harshwardhangiri/CV-Based-Robotic-Arm-TA212-/media/WhatsApp Image 2026-04-21 at 16.33.04.jpeg

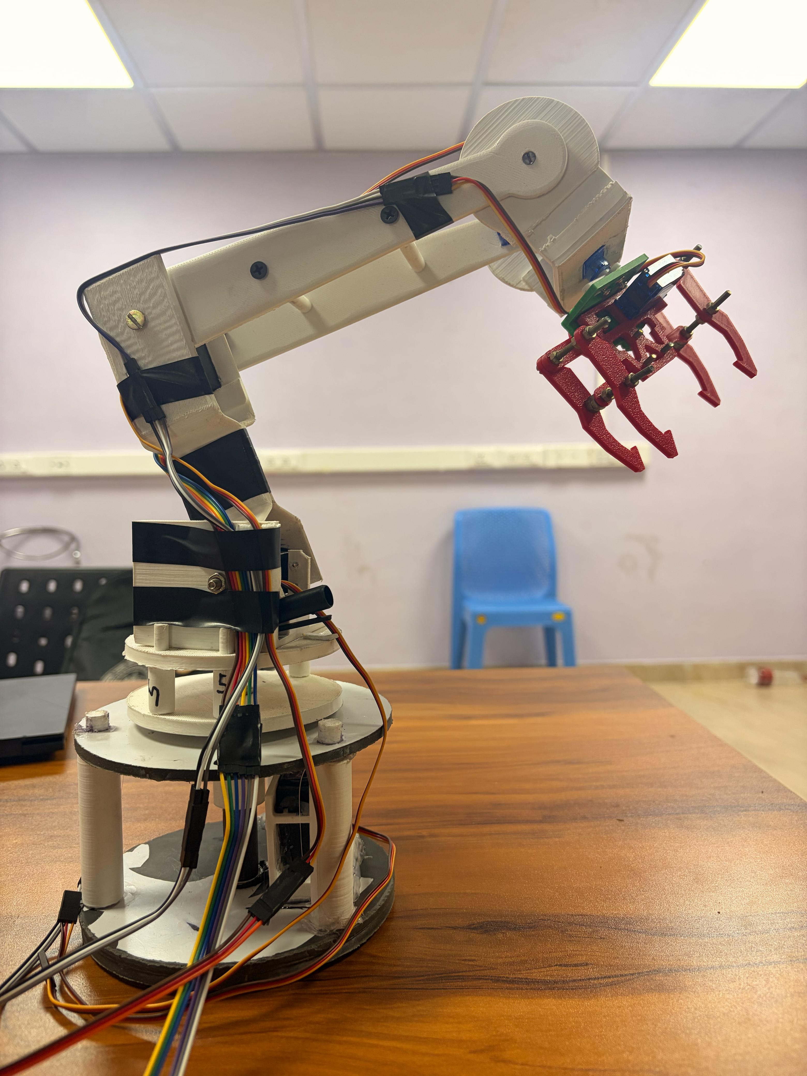
media/WhatsApp Image 2026-04-21 at 16.33.04.jpeg
