harshwardhangiri/CV-Based-Robotic-Arm-TA212-/Final Report G5.pdf

TA212

# Project Report

# Robotic Arm

# (Prof. Mohit Law)

# Group G5 (Tuesday)

## Bala Rohit (240255) Krishna Sharma (240564) Lakshya Arukiya (240589) Pradeep Bishnoi (240756) Harshwardhan Giri Goswami (240444) Ujjwal Raj (241112) Sunand Garg (241061)

Project Overview

The primary objective of this project is to develop an advanced 6-degree-of-freedom robotic arm that utilizes a computer vision interface for intuitive, contactless gesture-based control. The mechanical assembly consists of 21 distinct manufactured parts, featuring a robust foundation of ACP base plates and a high-density steel shaft to ensure structural stability during heavy base movements. While the out-of-pocket expenditure for newly purchased electrical components was strictly limited to ₹2,250, the actual comprehensive value of the prototype, factoring in all raw materials and extensive machining time for 3D printing and turning is calculated at ₹6,155. Potential future improvements for this system could focus on integrating high-resolution encoders for closed-loop positional feedback to eliminate servo jitter and implementing a wireless communication protocol to allow for remote operation in hazardous environments.

Table of Contents

S. No. | Content | Page No.
1 | Project Overview | 1
2 | Isometric Full View | 2
3 | Components Used | 3-4
4 | Detailed Torque Calculation | 5-6
5 | Orthographic Drawings | 7-23
6 | Circuit Diagram | 24
7 | Codes | 25-30
8 | Code Explanation | 31-34
9 | Bill of Materials and Cost Analysis | 35

# Isometric Full view

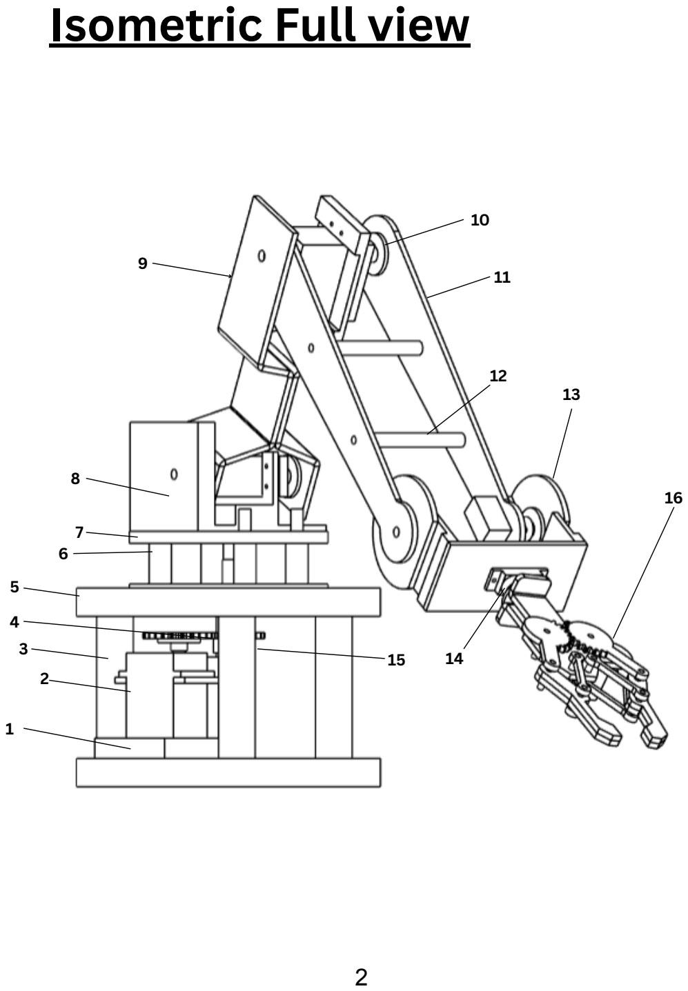
[picture p3: page 3]

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
15 14

16

Part no. | Part Name | Material | Qty
1 | Mounting 1 | 3D Printed | 1
2 | Servo (MG996R) | Purchased | 3
3 | Base Support | 3D Printed | 3
4 | Gear (a,b) | 3D Printed | 2
5 | Base plate A | ACP sheet | 2
6 | Spacer plate | 3D Printed | 3
7 | Base plate B | 3D Printed | 2
8 | Mounting 2 | 3D Printed | 1
9 | Arm (a,b) | 3D Printed | 2
10 | Motor Head | Purchased | 6
11 | Front Arm (a,b) | 3D Printed | 2
12 | Upper Arm Spacer | 3D Printed | 2
13 | Wrist Assemble | 3D Printed | 1
14 | Servo Motor (SG90) | Purchased | 3

15 | shaft | Metal | 1
16 | Gripper | 3D Printed | 1

## Detailed Torque Calculation and rationale for usage of electronics

### 1. Mass Estimation

Component | Mass (kg)
Upper Arm (PLA) | 0.04
Forearm (PLA) | 0.04
Wrist + Gripper | 0.05
MG996R Motors (3) | 0.165
SG90 Motors (3) | 0.027

### 2. Torque Formula

Torque is calculated using: τ = Σ(m × g × r), where g = 9.81 m/s².

### 3.1 Gripper Joint

τ = W × 9.81 × 0.05
Setting τ = 0.25 N·m ⇒ W = 0.25 / (9.81 × 0.05) ≈ 0.51 kg

### 3.2 Wrist Joint

τ = (0.059 + W) × 9.81 × 0.1 ⇒ (0.059 + W) × 0.981 = 0.25 ⇒ W ≈ 0.196 kg

### 3.3 Elbow Joint

τ = (0.04×9.81×0.09) + (0.05×9.81×0.18) + (0.009×9.81×0.18) + (W×9.81×0.2) τ = 0.139 + 1.962W
⇒ 0.139 + 1.962W = 1.08
⇒ W ≈ 0.48 kg

### 3.4 Shoulder Joint (Critical)

τ = (0.04×9.81×0.075) + (0.04×9.81×0.20) + (0.05×9.81×0.30) + (0.11×9.81×0.25) + (0.027×9.81×0.30) + (W×9.81×0.33)

τ = 0.603 + 3.237W
⇒ 0.603 + 3.237W = 1.08
⇒ W ≈ 0.147 kg

### 4. Final Result

Maximum payload is limited by shoulder joint ≈ 120–150 grams.

### 5. Electronics Justification

Arduino Uno is used for control and serial communication. PCA9685 driver ensures stable multi-servo PWM control at 50 Hz. Python + OpenCV enables gesture recognition.
Li-ion batteries provide sufficient current for servo motors.

### 7. Conclusion

The system is torque-limited at the shoulder joint. The design is optimized for lightweight operation and gesture-based control.

44 27 25

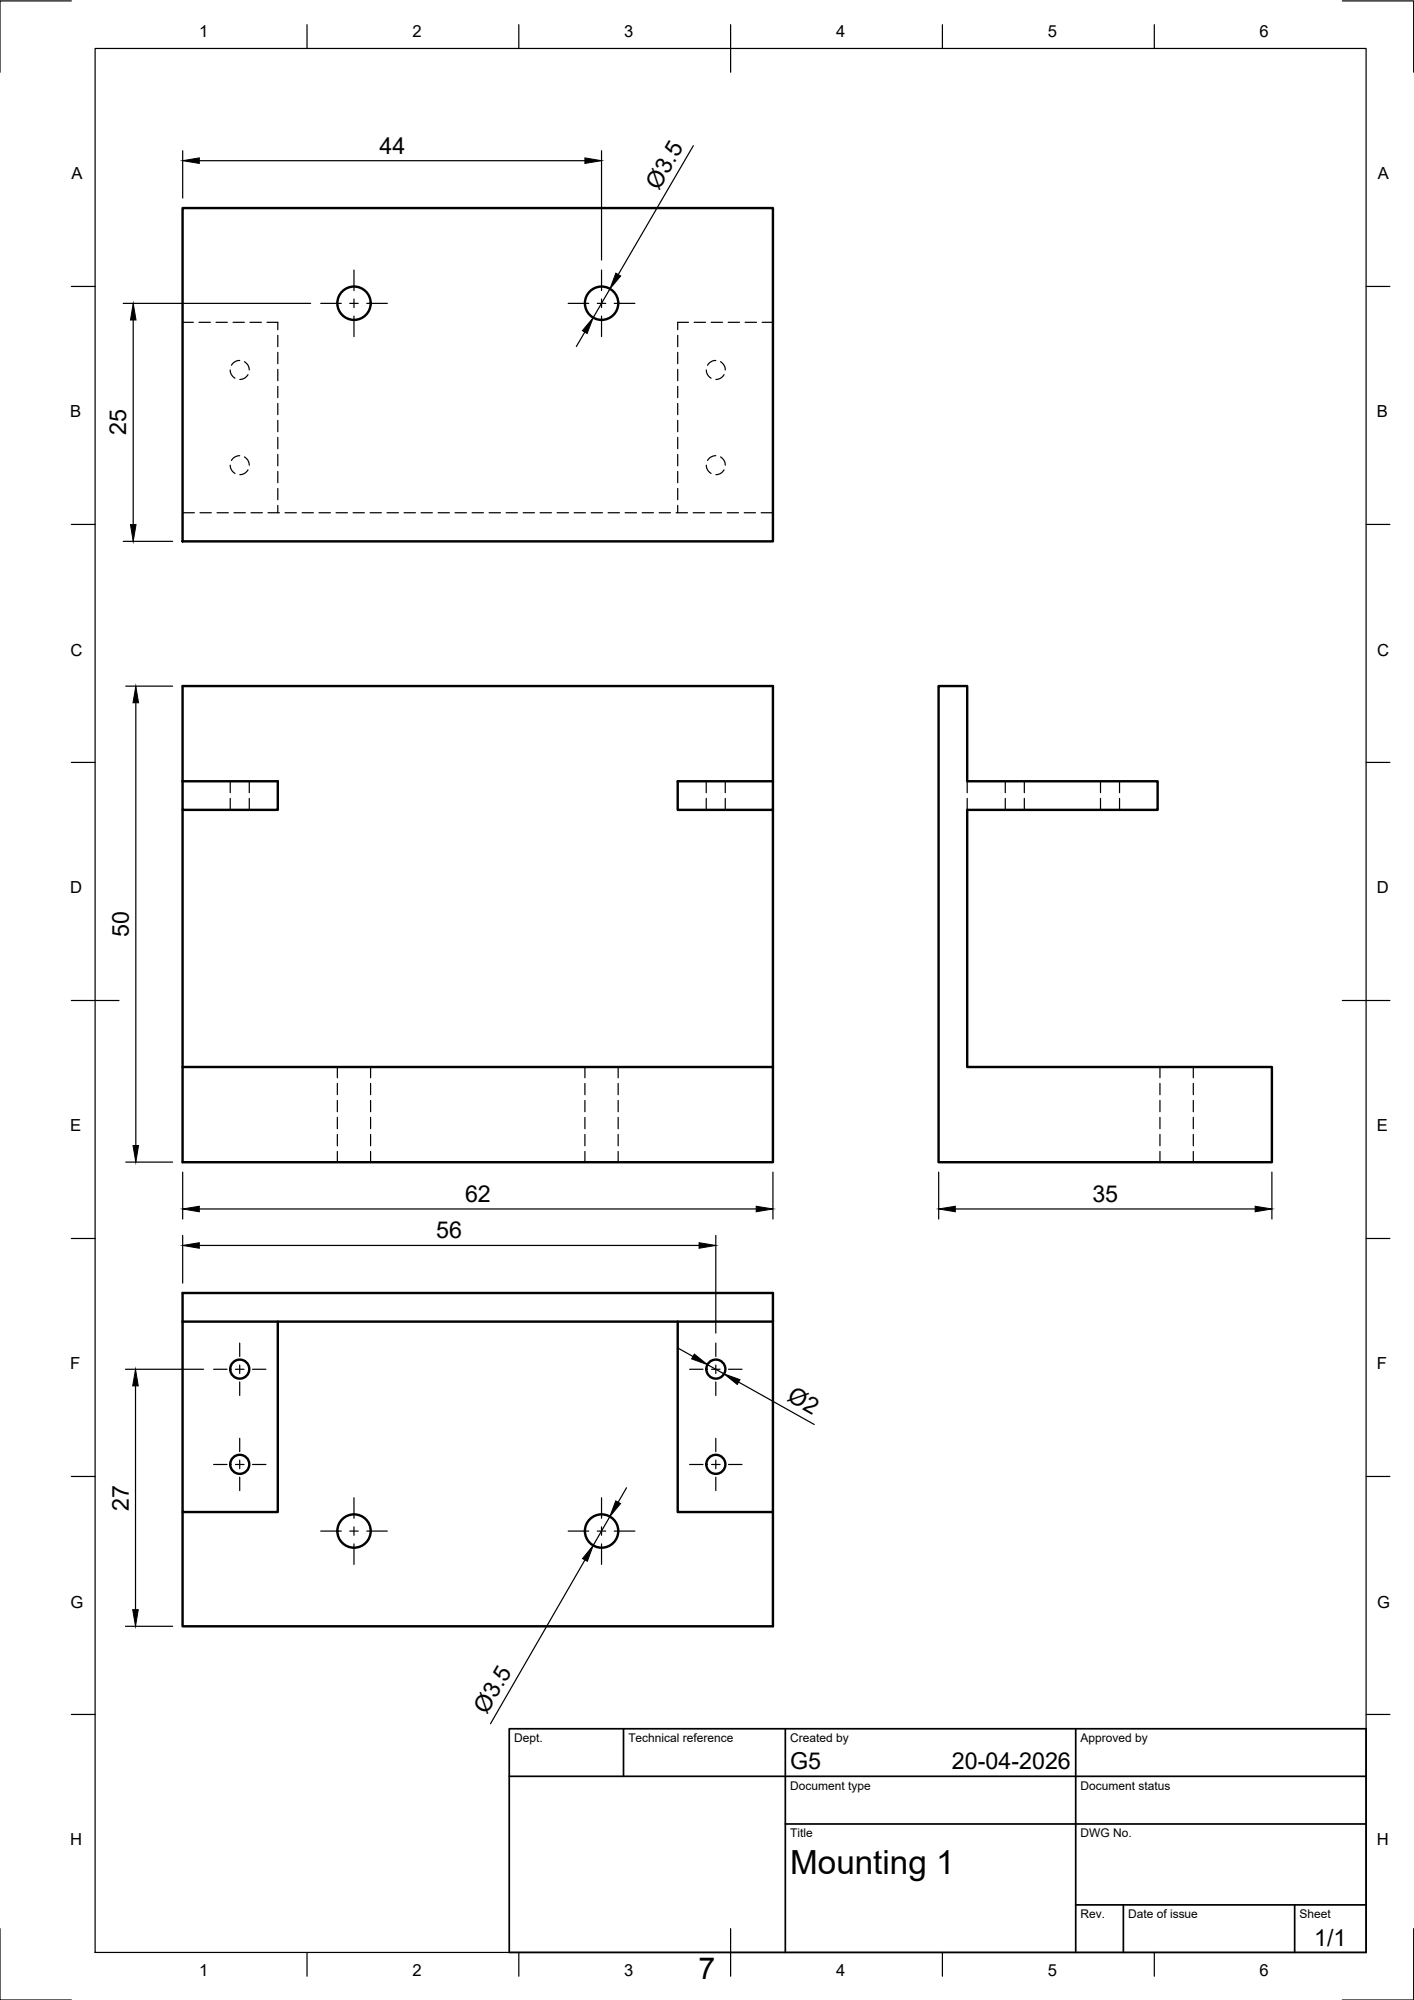
[picture p4: page 8]
Dept.; Technical reference; Created by; Approved by; Document type; Document status; Title; DWG No.; Rev.; Date of issue; Sheet; Mounting 1

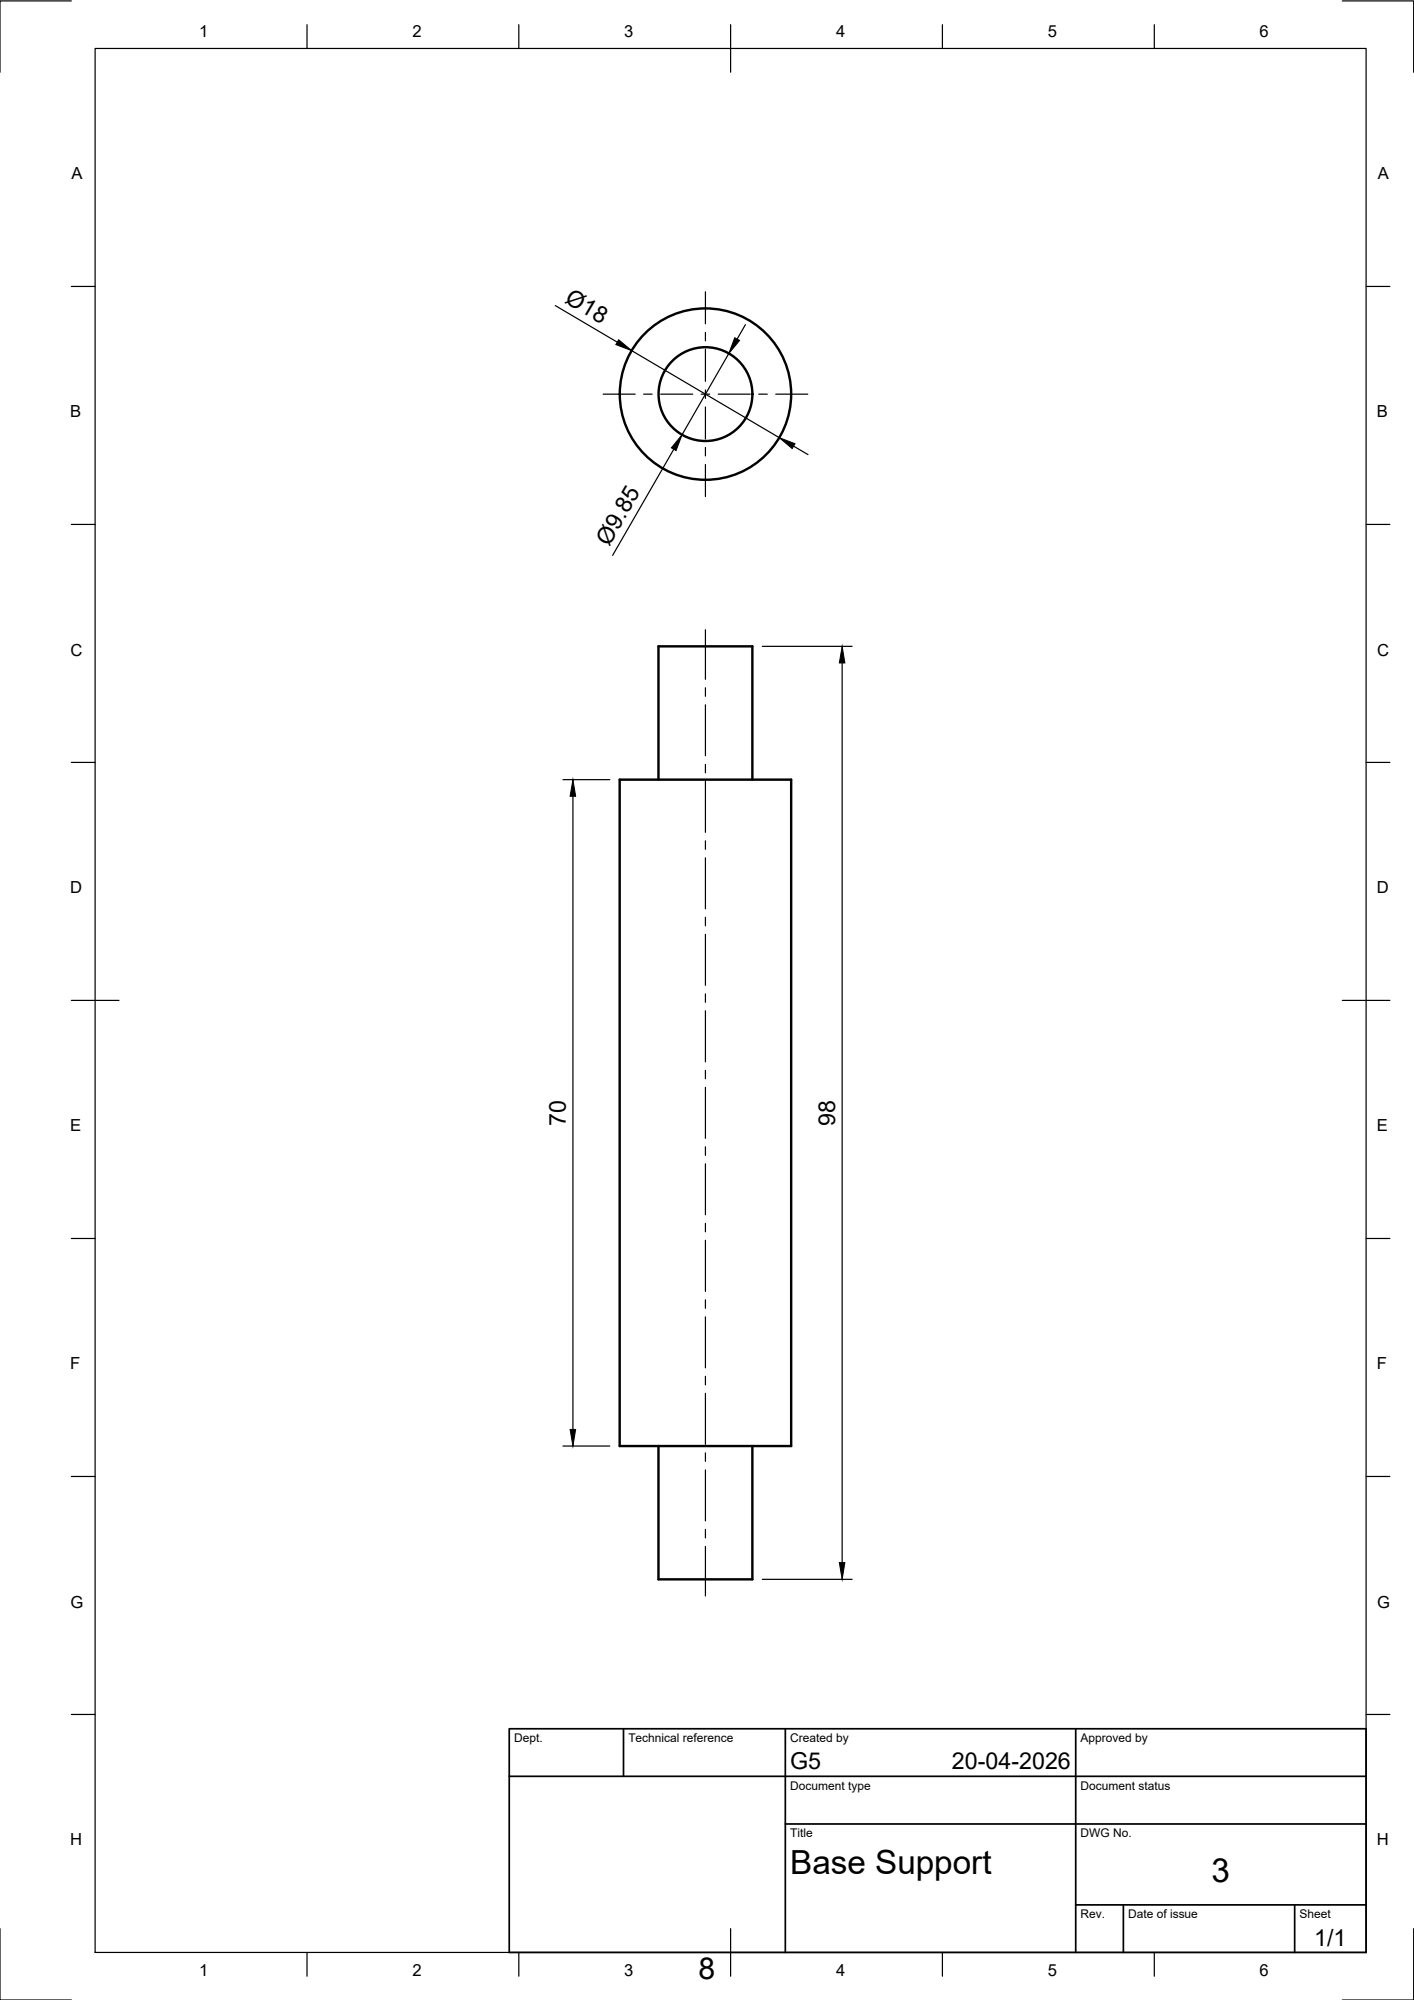
[picture p5: page 9]
Dept.; Technical reference; Created by; Approved by; Document type; Document status; Base Support

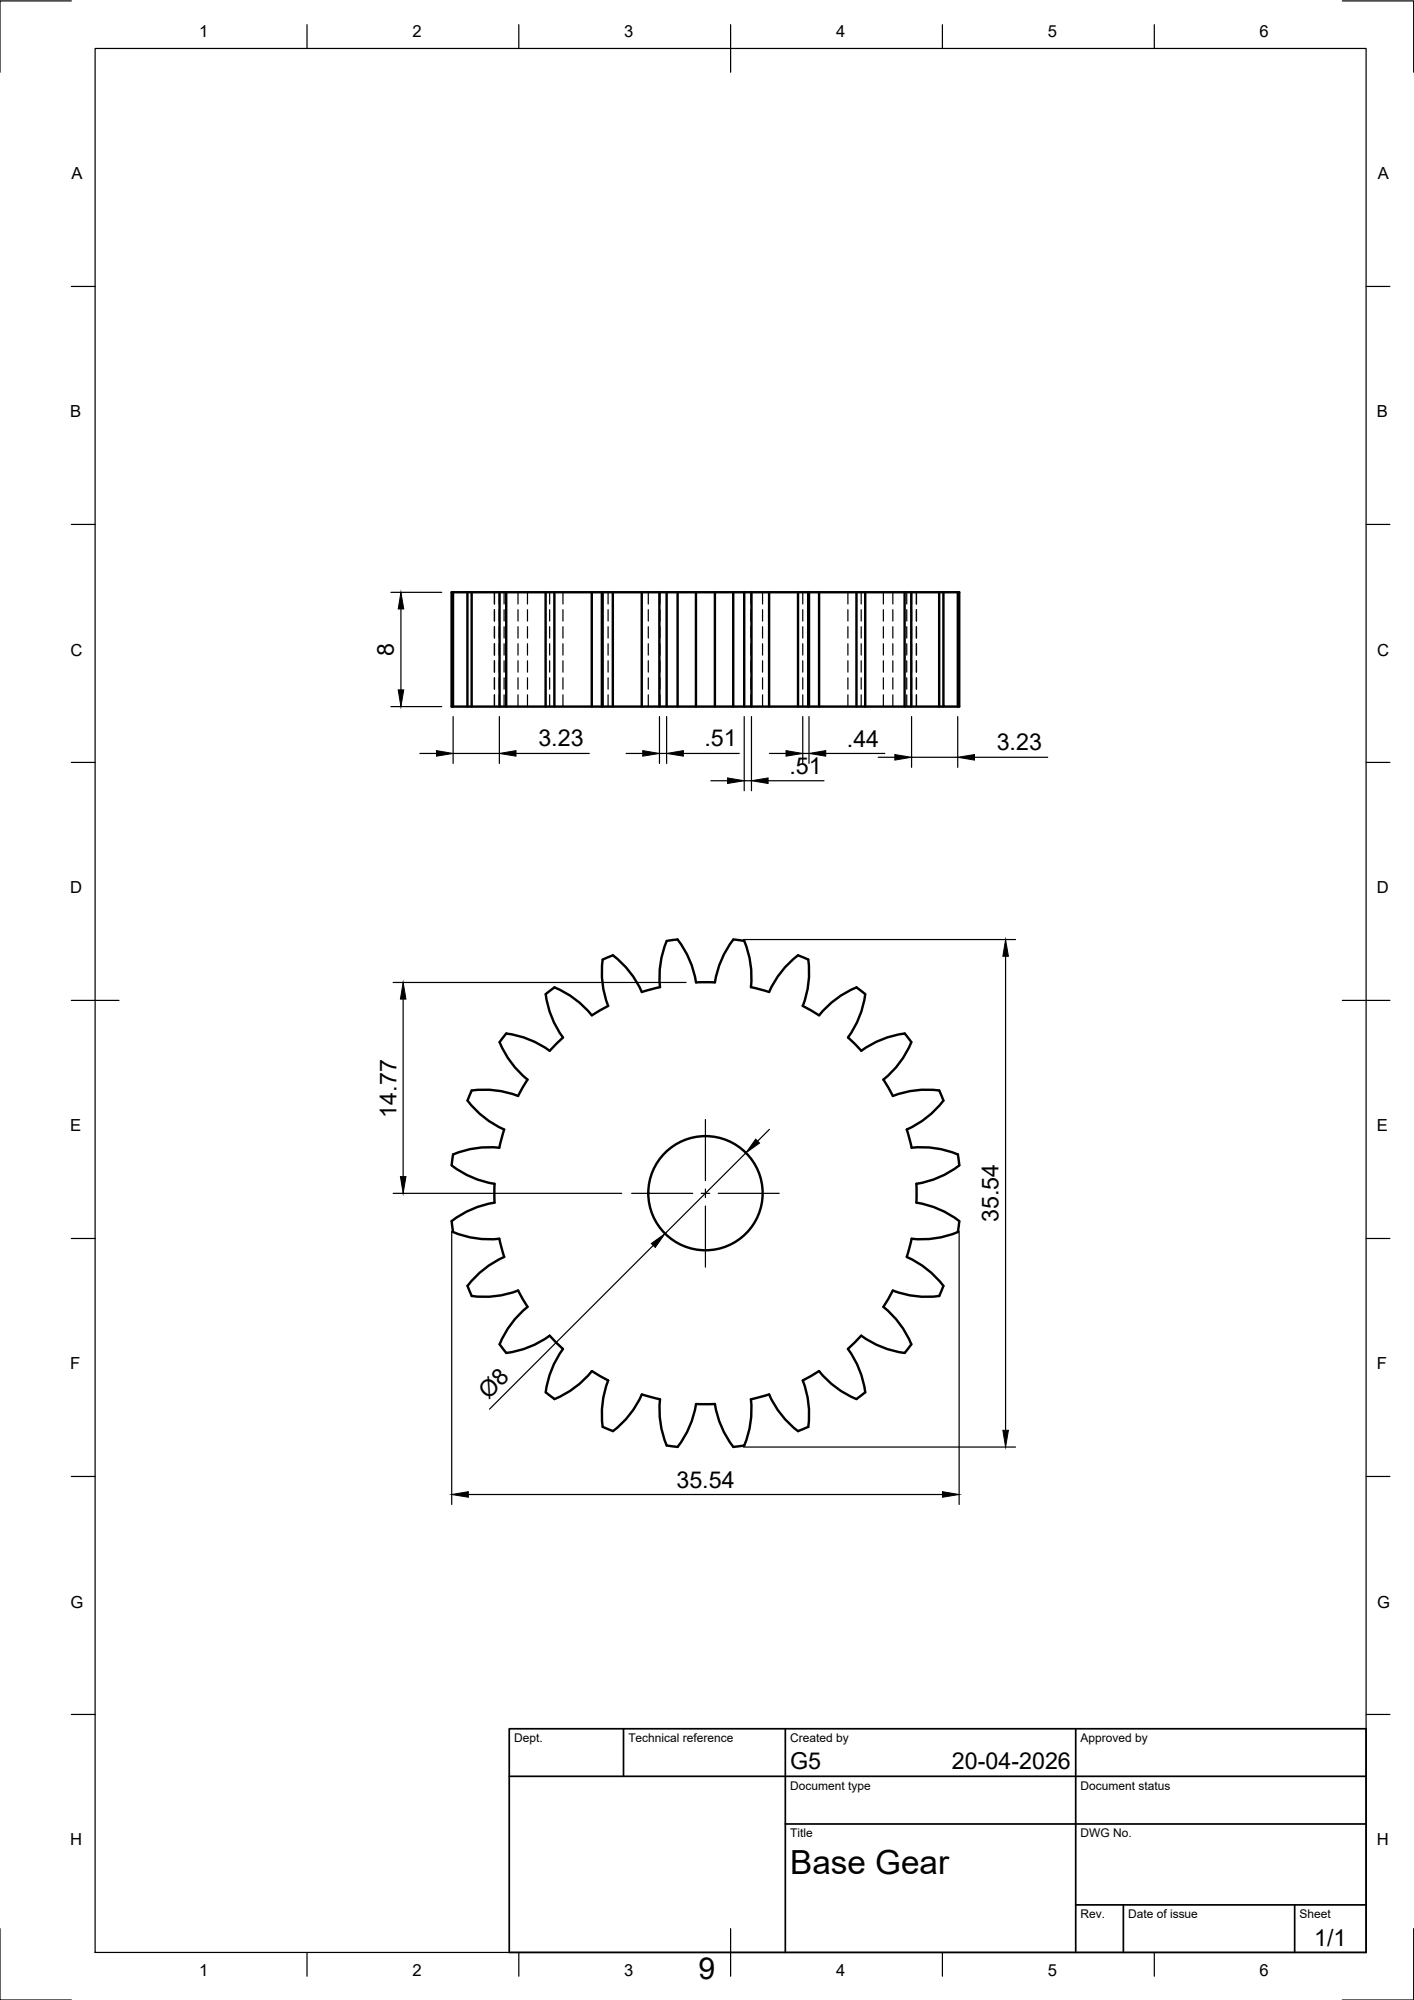
[picture p6: page 10]
Dept.; Technical reference; Created by; Approved by

Document type | Document status

Base Gear

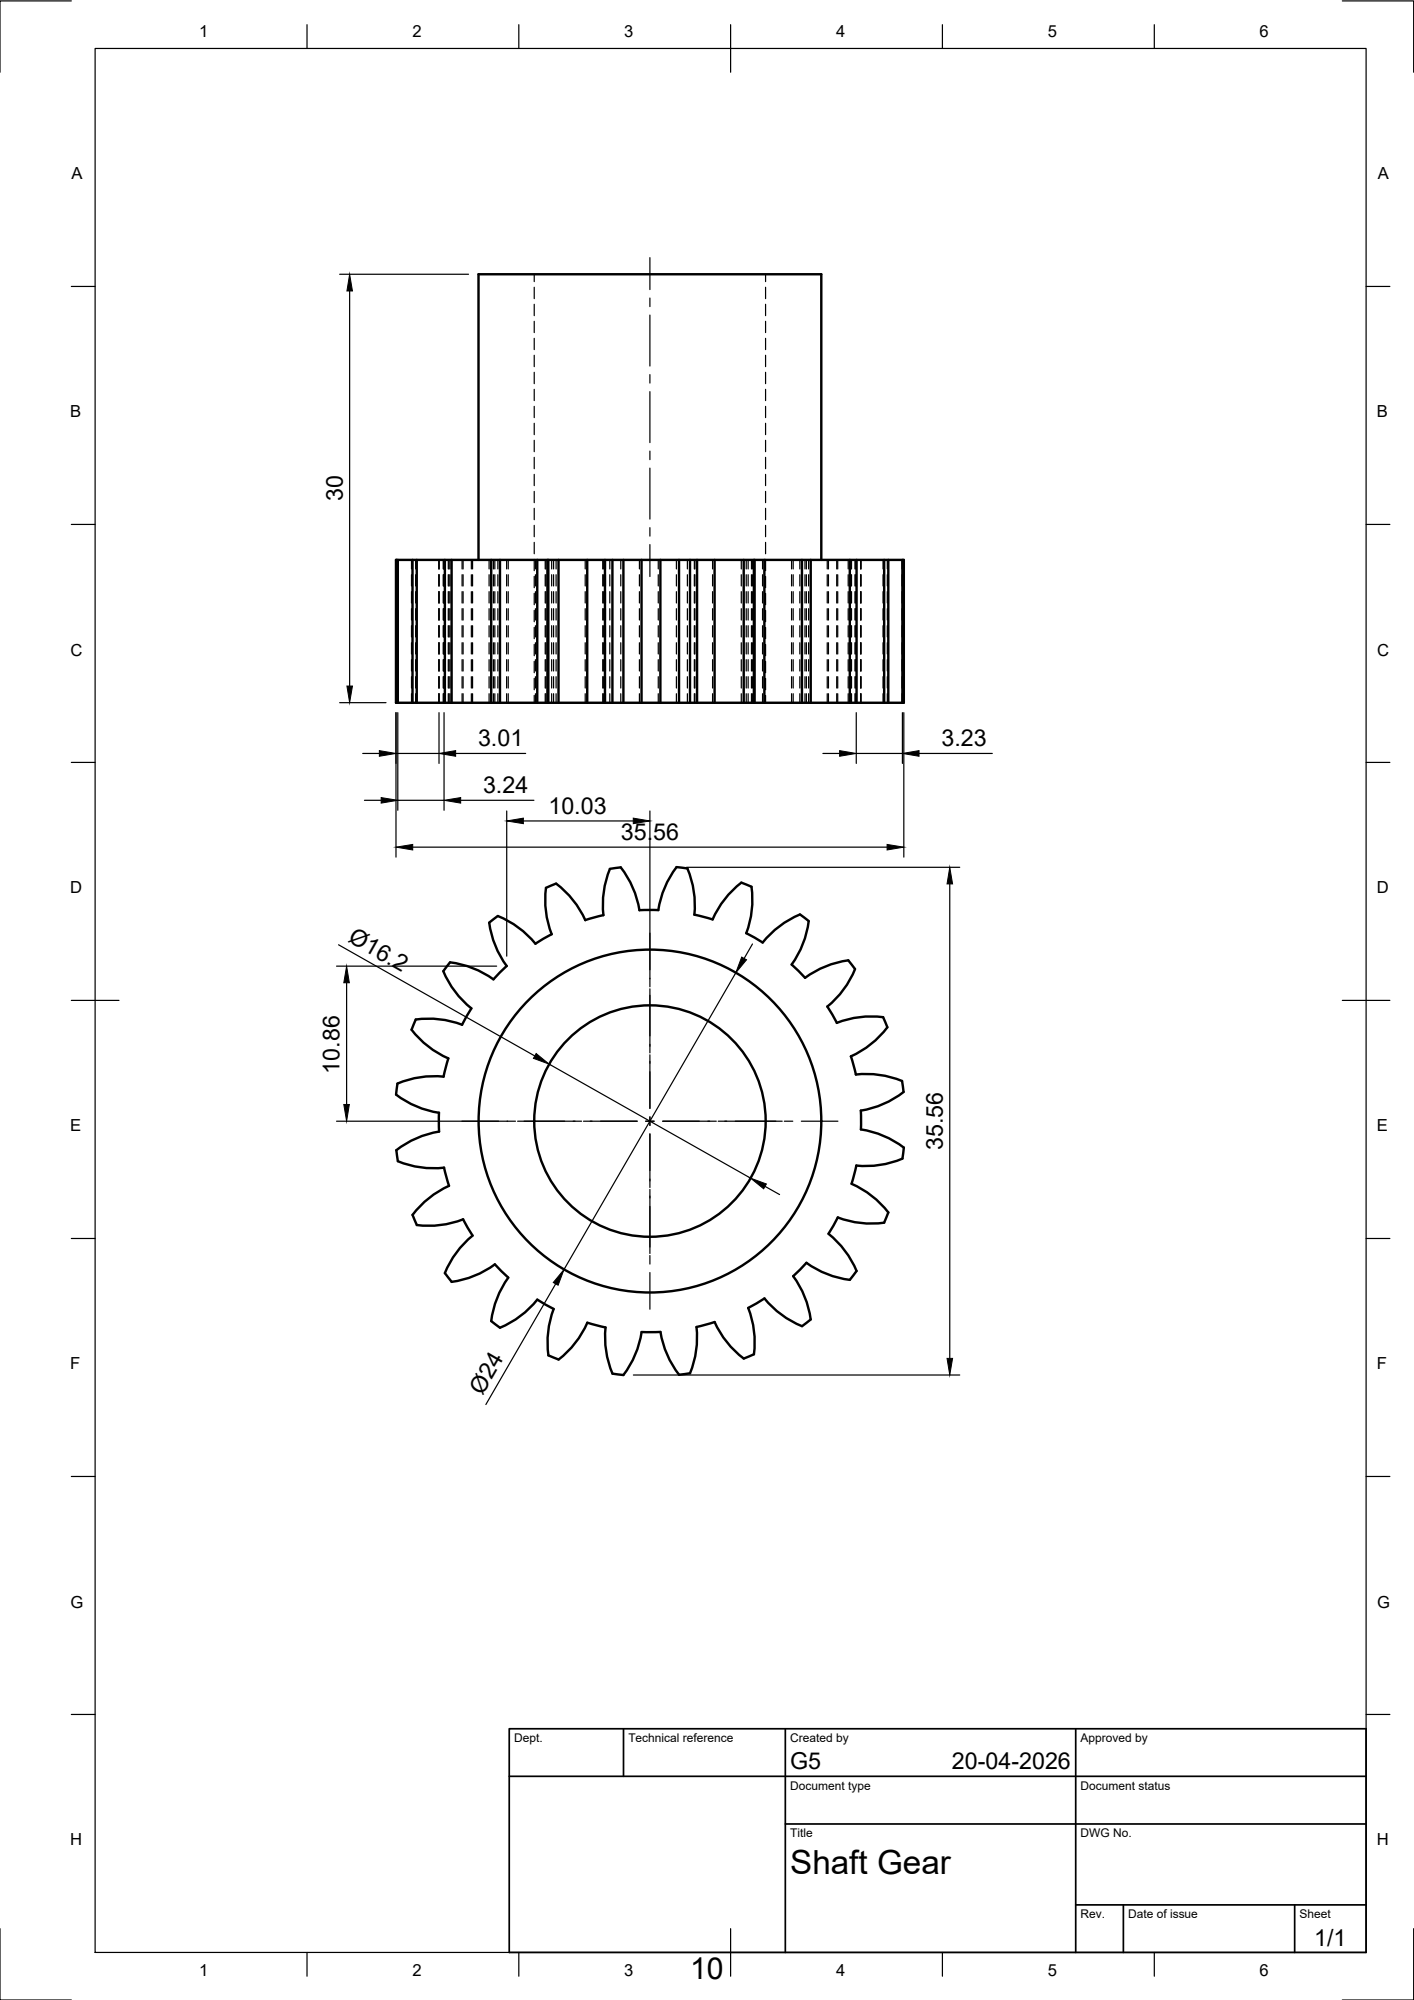
[picture p7: page 11]
Dept.; Technical reference; Created by; Approved by

Document type | Document status

Shaft Gear

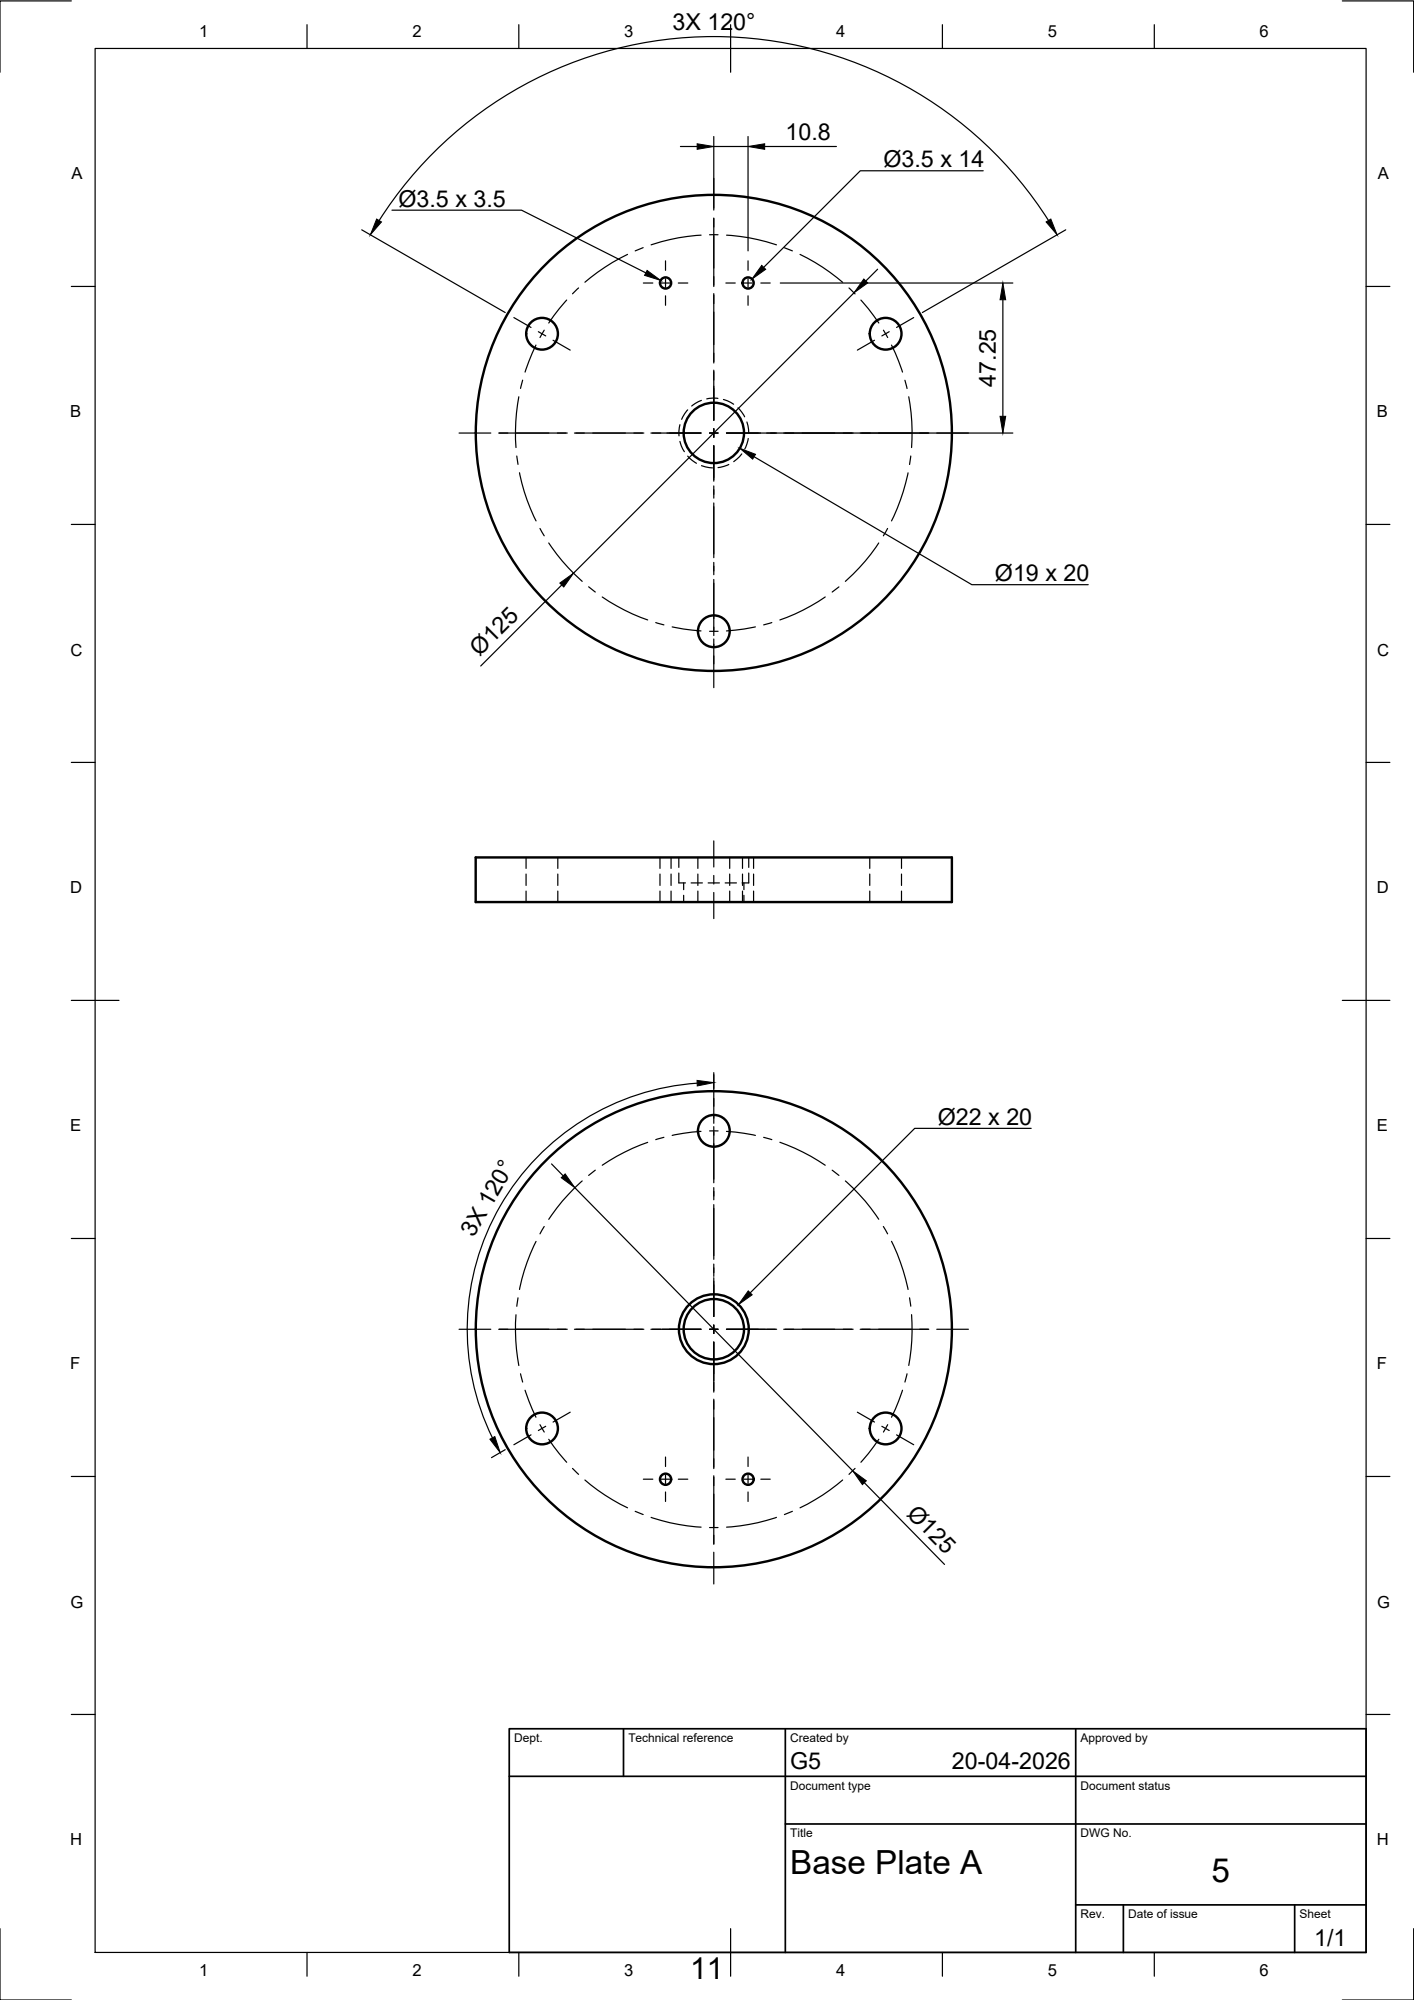
[picture p8: page 12]
Dept.; Technical reference; Created by; Approved by; Document type; Document status; Base Plate A

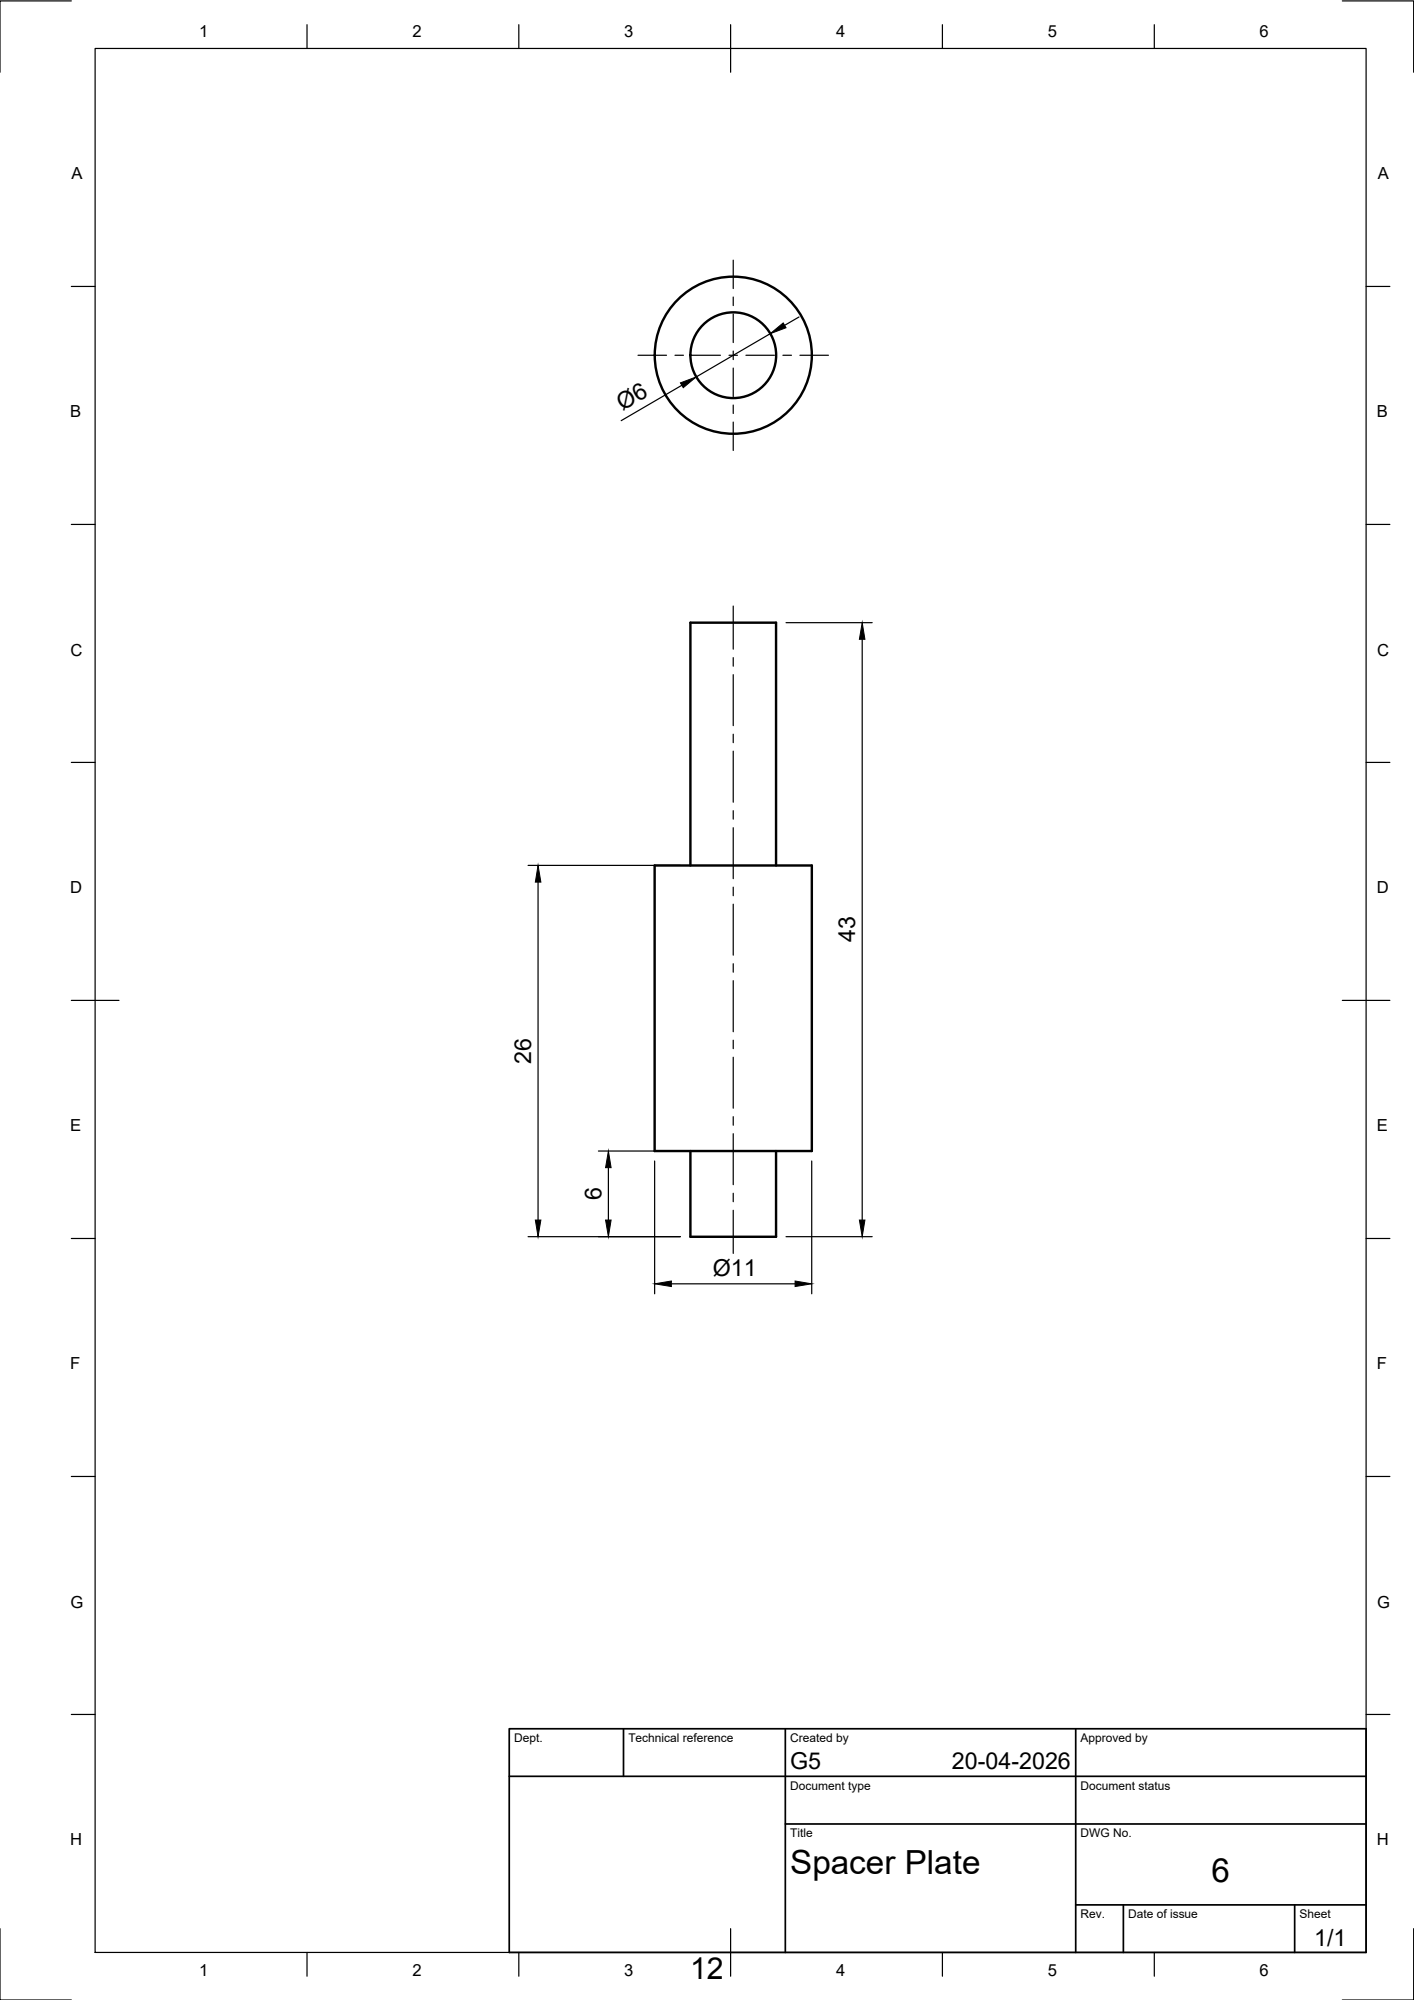
[picture p9: page 13]
Dept.; Technical reference; Created by; Approved by; Document type; Document status; Spacer Plate

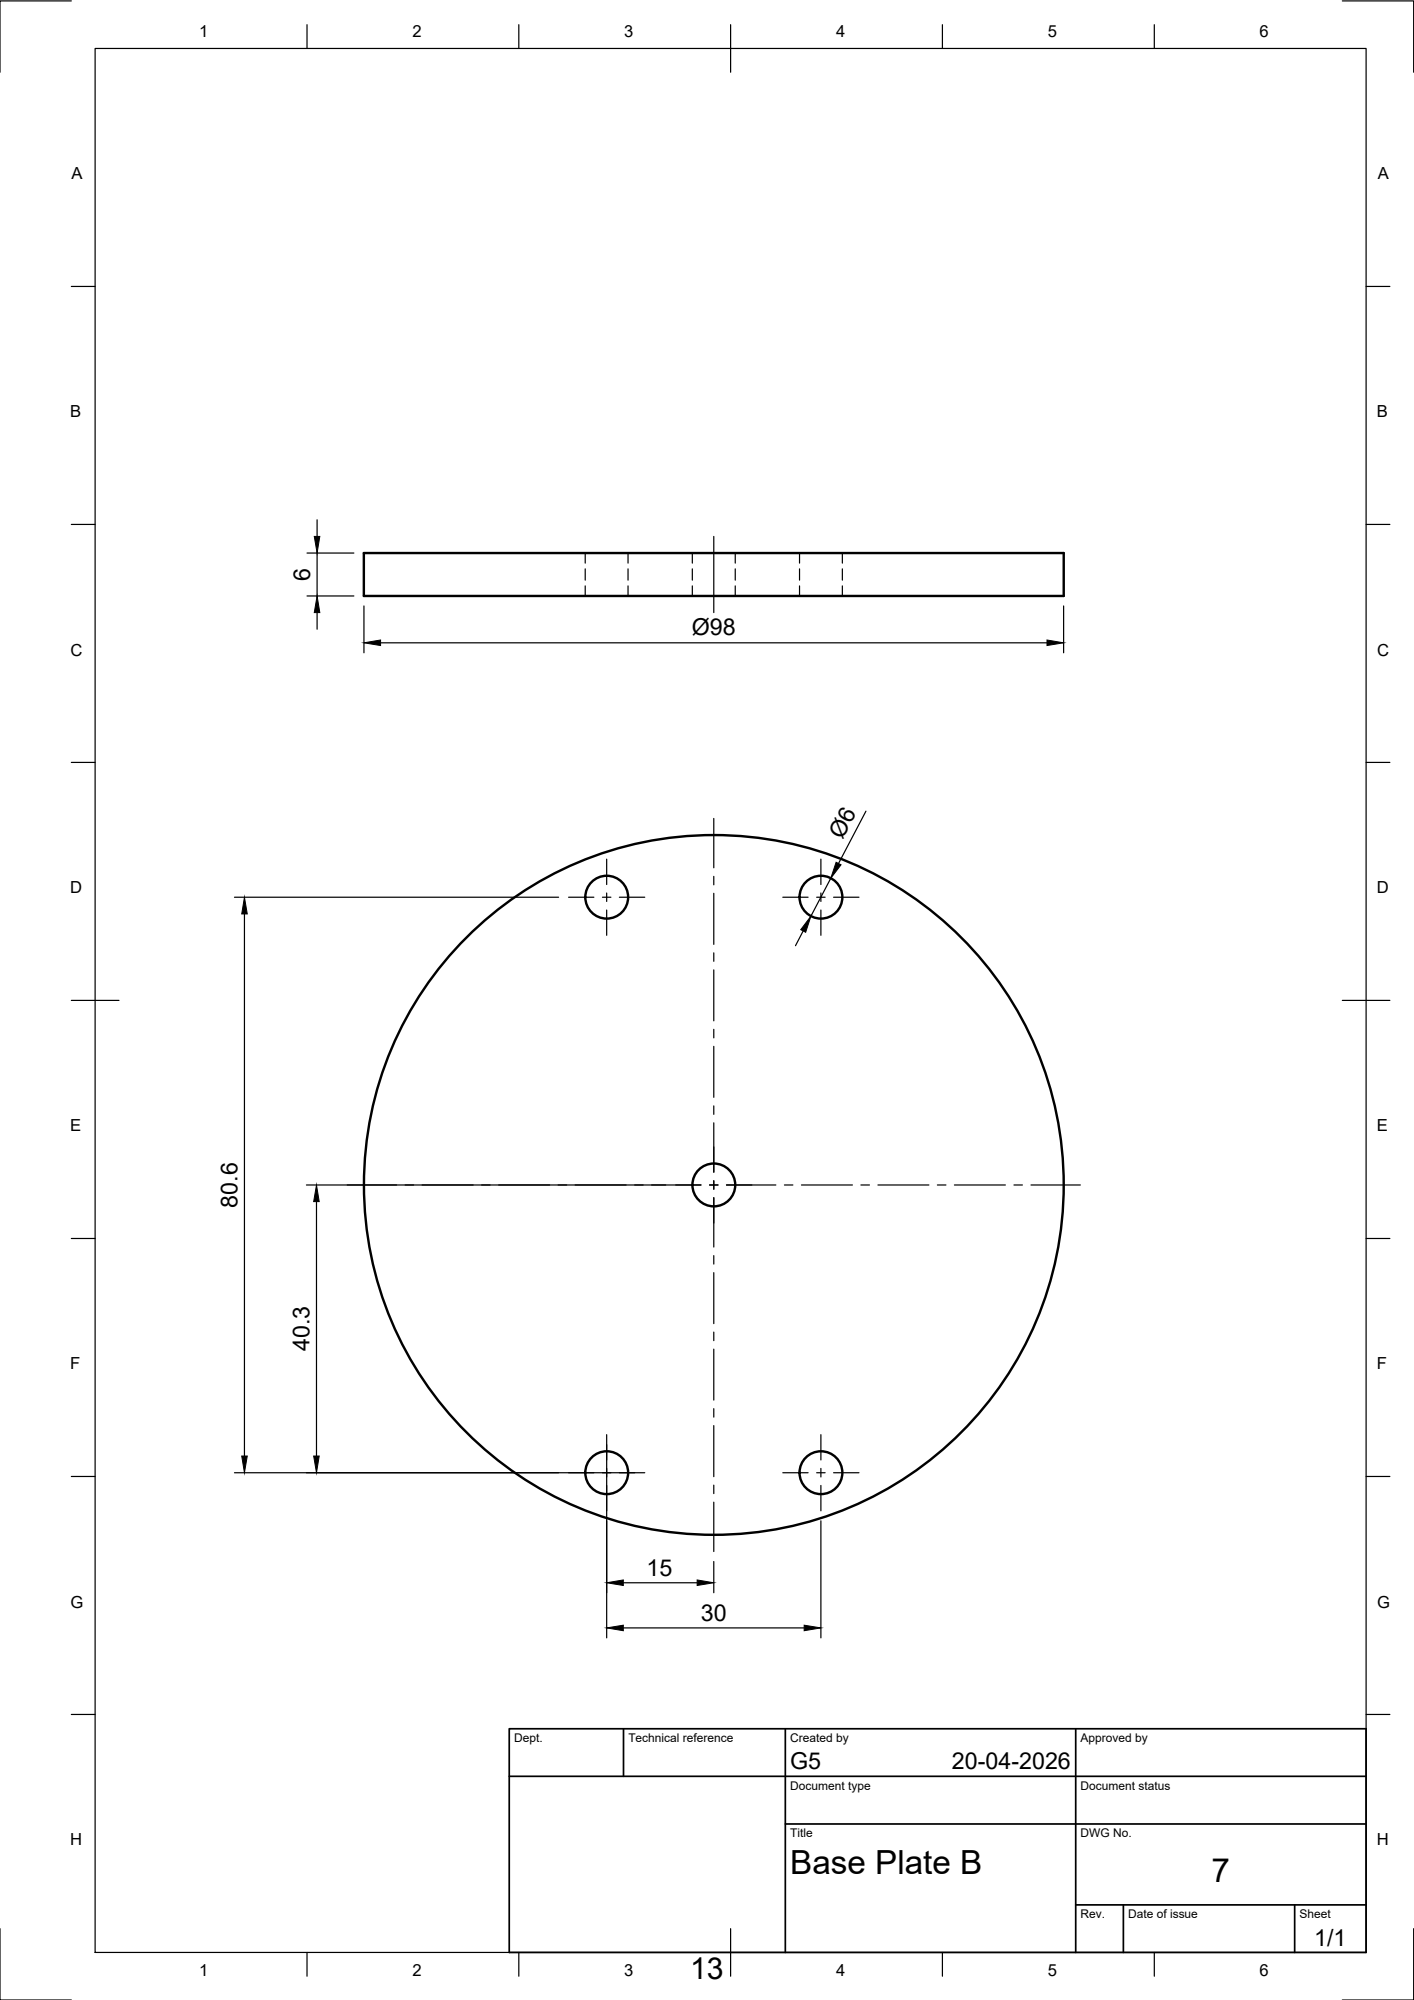
[picture p10: page 14]
Dept.; Technical reference; Created by; Approved by; Document type; Document status; Base Plate B

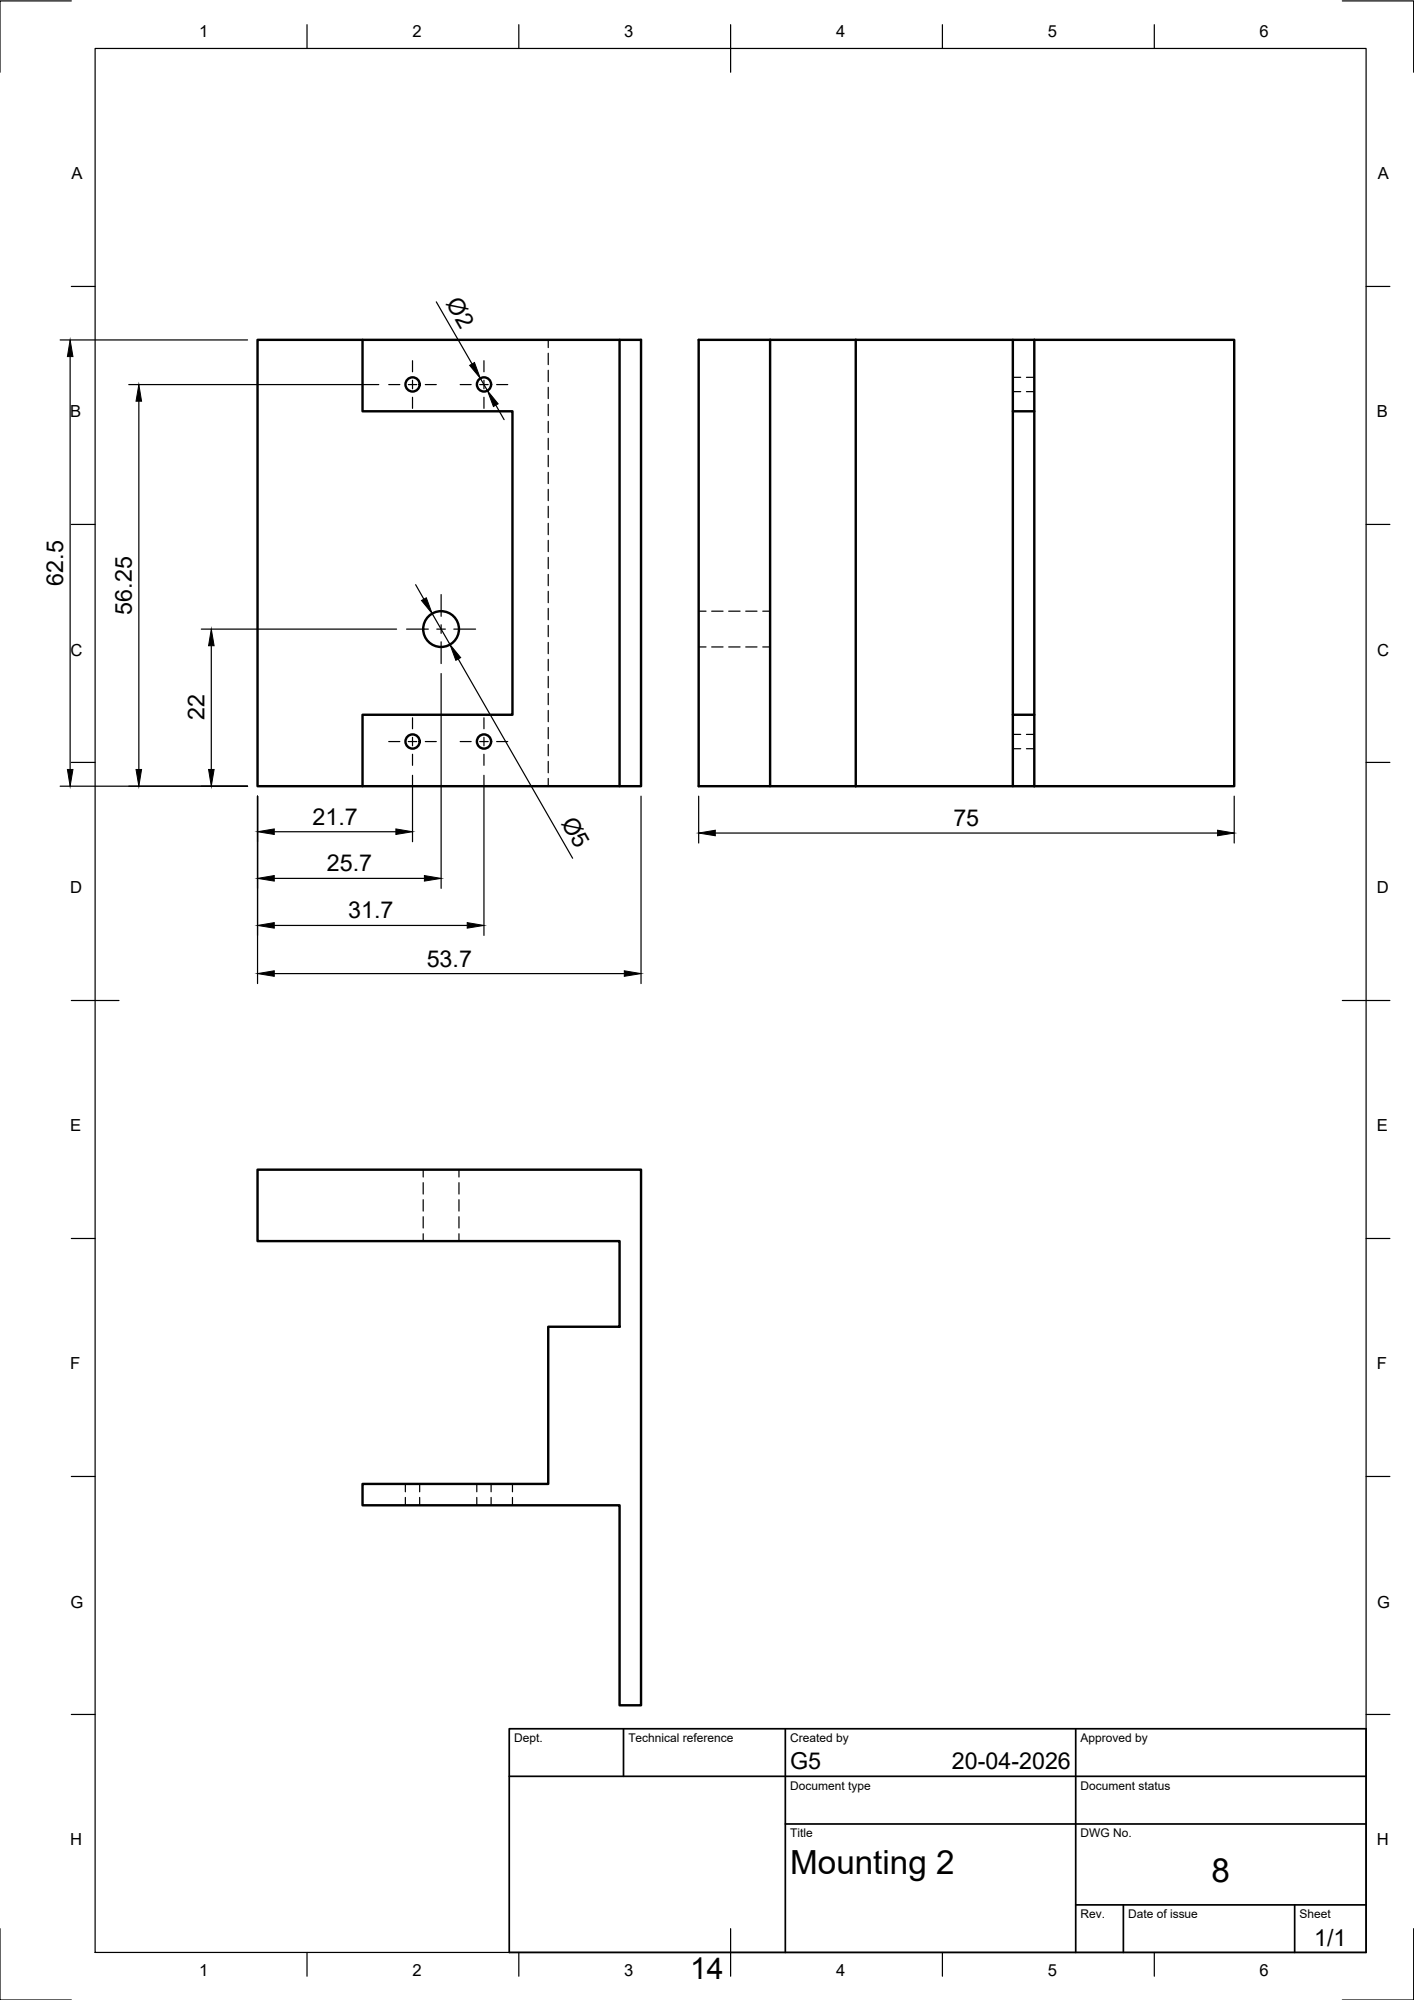
[picture p11: page 15]
Dept.; Technical reference; Created by; Approved by

Document type | Document status

Mounting 2 | 8

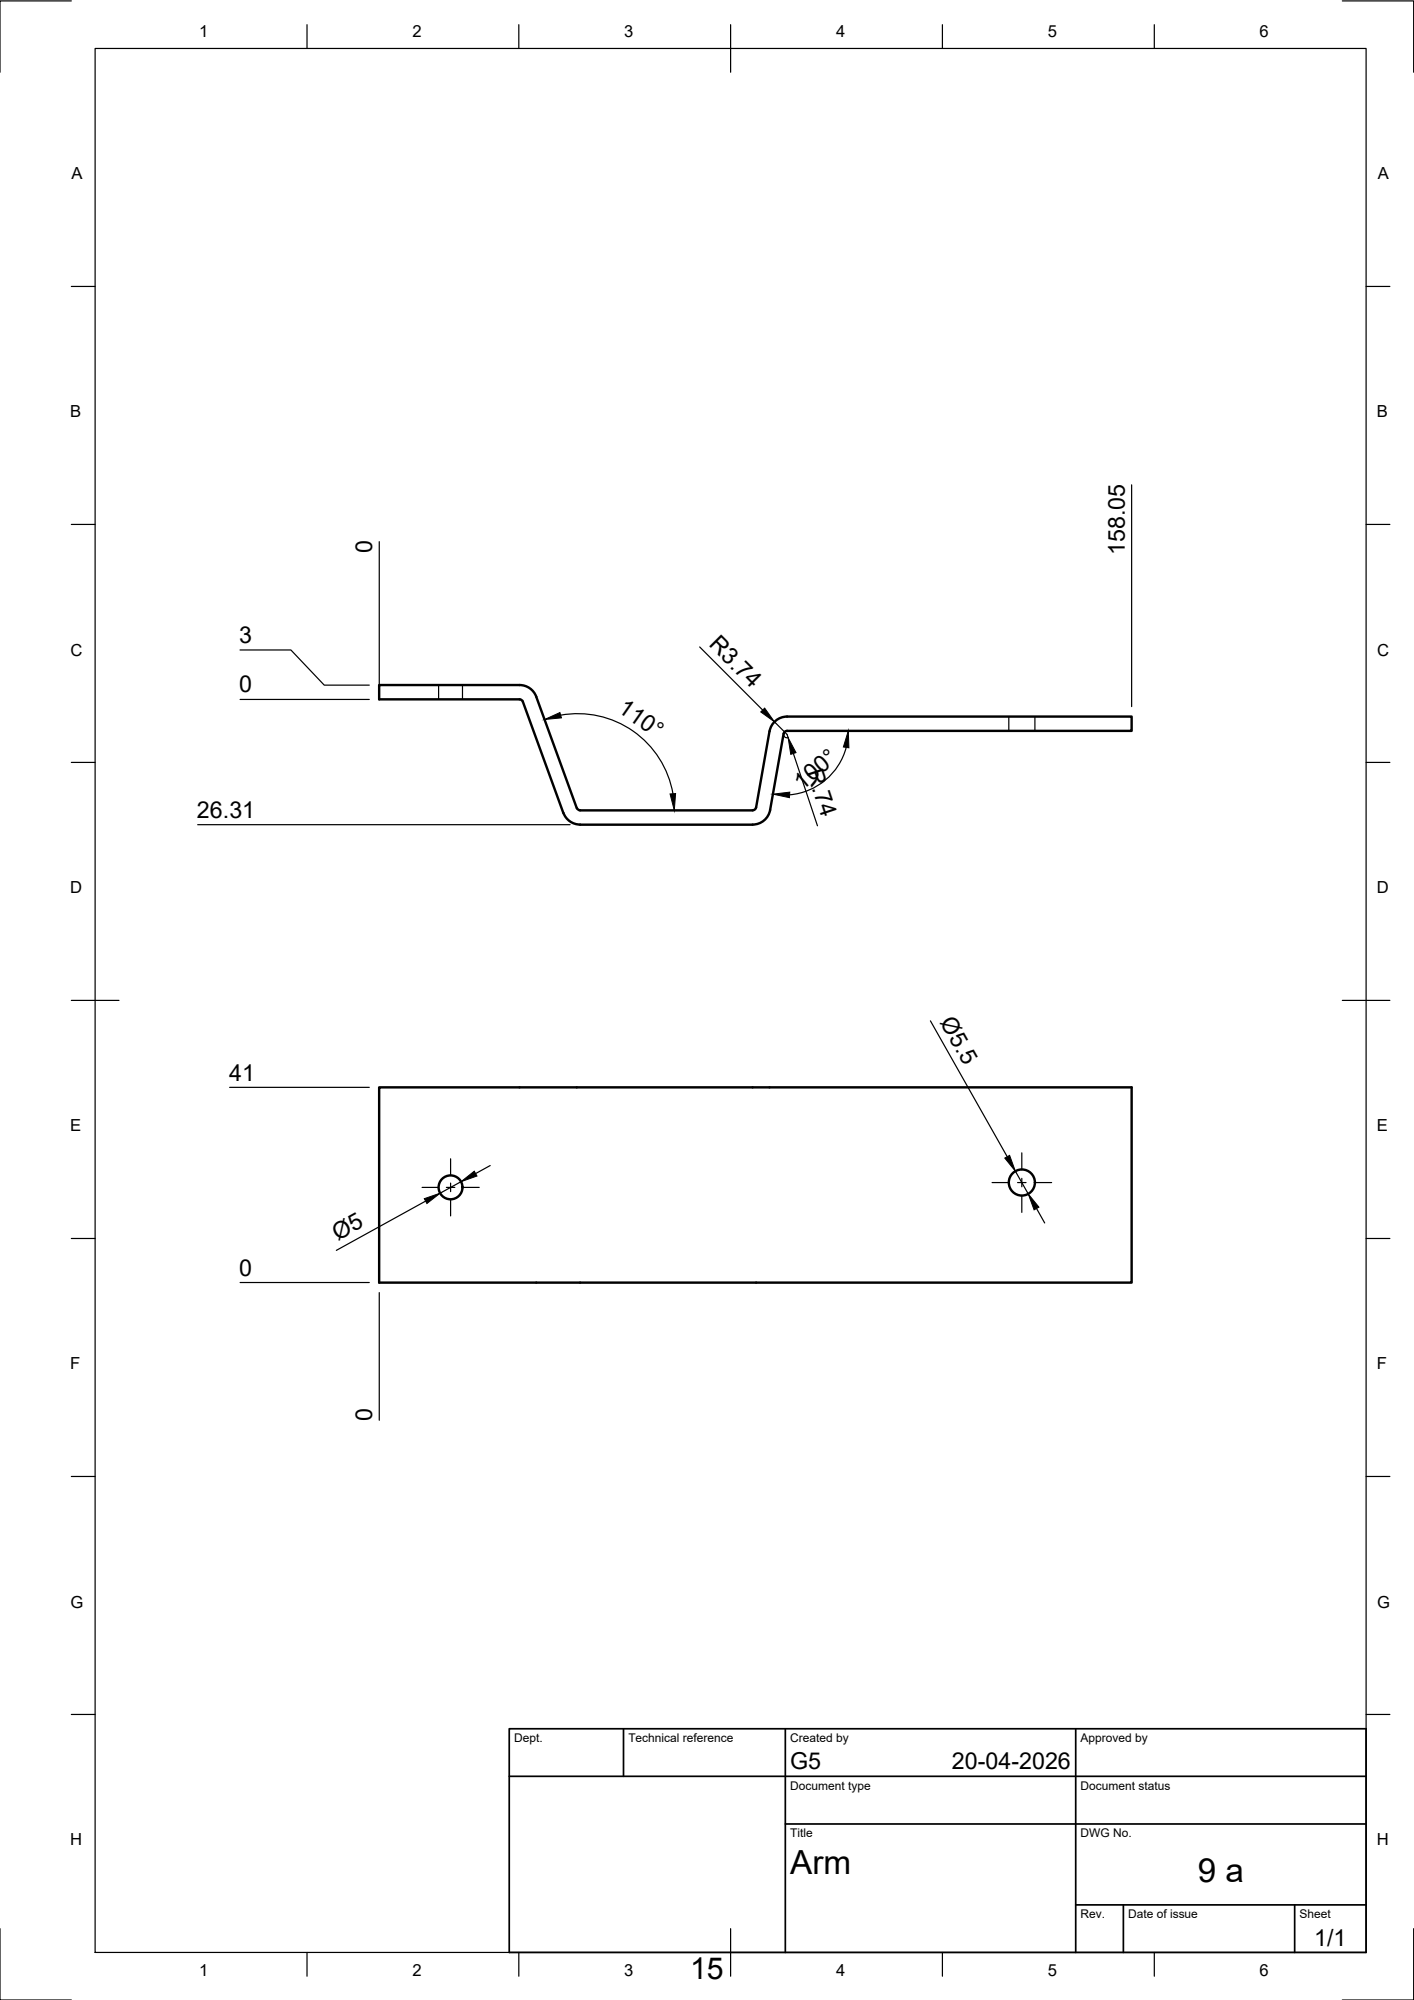
[picture p12: page 16]
Dept.; Technical reference; Created by; Approved by; Document type; Document status; Arm

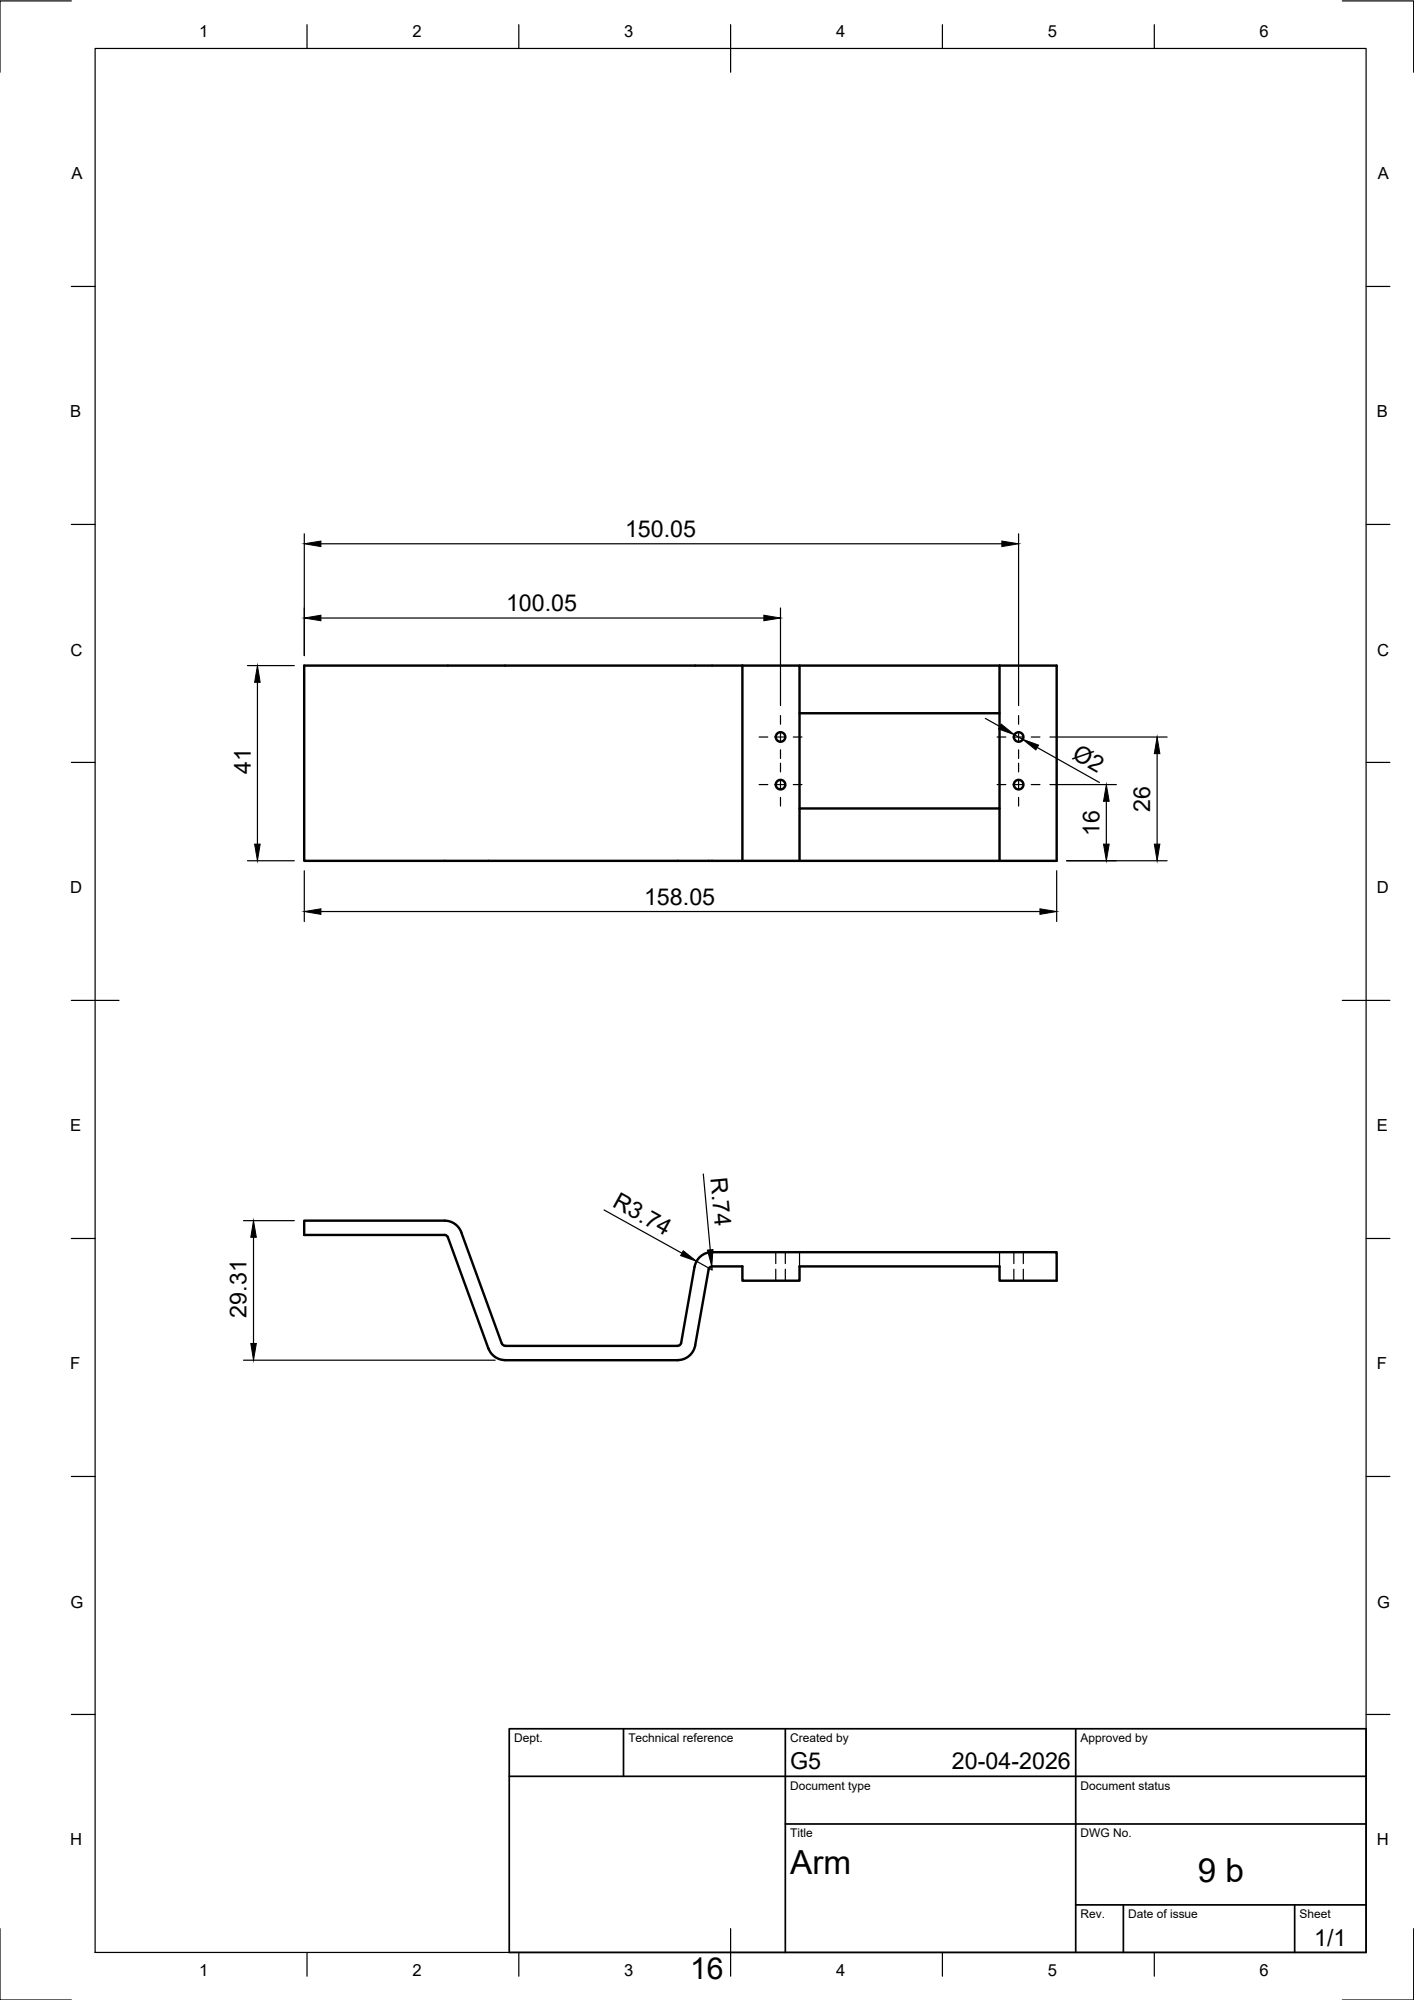
[picture p13: page 17]
Dept.; Technical reference; Created by; Approved by; Document type; Document status; Arm

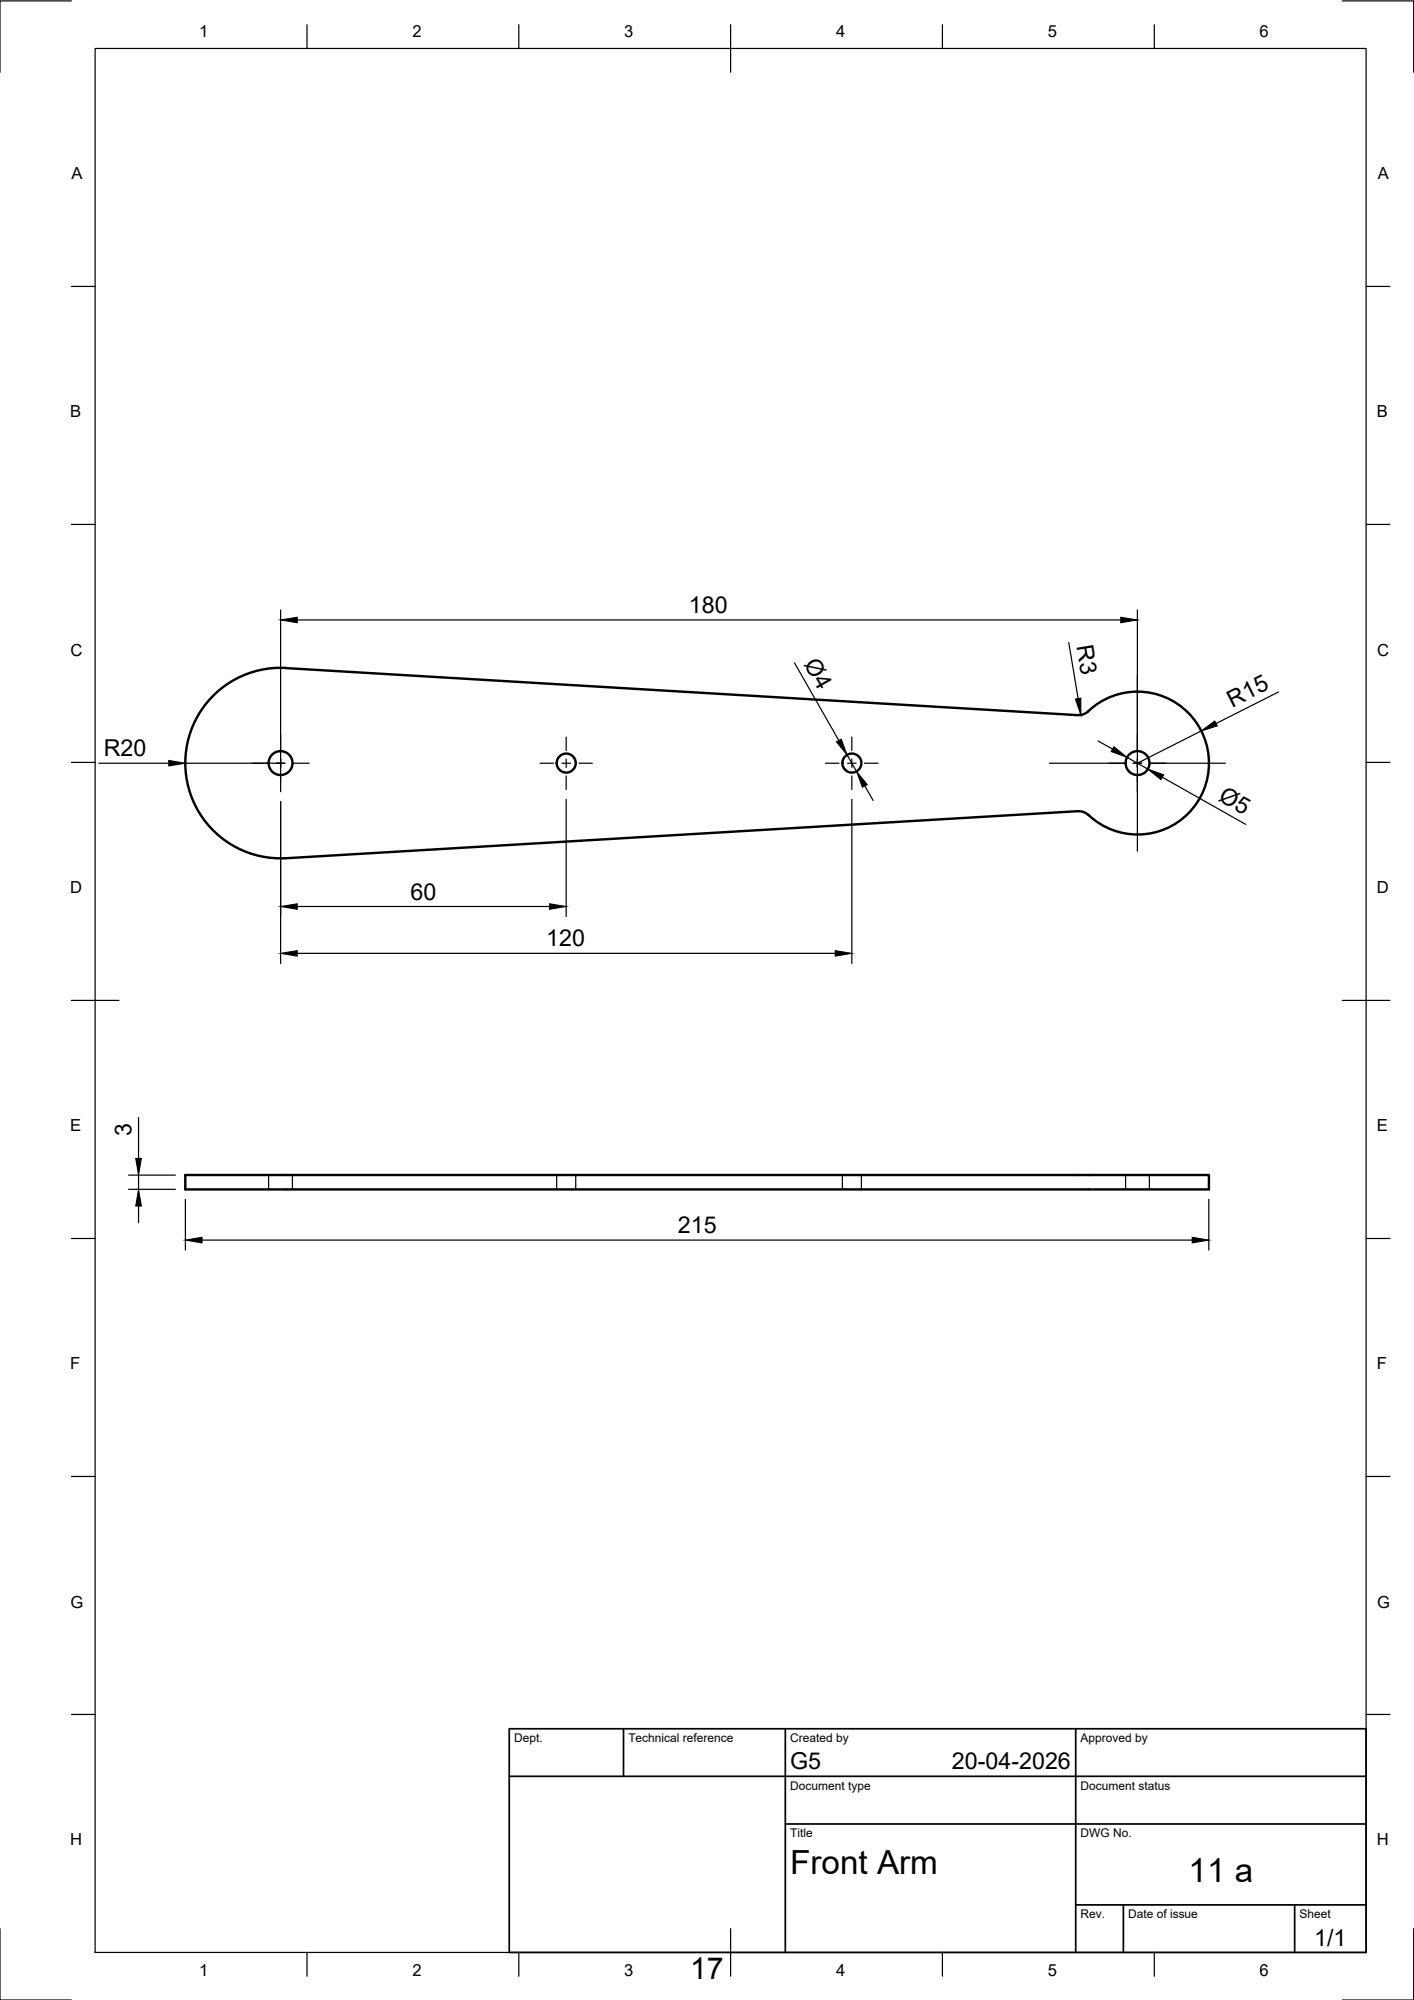
[picture p14: page 18]
Dept.; Technical reference; Created by; Approved by; Document type; Document status; Front Arm

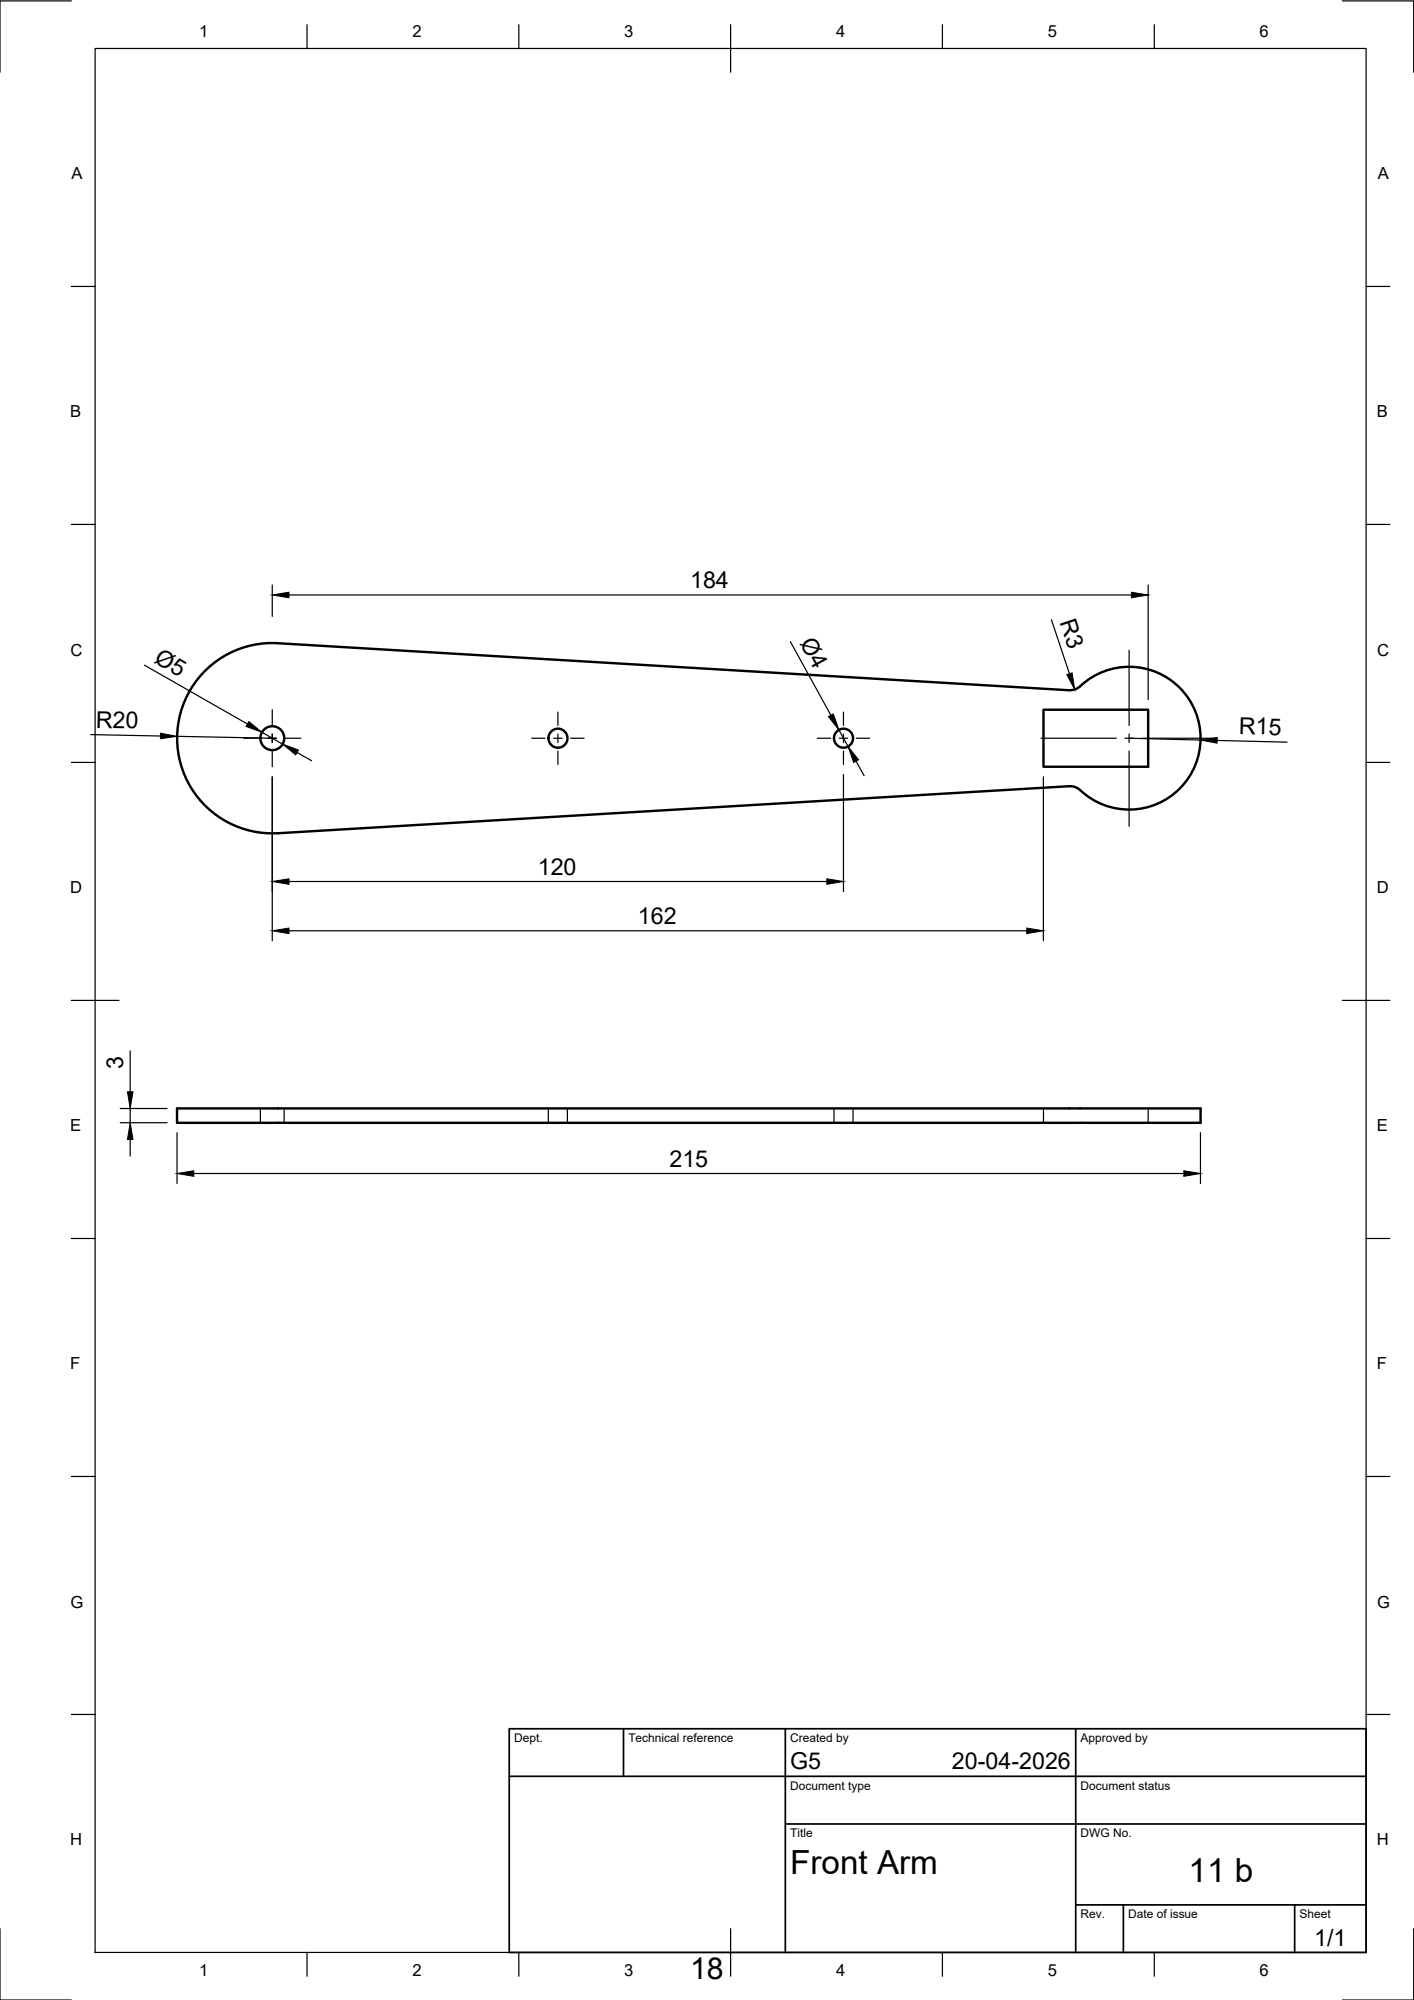
[picture p15: page 19]
Dept.; Technical reference; Created by; Approved by; Document type; Document status; Front Arm

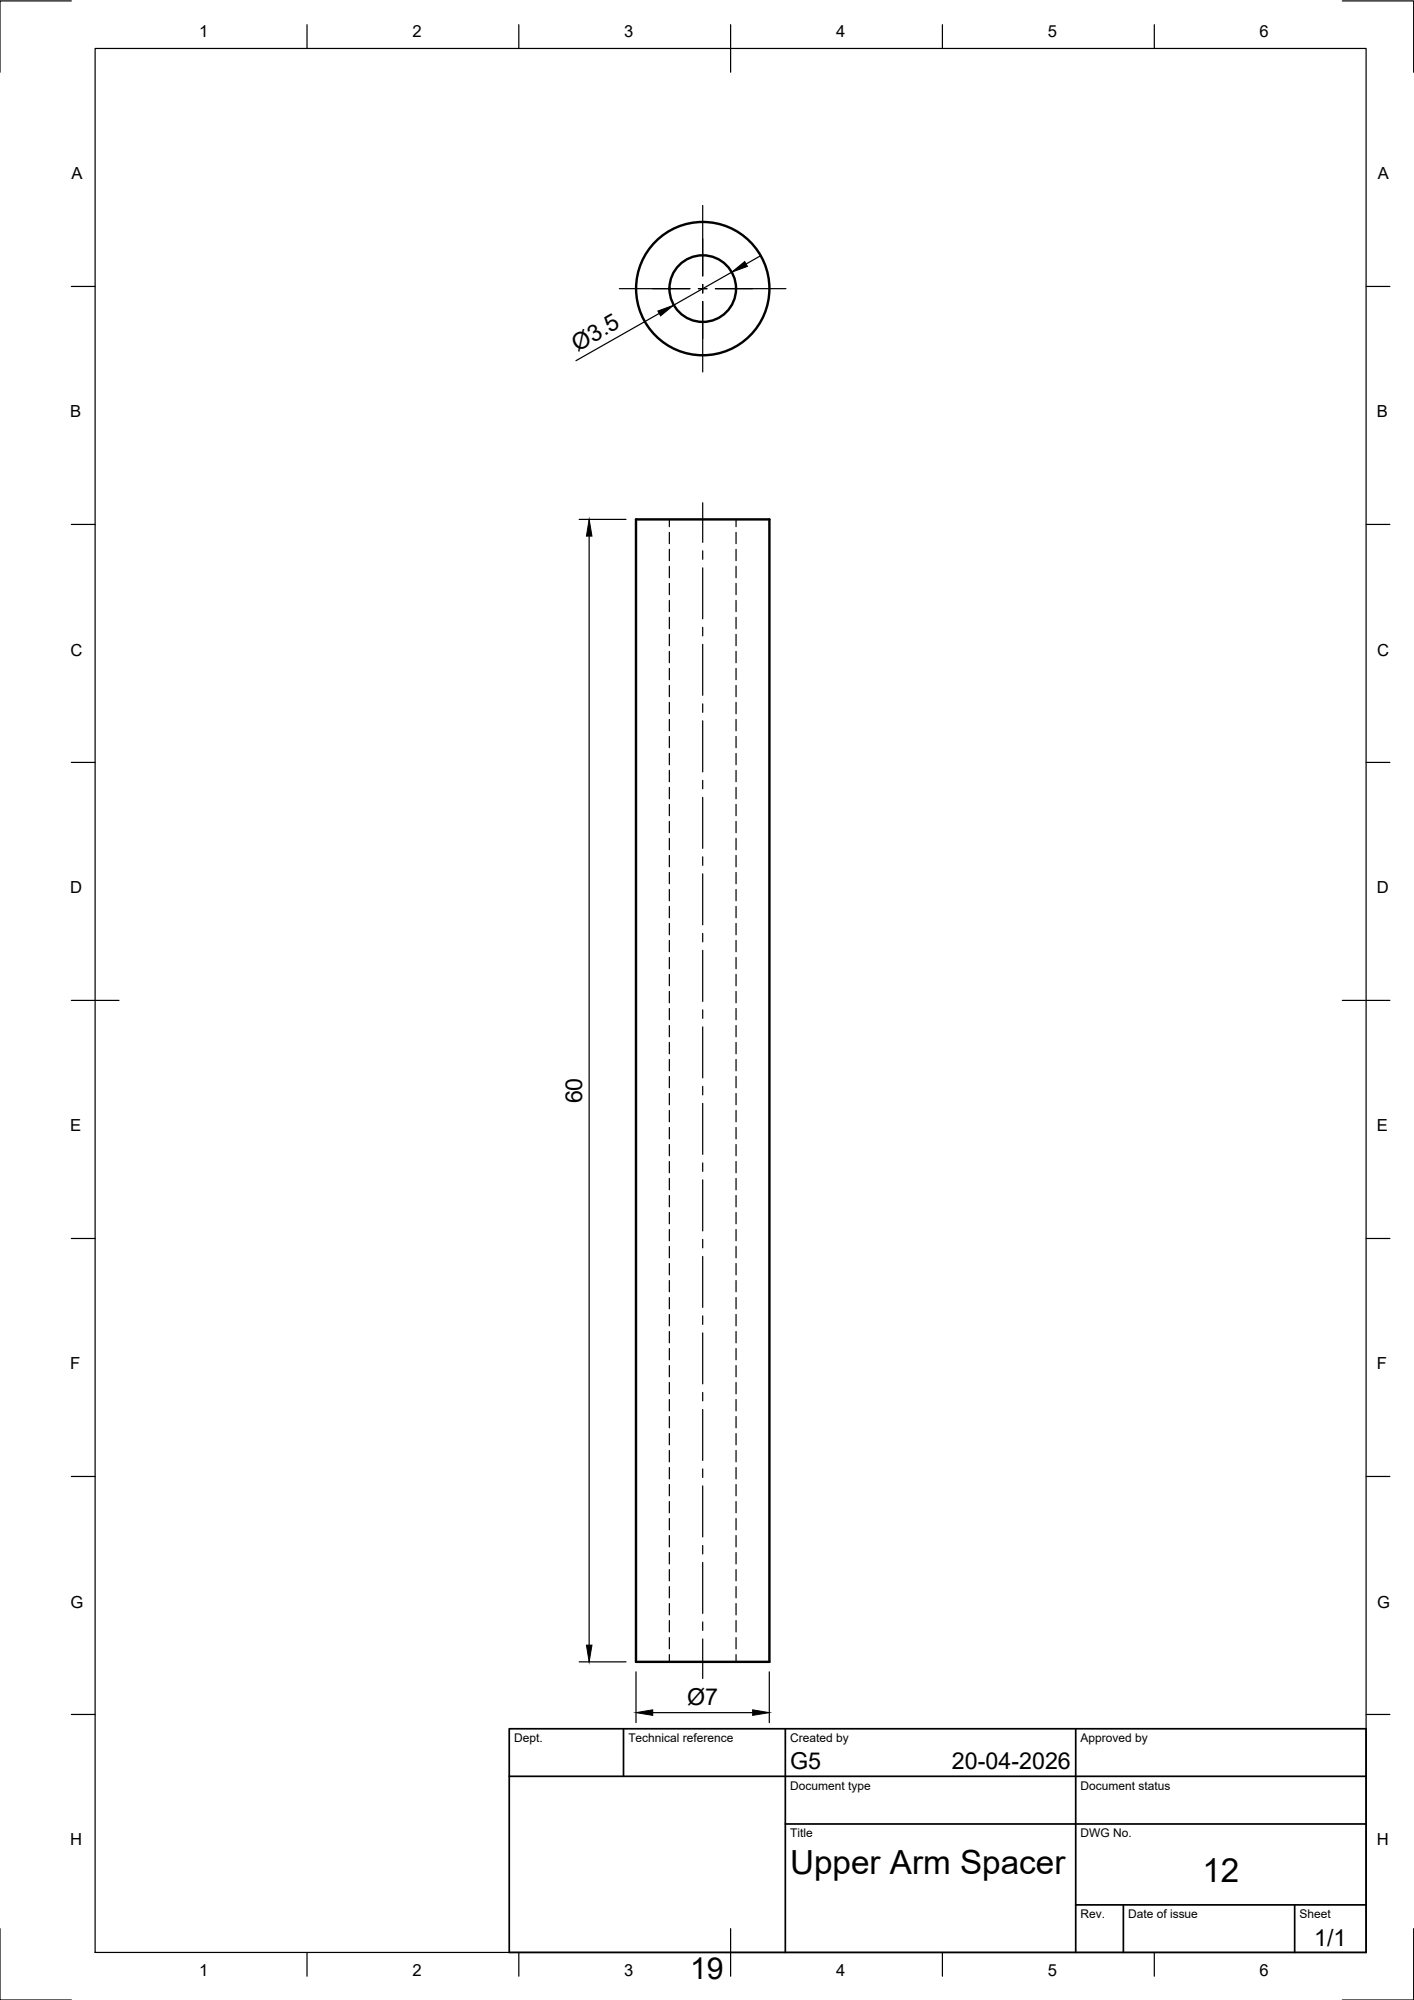
[picture p16: page 20]
Dept.; Technical reference; Created by; Approved by; Document type; Document status; Upper Arm Spacer

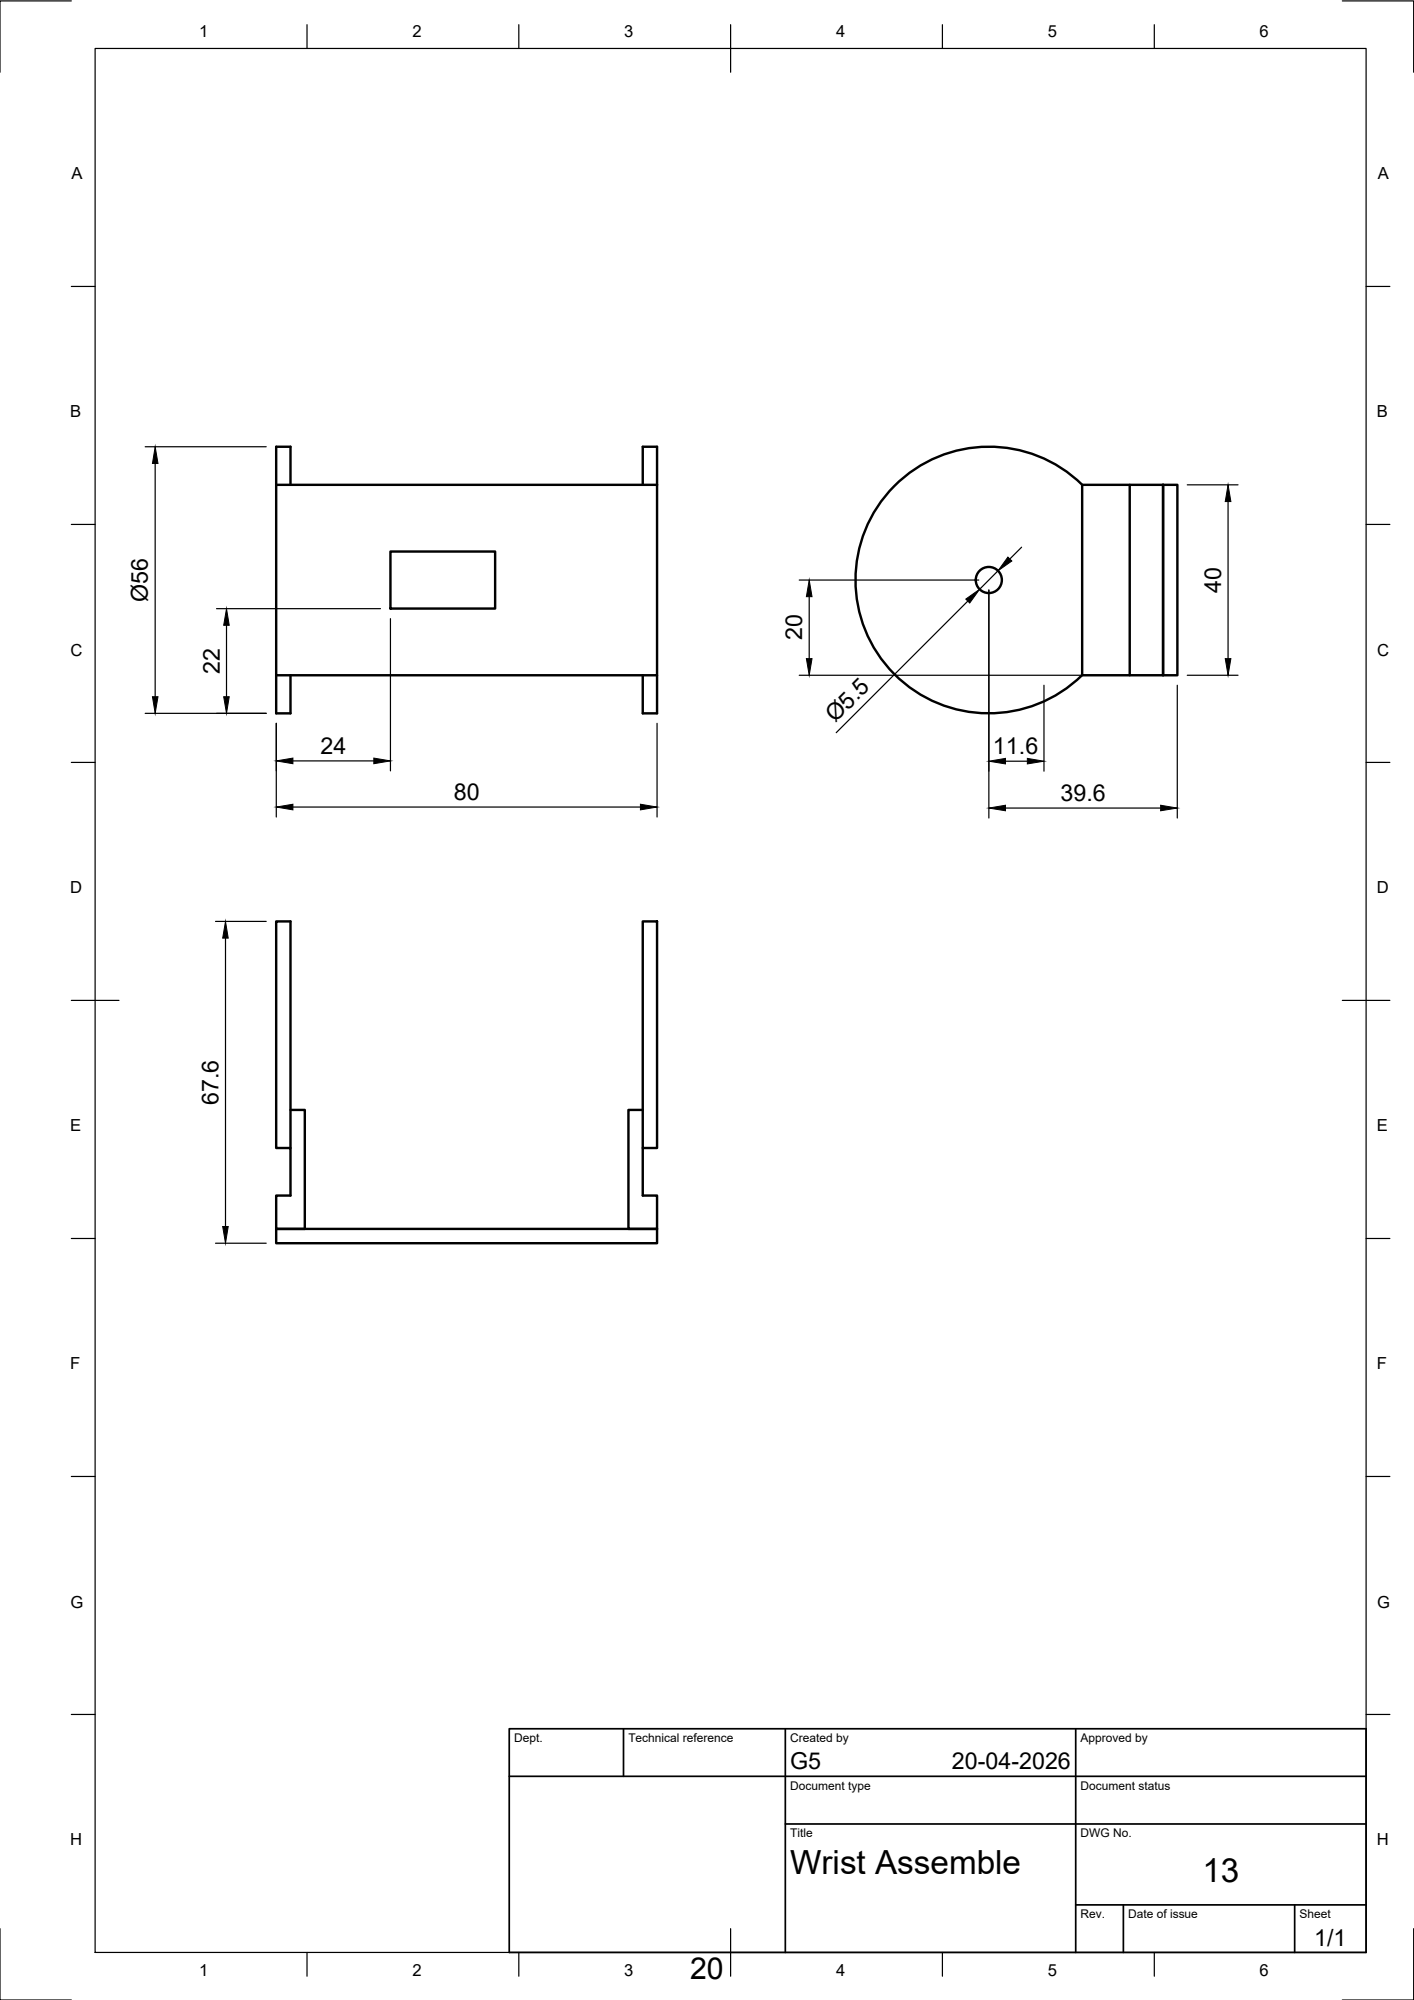
[picture p17: page 21]
Dept.; Technical reference; Created by; Approved by; Document type; Document status; Wrist Assemble; 80 Ø⁵⁶

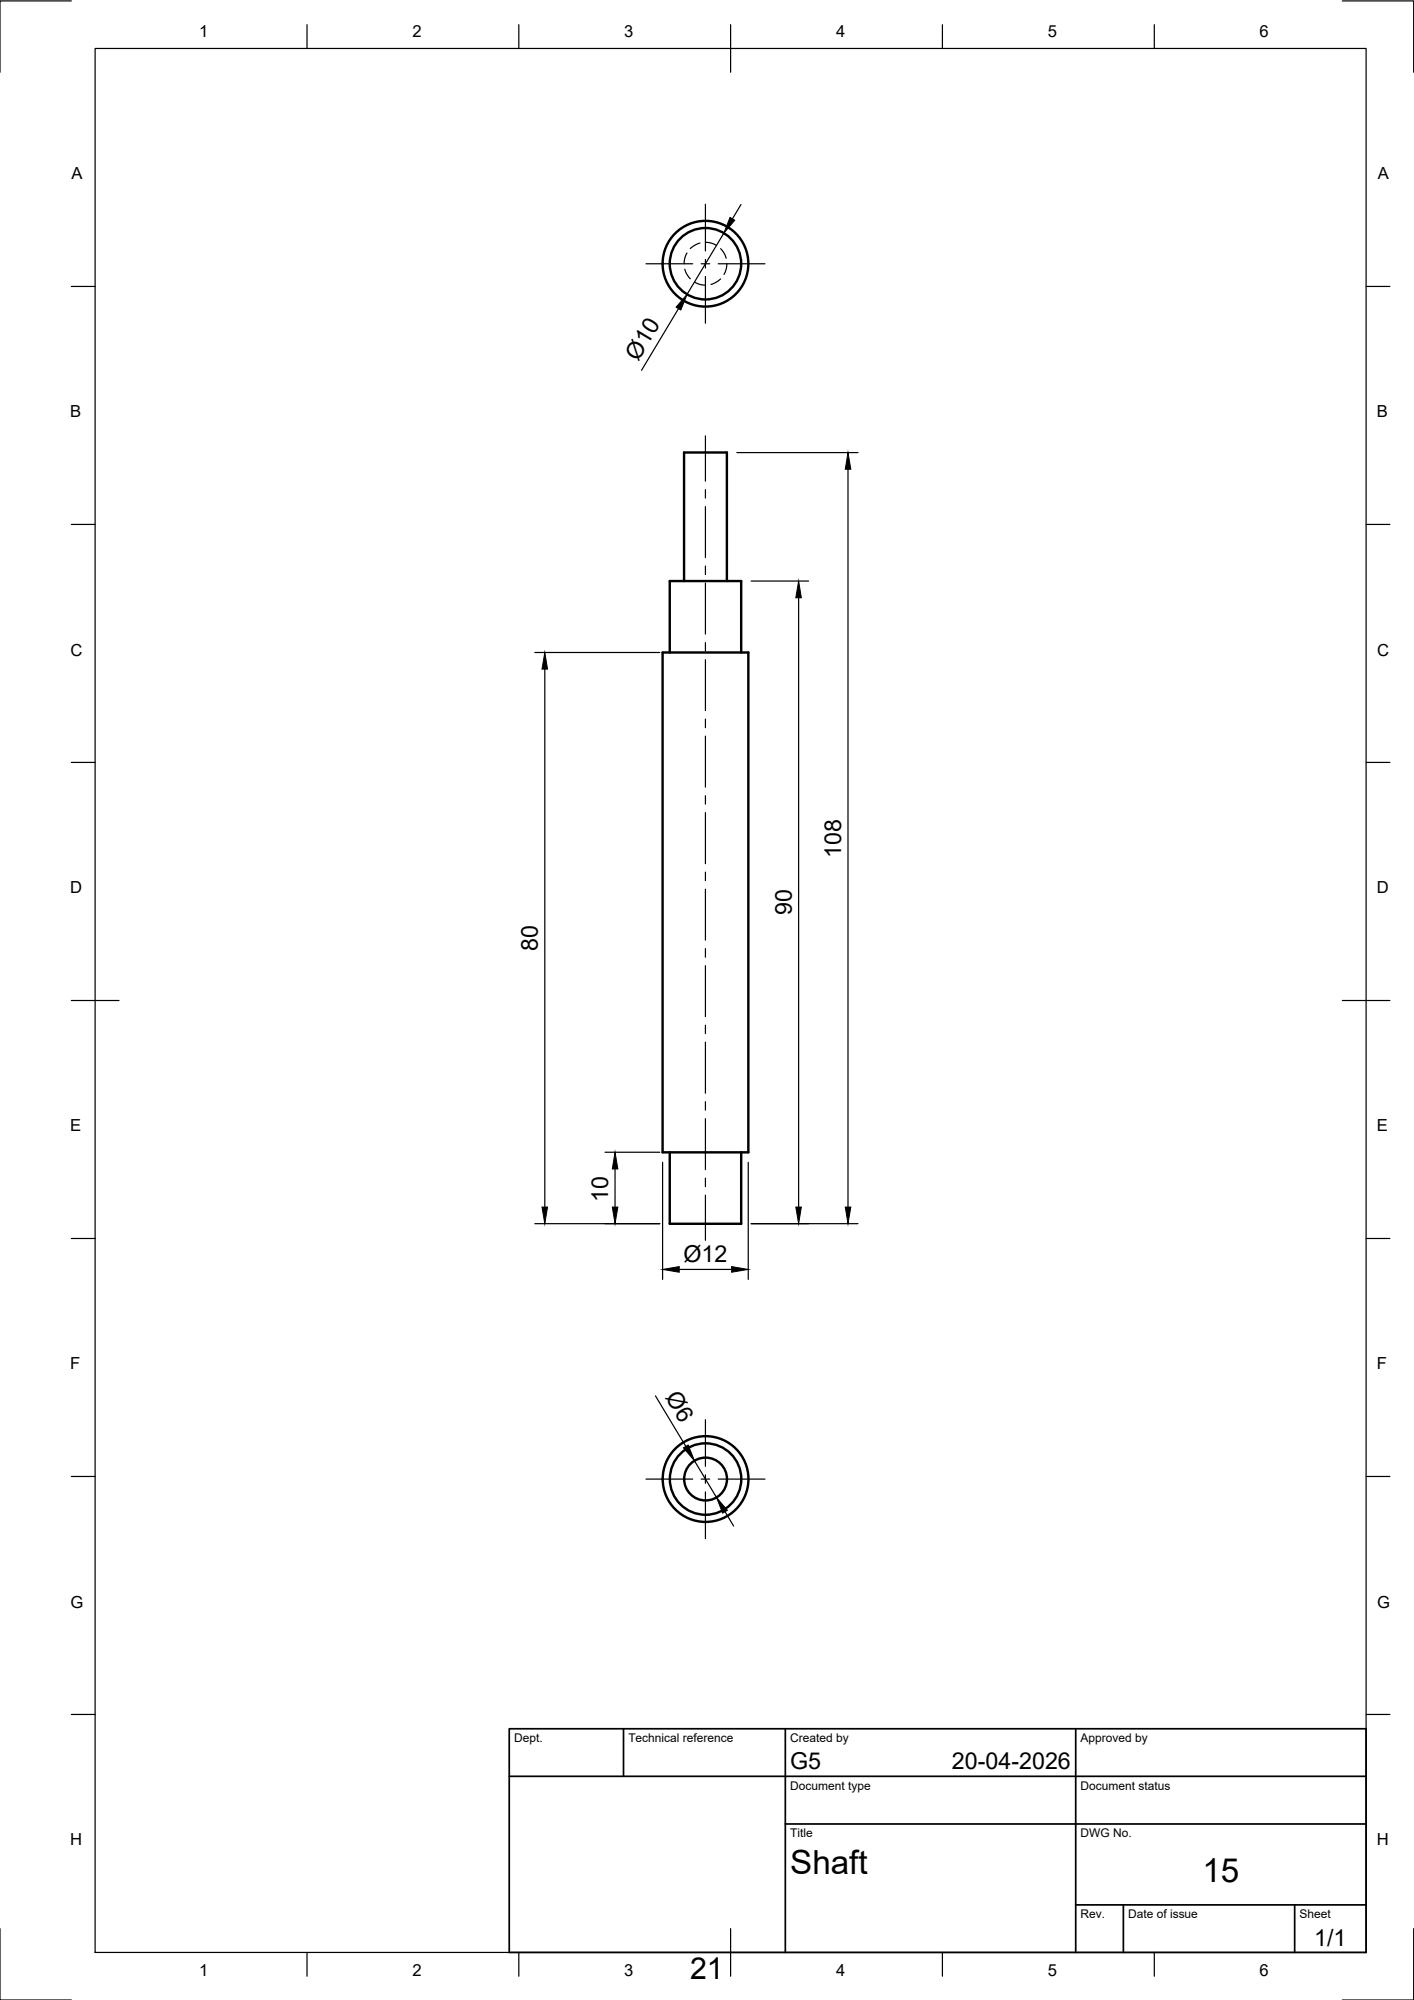
[picture p18: page 22]
Dept.; Technical reference; Created by; Approved by; Document type; Document status; Shaft

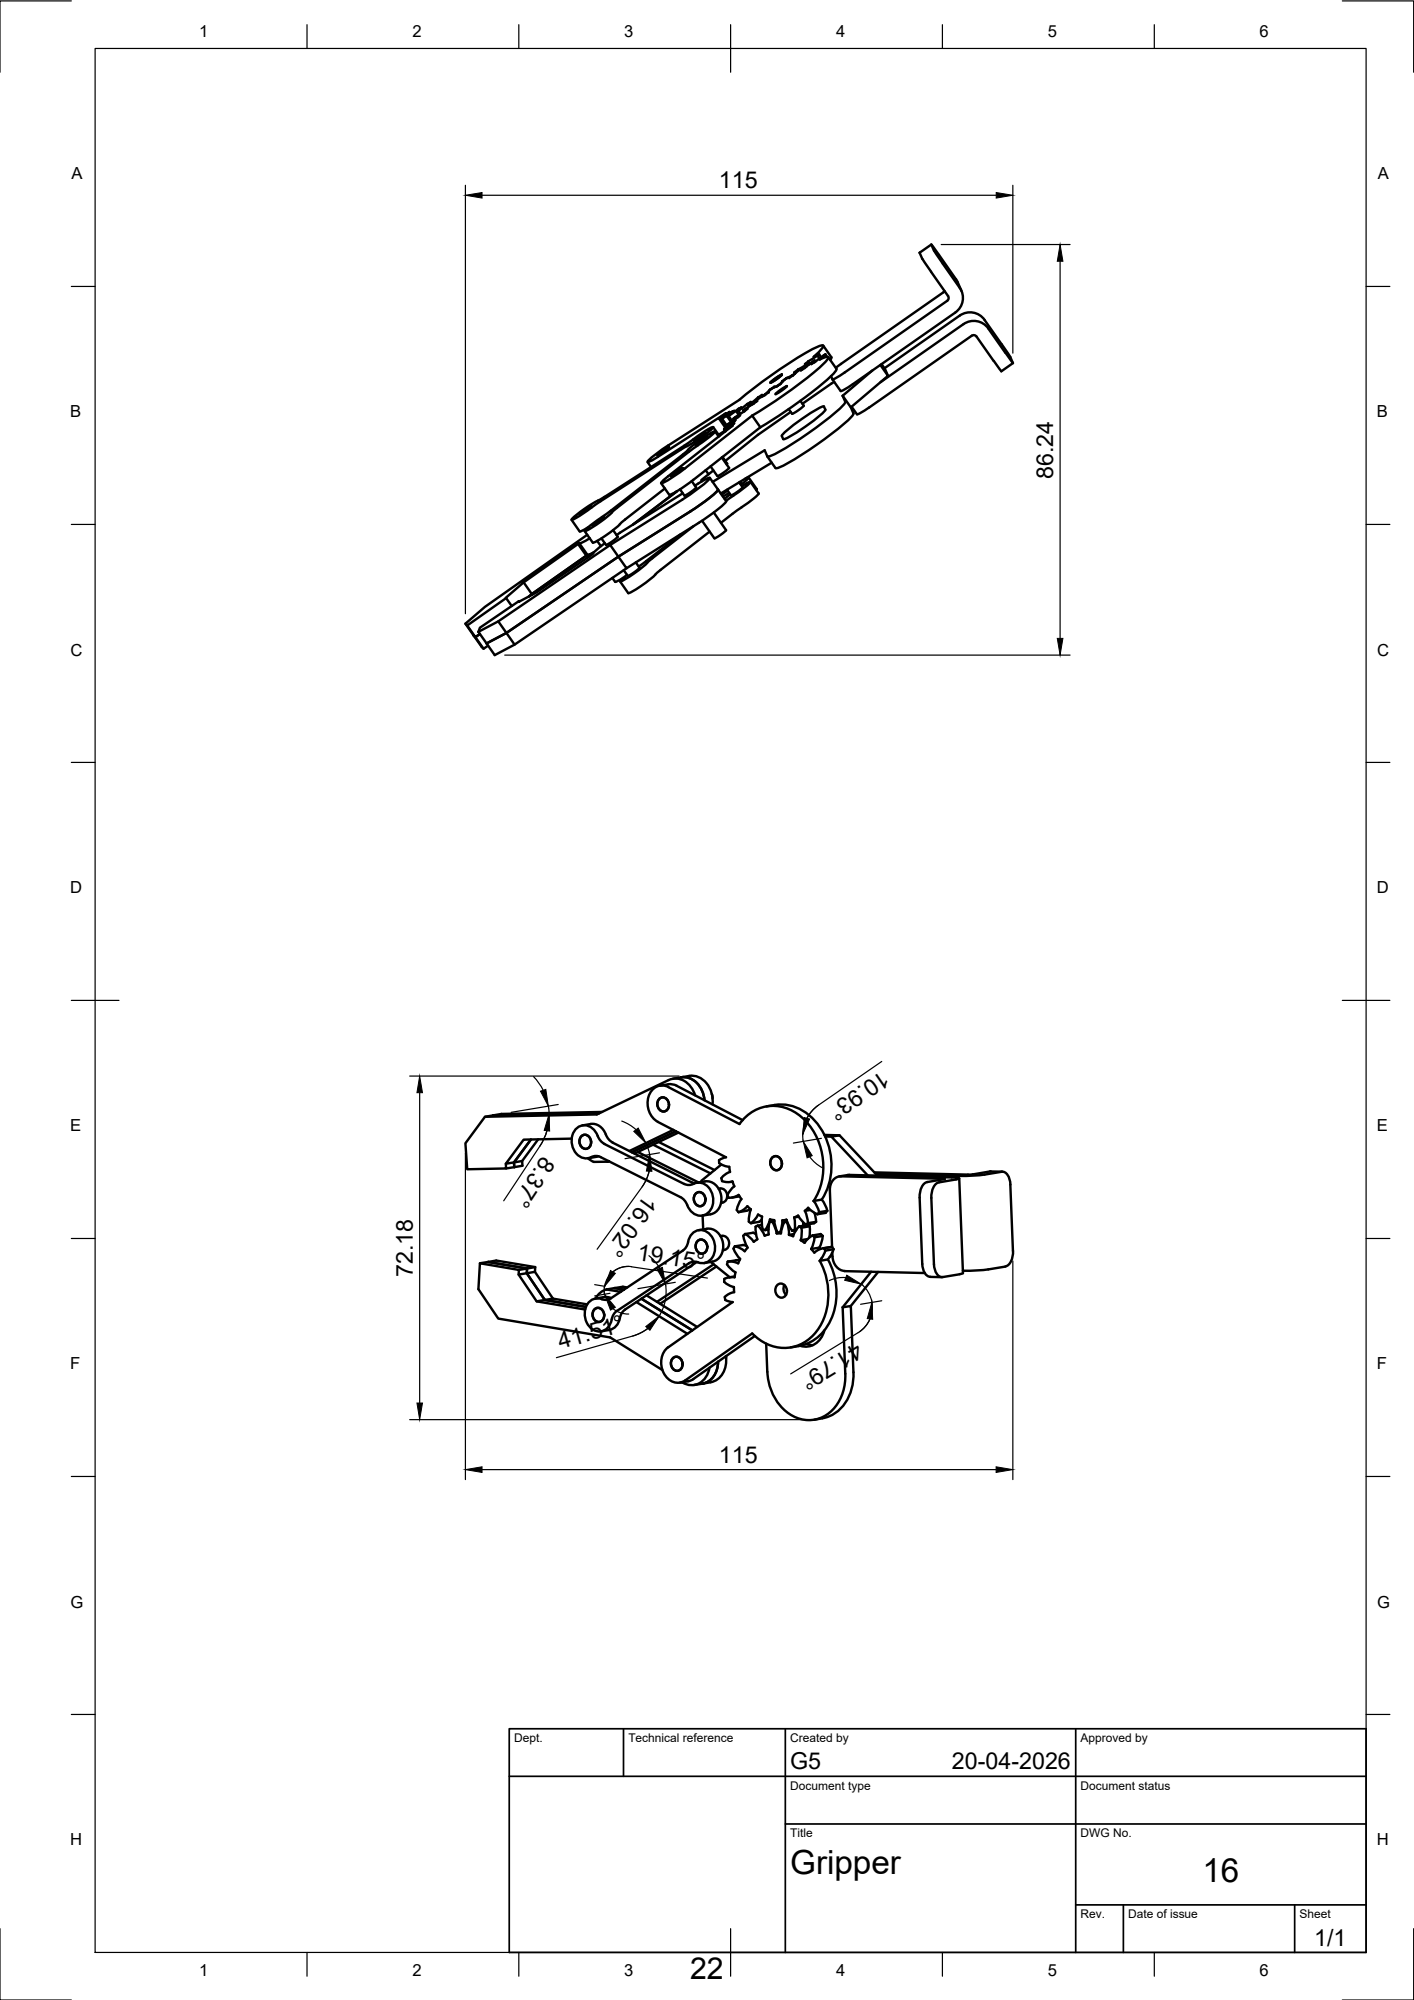
[picture p19: page 23]
Dept.; Technical reference; Created by; Approved by; Document type; Document status; Gripper

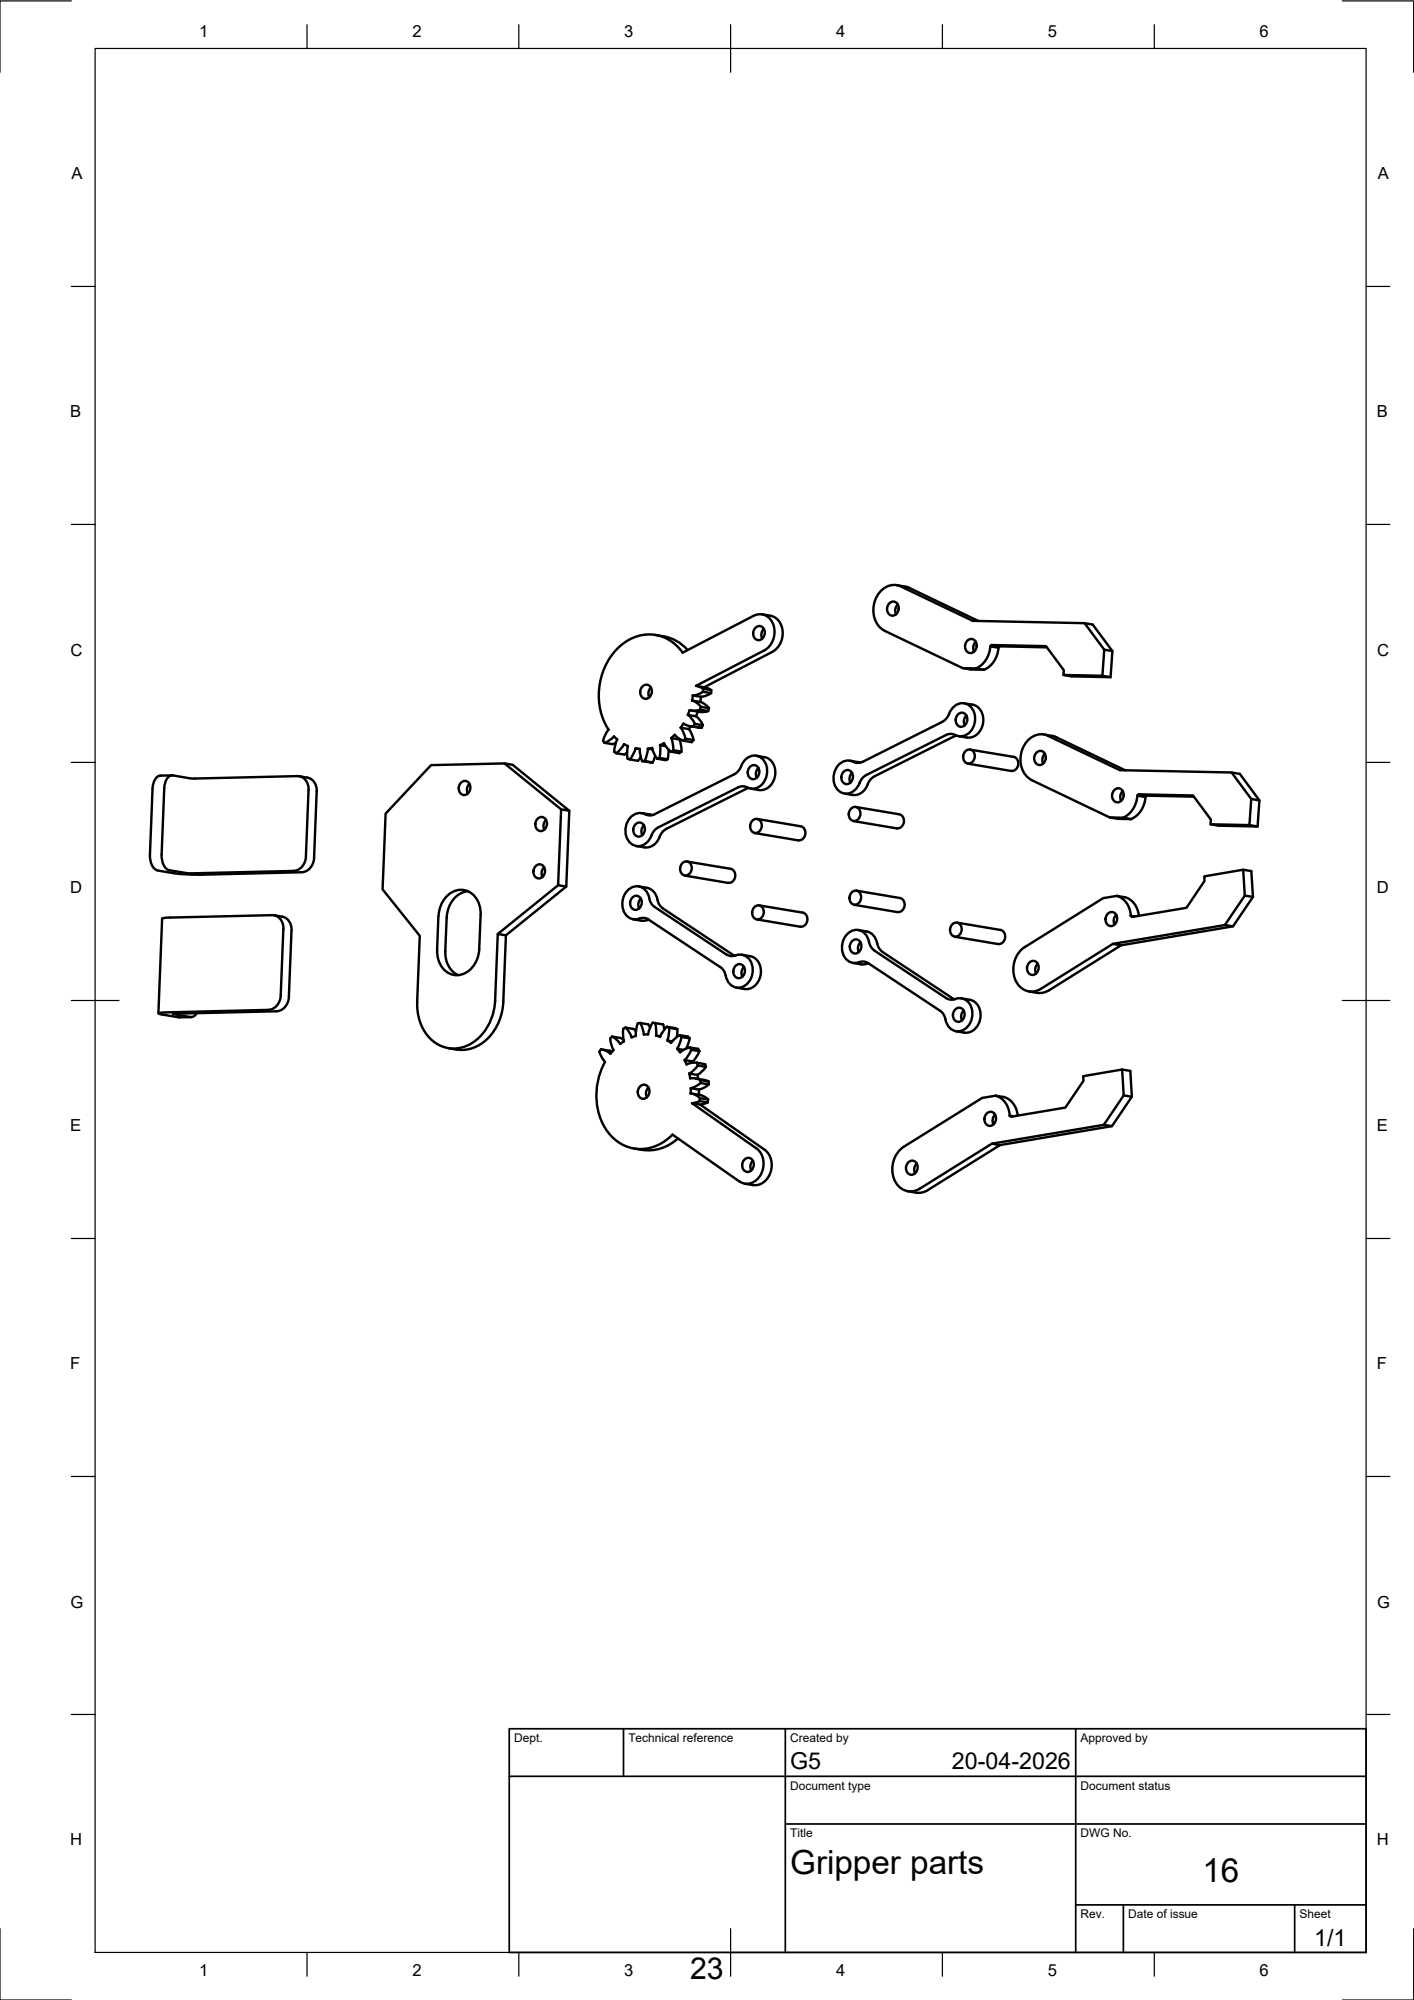
[picture p20: page 24]
Dept.; Technical reference; Created by; Approved by; Document type; Document status; Gripper parts

### Circuit Diagram

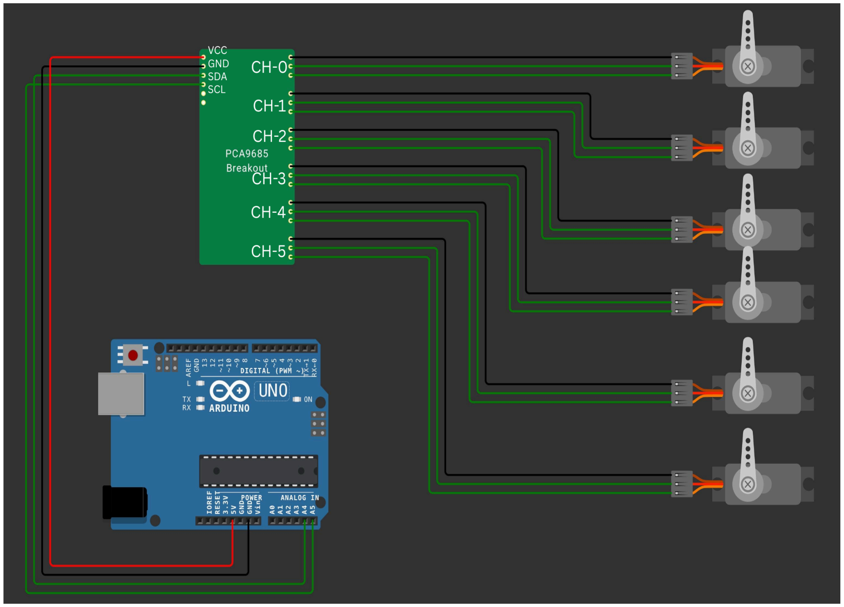
[picture p21: figure]

Servo Motor Driver (PCA9685) to Arduino Uno Connections: VCC → 5V
GND → GND
SDA → A4
SCL → A5

Servo Motor Driver (PCA9685) to Servo Motor Connections: | CH0 → Base
| CH1 → Shoulder
| CH2 → Elbow
| CH3 → Wrist Pitch
| CH4 → Wrist Roll
| CH5 → Claw

### INTRODUCTION-

This project controls a 6-DOF robotic arm using hand gestures captured through a webcam. The system has two main parts:

Python Code (CV)– Detects hand gestures and calculates servo angles.

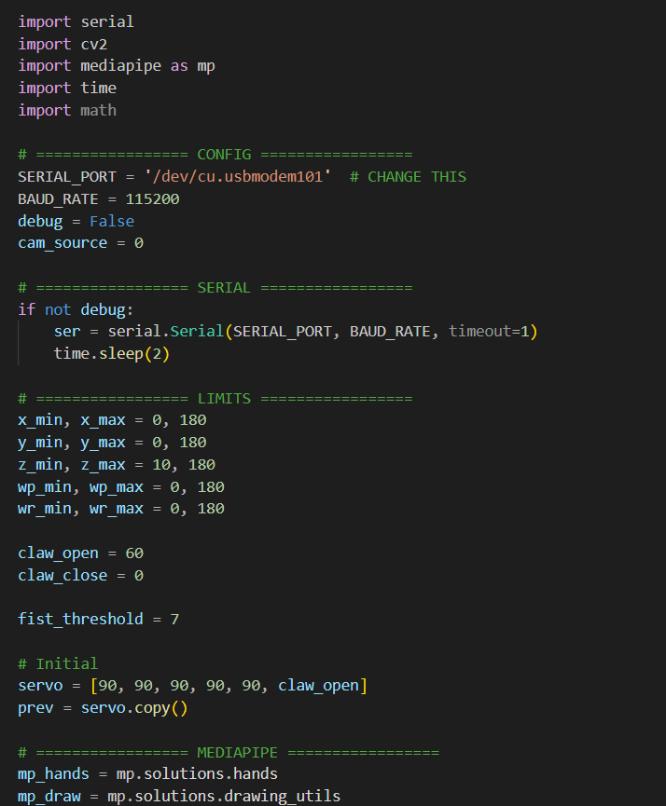
[picture p22: figure]

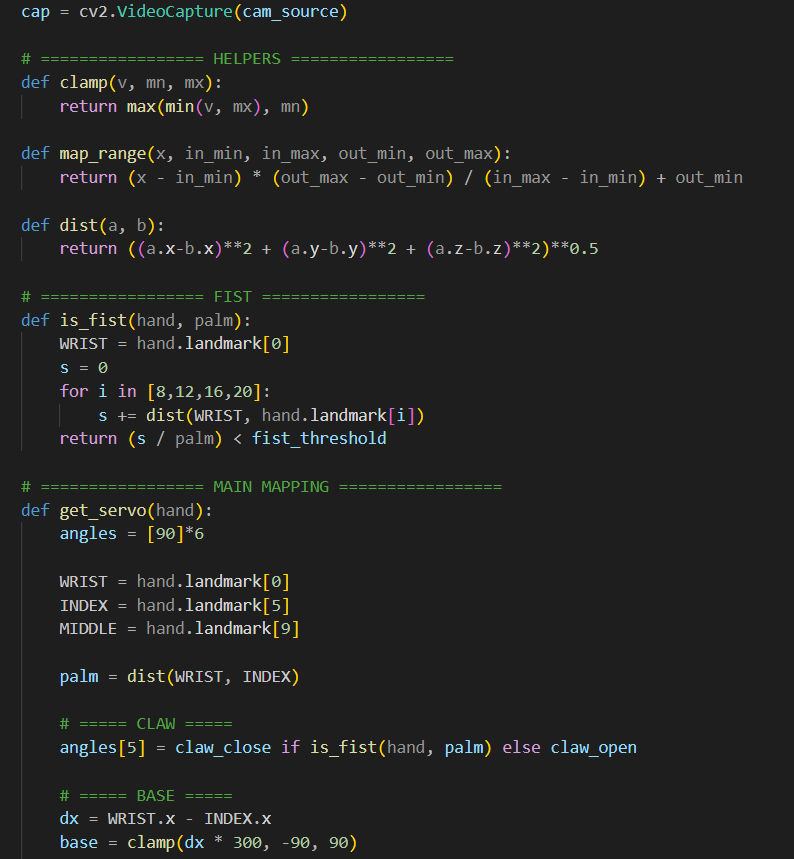
[picture p23: figure]

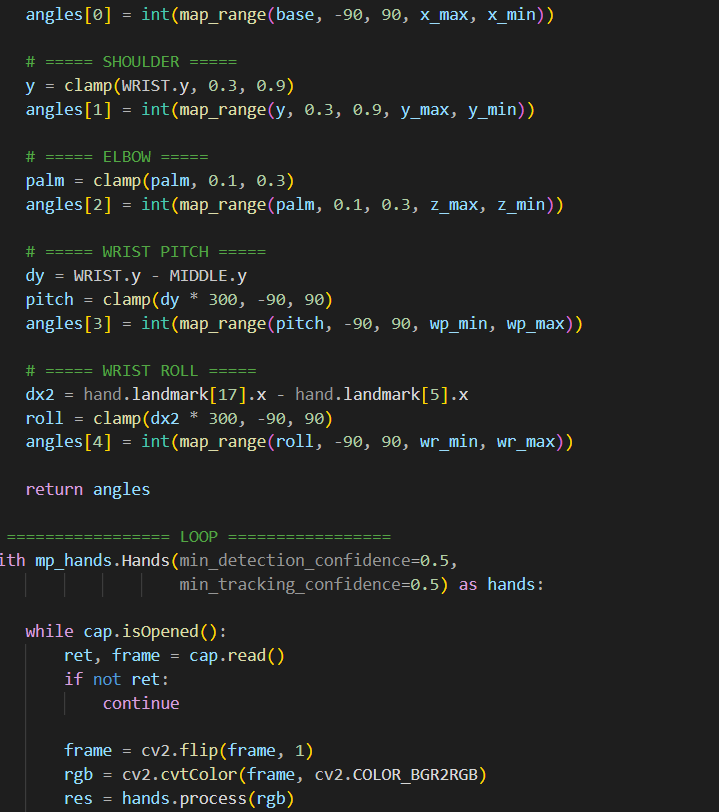
[picture p24: figure]

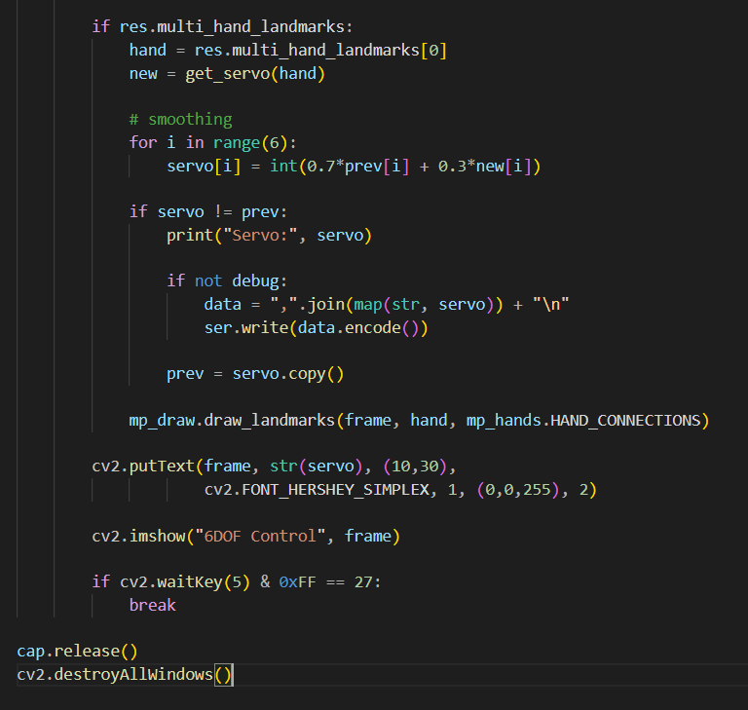
[picture p25: figure]

Arduino Code – Receives the servo angles and controls the servo motors using a PCA9685 driver.

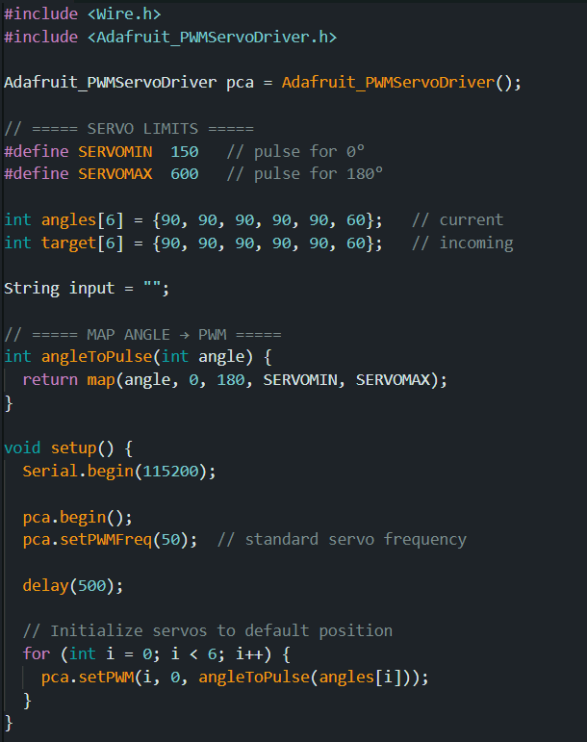
[picture p26: figure]

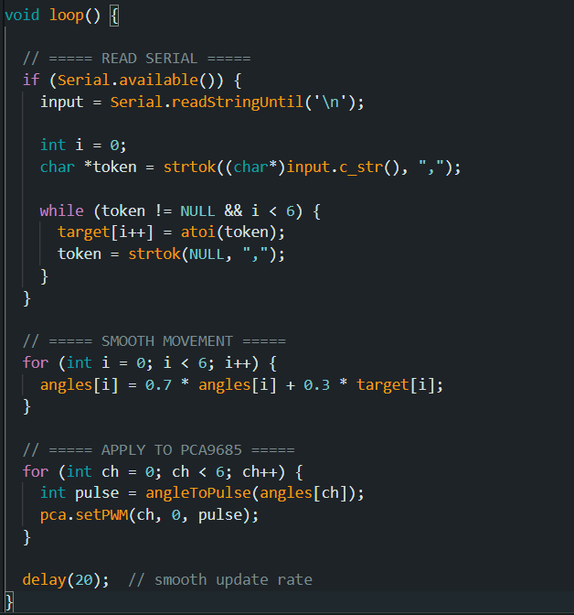
[picture p27: figure]

The webcam tracks the hand in real time. Python processes the hand movement and sends corresponding servo angles to the Arduino. The Arduino then moves the robotic arm accordingly.

### Python Code Explanation

### 1. Importing Libraries

The Python code uses the following libraries:

- OpenCV (cv2) – For capturing webcam video and displaying it.
- MediaPipe – For detecting 21 hand landmarks.
- Serial – For sending data to Arduino through USB.
- Time and Math – For delay and calculations.

### 2. Configuration Section

In the beginning, some configuration values are defined:

- Serial port and baud rate (115200).
- Debug mode (to enable or disable serial communication).
- Camera source.

This section sets up how the program connects to the Arduino and which camera it uses.

### 3. Serial Communication Setup

If debug mode is set to False, the program opens the serial port:

The serial connection allows Python to send servo angles to the Arduino continuously.

### 4. Servo Limits and Initial Position

Servo limits are defined between 0 and 180 degrees to prevent damage.

Initial servo positions are set as:

- Base: 90°
- Shoulder: 90°
- Elbow: 90°
- Wrist Pitch: 90°
- Wrist Roll: 90°
- Claw: 60° (open)

This ensures the robotic arm starts from a safe neutral position.

### 5. Helper Functions

There are three important helper functions:

- Clamp function:
This ensures values stay within a safe range.
- Map function:
This converts one range of values into another range. For example, it converts hand movement values into servo angle values.
- Distance function:
This calculates the 3D distance between two hand landmarks.

### 6. Fist Detection

The function checks whether the hand is closed.

It calculates the distance between the wrist and fingertips (index, middle, ring, and pinky).

If the fingers are close to the wrist, the program detects a fist and closes the claw servo.
If the hand is open, the claw remains open.

### 7. Mapping Hand Movements to Servo Angles

The function get_servo() converts hand landmark positions into six servo angles.

Each servo is controlled as follows:

- Servo 0 – Base
Controlled by left and right movement of the hand.
- Servo 1 – Shoulder

Controlled by up and down movement of the wrist.

- Servo 2 – Elbow
Controlled by palm size (distance between wrist and index finger). If the hand moves closer to the camera, the elbow angle changes.
- Servo 3 – Wrist Pitch
Controlled by bending the hand up or down.
- Servo 4 – Wrist Roll
Controlled by rotating the hand.
- Servo 5 – Claw
Controlled by fist detection (open or close).

### 8. Smoothing the Movement

To avoid jerky movement, smoothing is applied:

New Angle = 0.7 × Previous Angle + 0.3 × Current Angle

This makes the robotic arm move smoothly instead of suddenly jumping to new positions.

### 9. Sending Data to Arduino

The servo angles are converted into a comma-separated string like:

90,120,45,80,90,60

This string is sent to the Arduino using serial communication at 115200 baud rate.

### Arduino Code Explanation

### 1. PCA9685 Servo Driver

The Arduino uses a PCA9685 PWM driver to control 6 servo motors. The PWM frequency is set to 50 Hz, which is standard for servo motors.

### 2. Reading Serial Data

Arduino continuously checks if data is available on the serial port.

When data is received, it reads one full line and separates the six angle values using commas. These values are stored as target angles.

### 3. Smooth Servo Movement

Arduino again applies smoothing:

Angle = 0.7 × Current Angle + 0.3 × Target Angle

This ensures smooth and stable movement of the robotic arm.

### 4. Converting Angle to PWM

Servo motors do not directly understand angles.
So, angles (0–180 degrees) are converted into PWM pulse values:

150 corresponds to 0 degrees
600 corresponds to 180 degrees

These pulse values are sent to the PCA9685 driver to move the servos.

### 5. Continuous Loop

The Arduino loop runs continuously with a small delay (20 milliseconds). This keeps updating servo positions in real time according to hand movement.

### Overall Working:

1. Webcam captures the hand.
2. MediaPipe detects 21 landmarks.
3. Python calculates servo angles based on hand position.
4. Angles are smoothed.
5. Angles are sent to Arduino via serial communication.
6. Arduino reads the angles.
7. PCA9685 drives the servo motors.
8. The robotic arm moves according to the hand gesture.

Bill Of Materials and Cost Analysis

Cost of Electrical Components purchased = 1950+300 = 2250
Actual total cost of Electrical Components = 3430
S. No. | Part No. | Part Name | Quantity | Process\ Material Used | Time Taken (Hrs) | Cost
1 | 1 | Mounting 1 | 1 | 3D Printing (PLA) | 1.5 | 100*1.5=150
2 | 3 | Base Support | 3 | 3D Printing (PLA) | 1.5 | 100*1.5=150
3 | 4 | Gear (a,b) | 2 | 3D Printing (PLA) | 1 | 100*1=100
4 | 5 | Base Plate A | 1 | Turning (ACP) | 2 | 150*2=200
5 | 6 | Spacer Plate | 3 | 3D Printing (PLA) | 2 | 100*2=200
6 | 7 | Base Plate B | 2 | 3D Printing (PLA) | 1.5 | 100*1.5=150
7 | 8 | Mounting 2 | 1 | 3D Printing (PLA) | 1.5 | 100*1.5=150
8 | 9 | Arm (a,b) | 2 | 3D Printing (PLA) | 2.5 | 100*2.5=250
9 | 11 | Front Arm (a,b) | 2 | 3D Printing (PLA) | 2 | 100*2=200
10 | 12 | Upper Arm Spacer | 2 | 3D Printing (PLA) | 1.25 | 100*1.25=125
11 | 15 | Shaft | 1 | Turning (Metal) | 1.5 | 150*1.5=225
12 | 16 | Gripper | 1 | 3D Printing (PLA) | 3 | 100*3=300

Material cost (750g PLA +100g Metal +400g ACP)= 500*0.75+100*0.1+350*0.4=525 Total cost of Machining = 2200
Total Cost of Manufactured Components (Material+Machining) = 2200+525 = 2725

Actual Value of the Project (Electrical + Mechanical) = 2725+3430 = Rs 6155

S. No. | Component | Quantity | Availability | Cost in Lab | Actual Cost
1 | Servo Motor (SG90) | 3 | Available | 0 | 150*3=450
2 | Servo Motor (MG996R) | 3 | Purchased | 650*3=1950 | 650*3=1950
3 | Servo Motor Driver (PCA9685) | 1 | Purchased | 300*1=300 | 300*1=300
4 | Arduino Uno | 1 | Available | 0 | 500*1=500
5 | Battery Holder | 1 | Available | 0 | 30*1=30
6 | Li-ion Batteries (3.7V) | 2 | Available | 0 | 50*2=100
7 | Jumper Wires | Multiple | Available | 0 | ~100
