harshwardhangiri/CV-Based-Robotic-Arm-TA212-/CAD/Final Render1.JPG

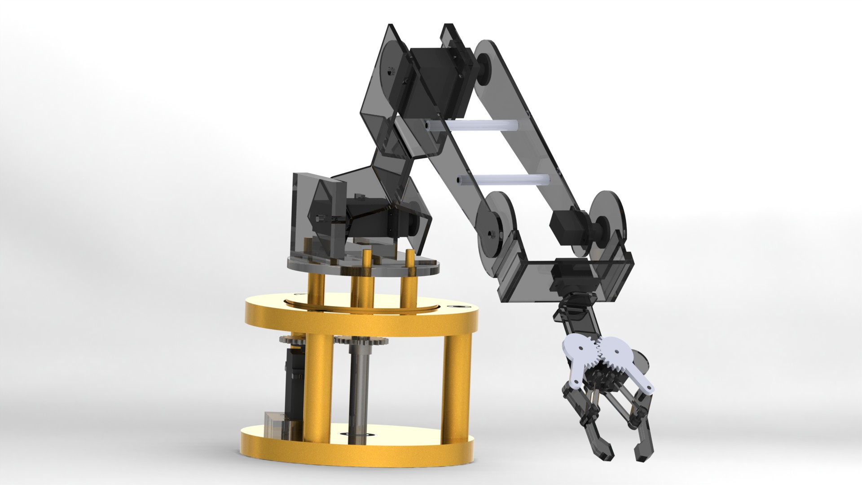
CAD/Final Render1.JPG
