harshwardhangiri/CV-Based-Robotic-Arm-TA212-/CAD/Final Render 2.JPG

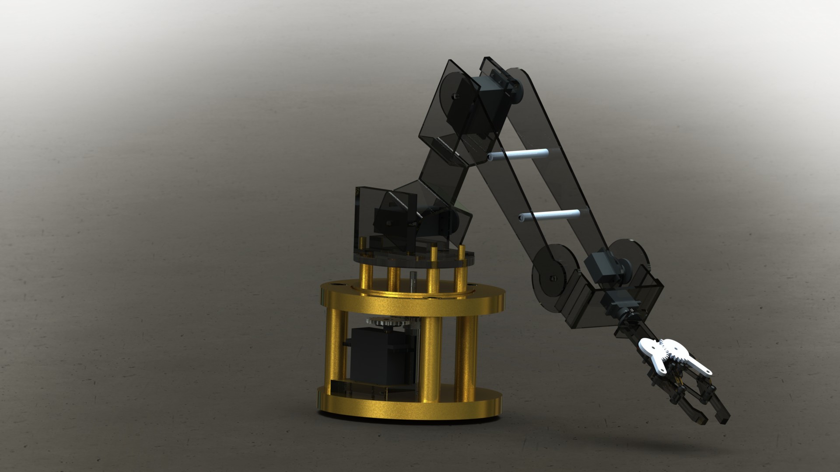
CAD/Final Render 2.JPG
