harshwardhangiri/CV-Based-Robotic-Arm-TA212-/CAD/Final Render 3.JPG

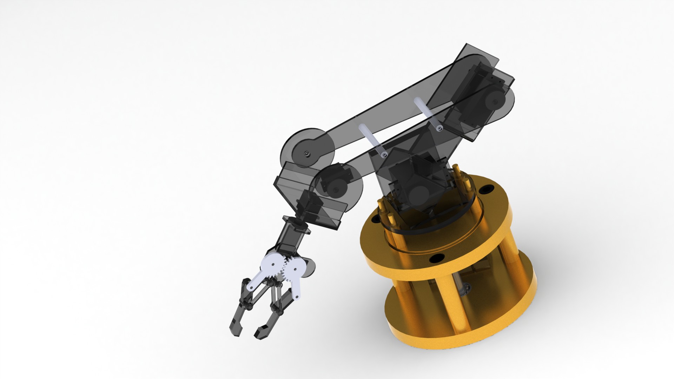
CAD/Final Render 3.JPG
