harshwardhangiri/CV-Based-Robotic-Arm-TA212-/CAD/Final Render 4.JPG

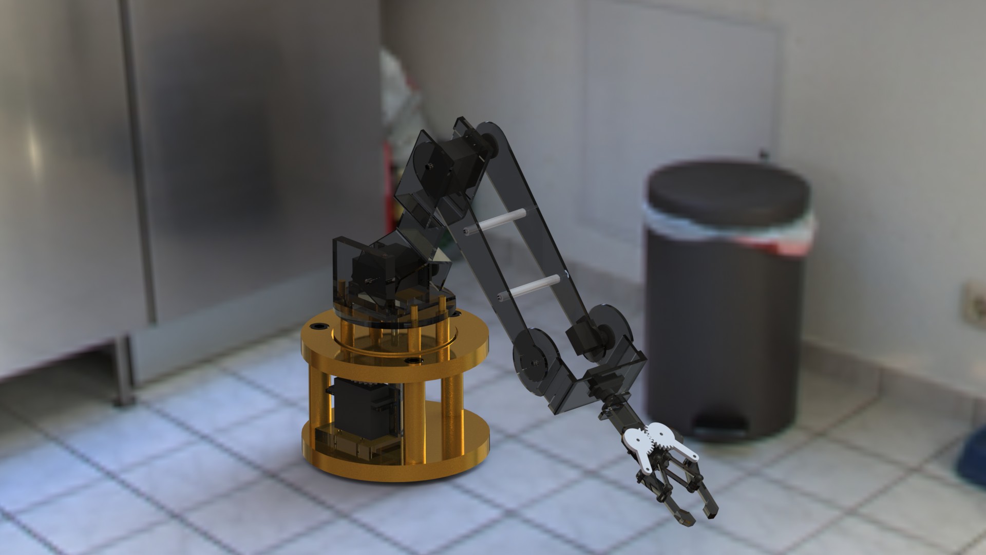
CAD/Final Render 4.JPG
