harshwardhangiri/CV-Based-Robotic-Arm-TA212-/CAD/Final Render.JPG

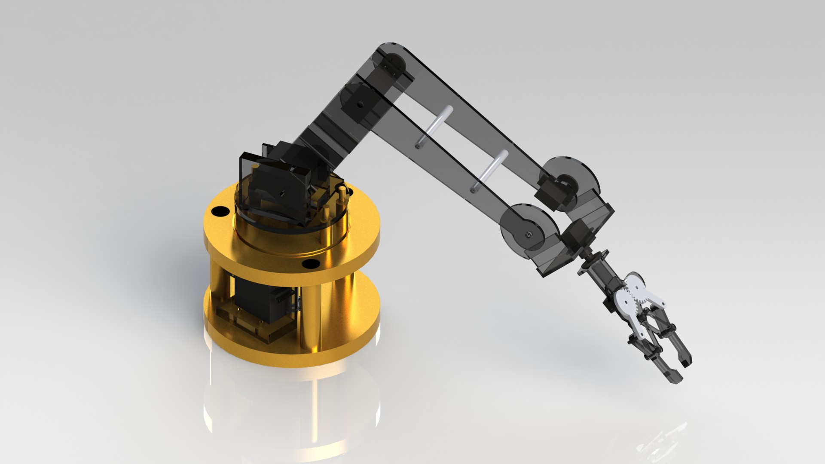
CAD/Final Render.JPG
