harshwardhangiri/CV-Based-Robotic-Arm-TA212-/CAD/Gripper Render1.JPG

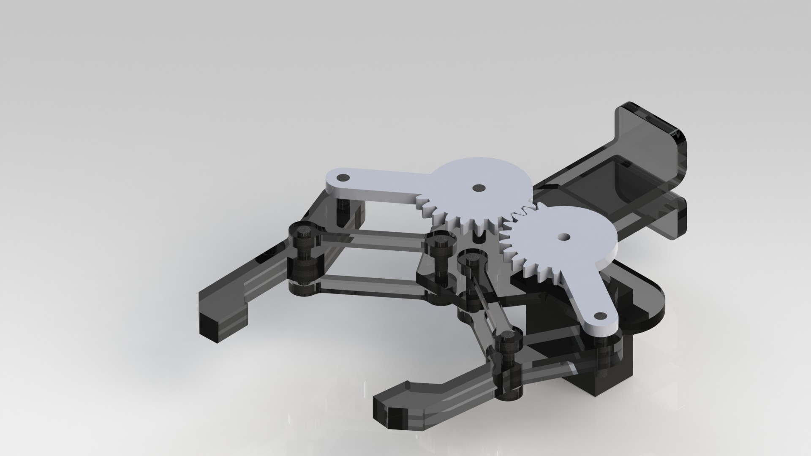
CAD/Gripper Render1.JPG
