harshwardhangiri/CV-Based-Robotic-Arm-TA212-/CAD/Gripper Render2.JPG

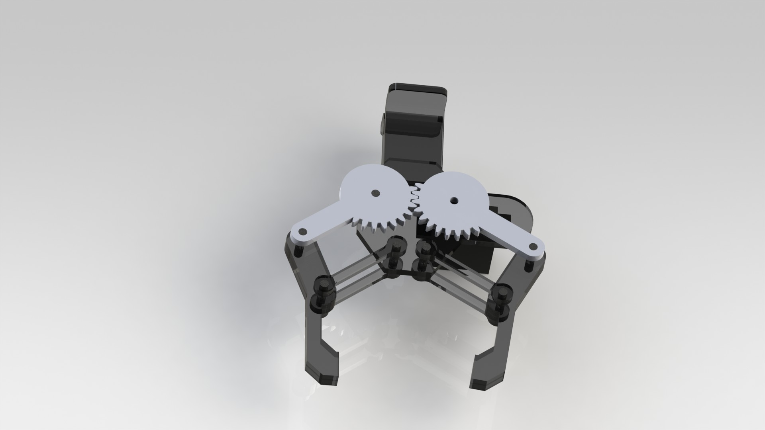
CAD/Gripper Render2.JPG
