harshwardhangiri/CV-Based-Robotic-Arm-TA212-/CAD/Gripper Render3.JPG

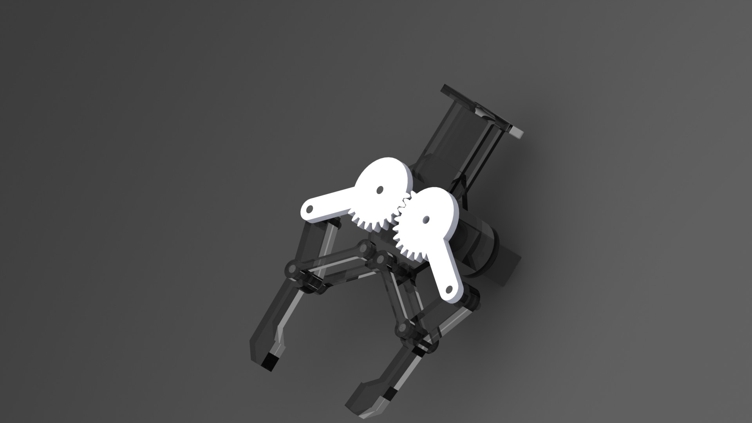
CAD/Gripper Render3.JPG
