harshwardhangiri/CV-Based-Robotic-Arm-TA212-/CAD/Gripper Render4.JPG

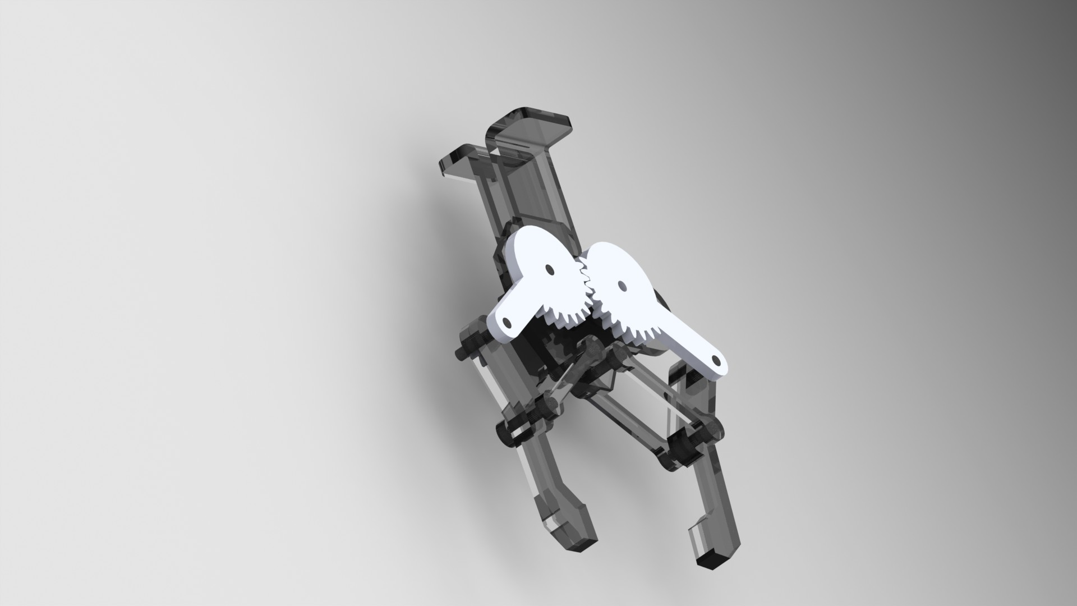
CAD/Gripper Render4.JPG
