harshwardhangiri/CV-Based-Robotic-Arm-TA212-/CAD/Gripper Render5.JPG

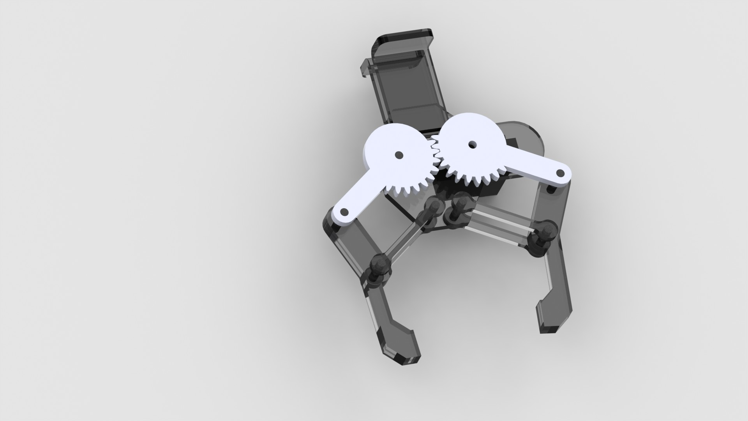
CAD/Gripper Render5.JPG
