harshwardhangiri/CV-Based-Robotic-Arm-TA212-/CAD/Gripper Render6.JPG

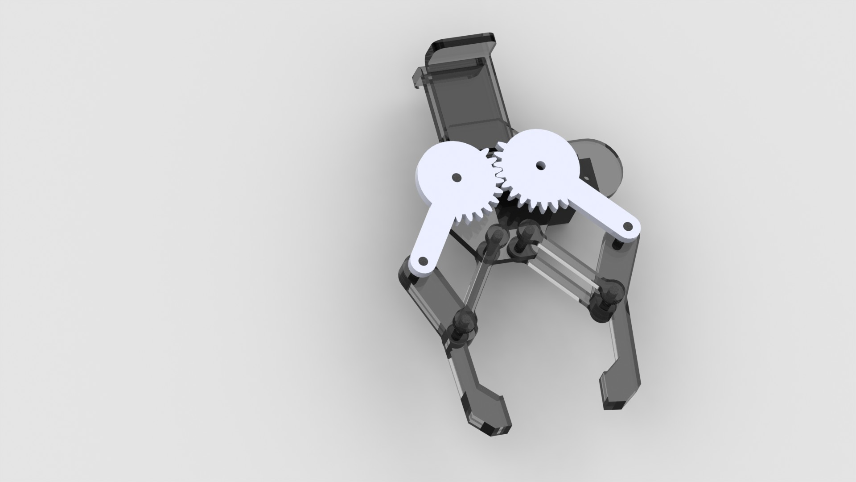
CAD/Gripper Render6.JPG
