harshwardhangiri/CV-Based-Robotic-Arm-TA212-/CAD/WRIST ASSEMBLE.SLDASM

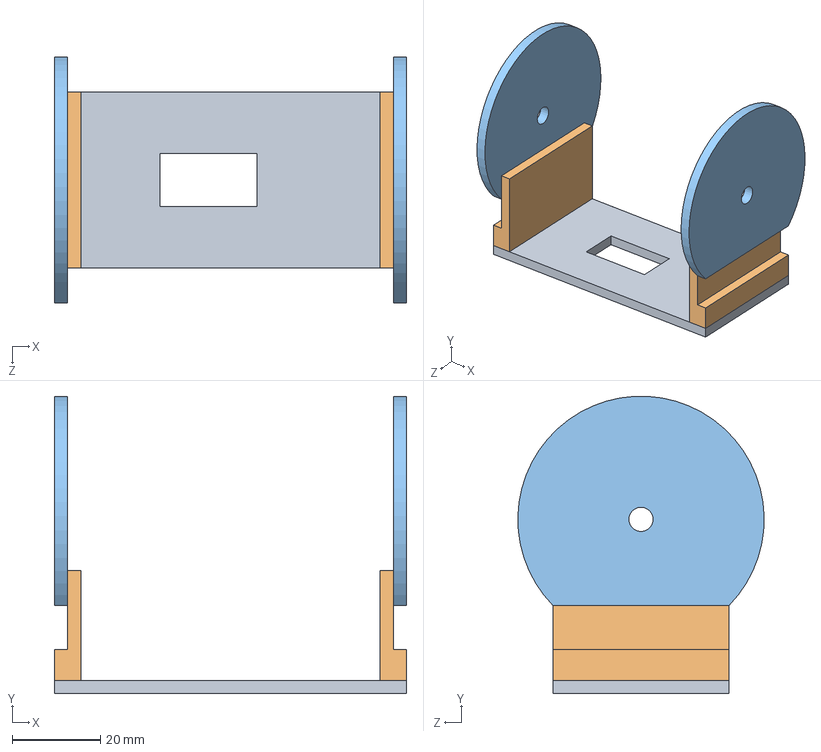
[picture p41: CAD file, 2026-05-25]
CAD/WRIST ASSEMBLE.SLDASM
80.0 x 67.6 x 56.0 mm
Wrist 2
Wrist Support x 2
Wrist 1 x 2
