harshwardhangiri/CV-Based-Robotic-Arm-TA212-/CAD/Assem1.SLDASM

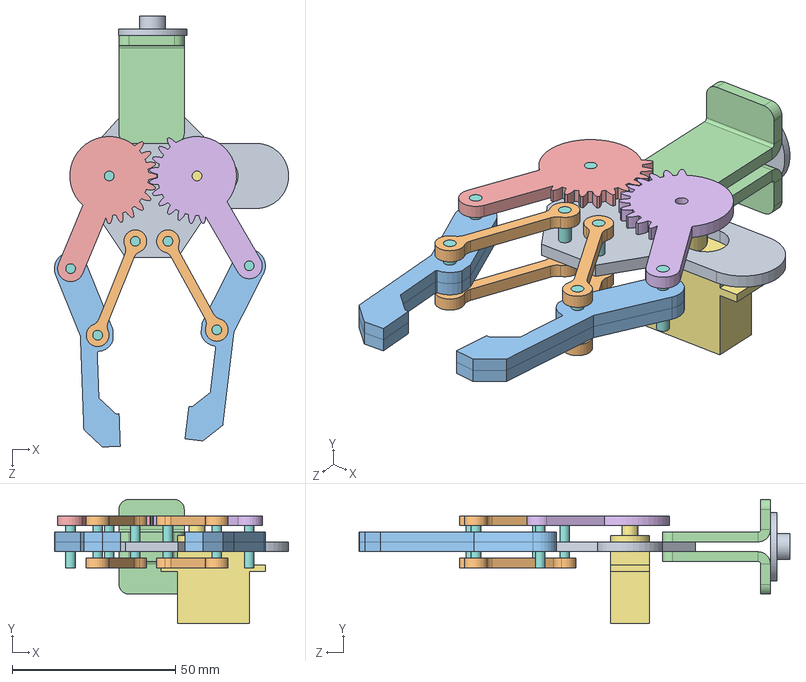
[picture p42: CAD file, 2026-05-25]
CAD/Assem1.SLDASM
71.8 x 38.0 x 132.0 mm
grip2
grip1 x 4
grip4 x 4
grip5 x 2
Gear 1
Gear 2
Servo Motor 6
pin x 7
Motor Head
