harshwardhangiri/CV-Based-Robotic-Arm-TA212-/CAD/BASE ASSEMBLE.SLDASM

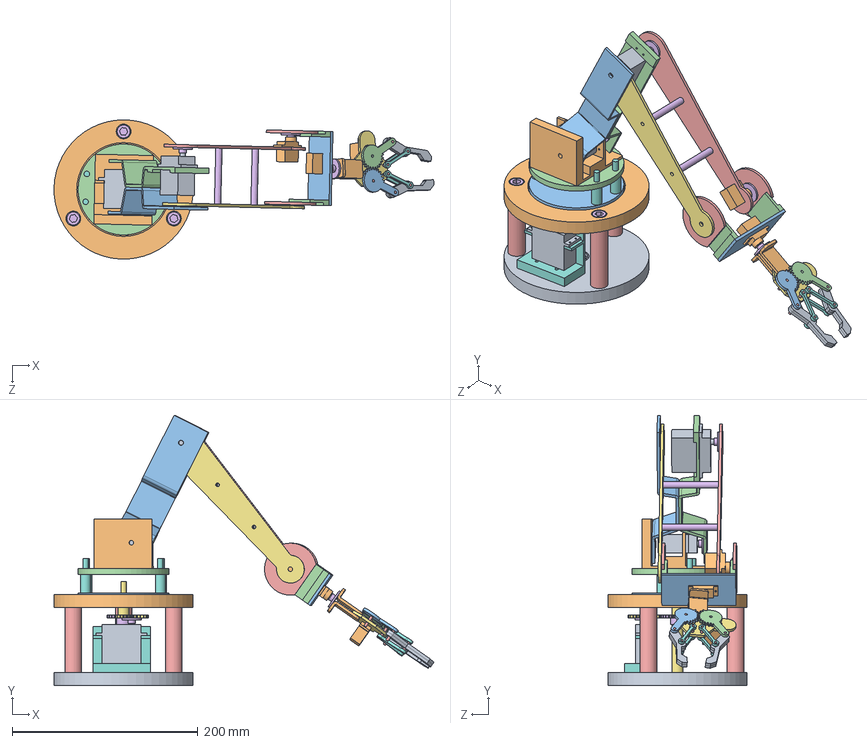
[picture p43: CAD file, 2026-05-25]
CAD/BASE ASSEMBLE.SLDASM
409.3 x 291.2 x 150.0 mm
Base Plate 1
Base Plate 2
base plate 3
base plate 4
base spacer x 3
Base Bolt x 3
shaft
Spacer Plate 4-5 x 4
Bearing x 2
Mounting 2
Arm 1
Arm 2
Front Arm 1
Upper Arm Spacer x 2
Front Arm 2
Mounting 1
Servo Motor 16 x 3
Servo Motor 6 x 3
Wrist 2
Wrist Support x 2
Wrist 1 x 2
Motor Head x 5
grip2
grip1 x 4
grip4 x 4
grip5 x 2
Gear 1
Gear 2
pin x 7
Shaft Gear
Base Gear
