harshwardhangiri/CV-Based-Robotic-Arm-TA212-/CAD/Gear 1.SLDPRT

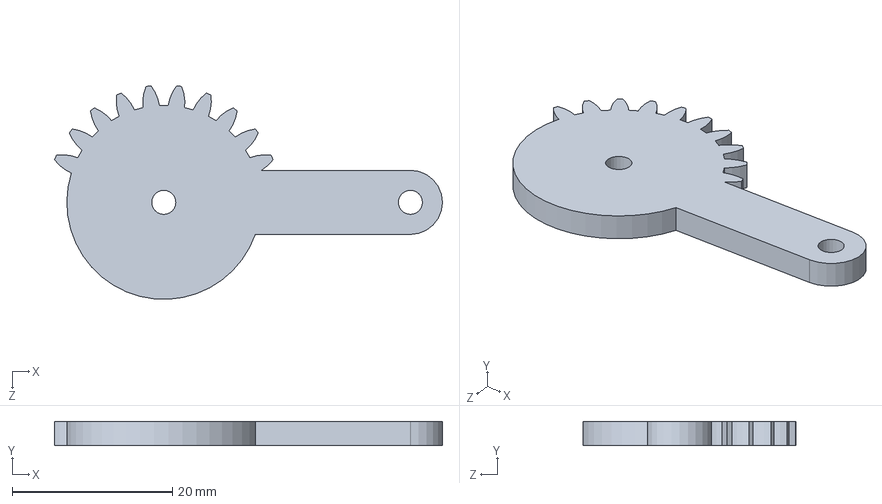
[picture p44: CAD file, 2026-05-25]
CAD/Gear 1.SLDPRT
48.4 x 3.00 x 26.6 mm
