harshwardhangiri/CV-Based-Robotic-Arm-TA212-/CAD/Wrist 2.SLDPRT

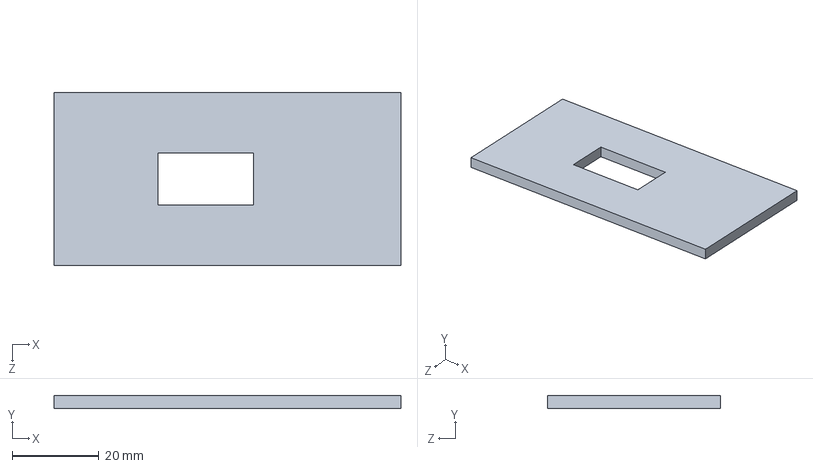
[picture p45: CAD file, 2026-05-25]
CAD/Wrist 2.SLDPRT
80.0 x 3.00 x 40.0 mm
