harshwardhangiri/CV-Based-Robotic-Arm-TA212-/CAD/Arm 1.SLDPRT

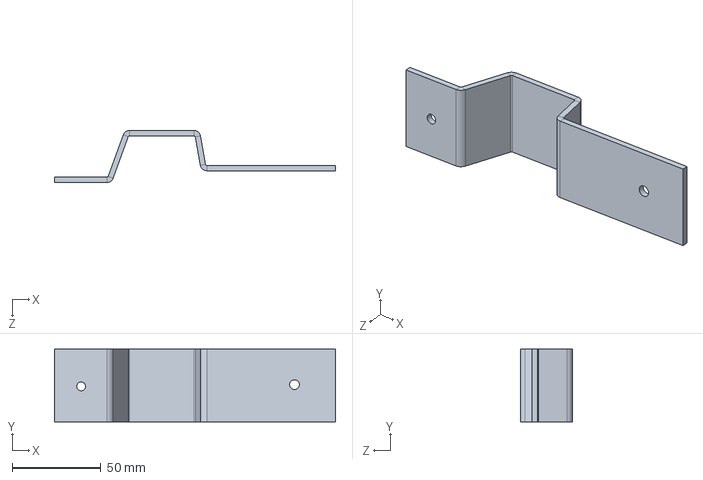
[picture p46: CAD file, 2026-05-25]
CAD/Arm 1.SLDPRT
158.0 x 41.0 x 29.3 mm
