harshwardhangiri/CV-Based-Robotic-Arm-TA212-/CAD/Base Spacer.SLDPRT

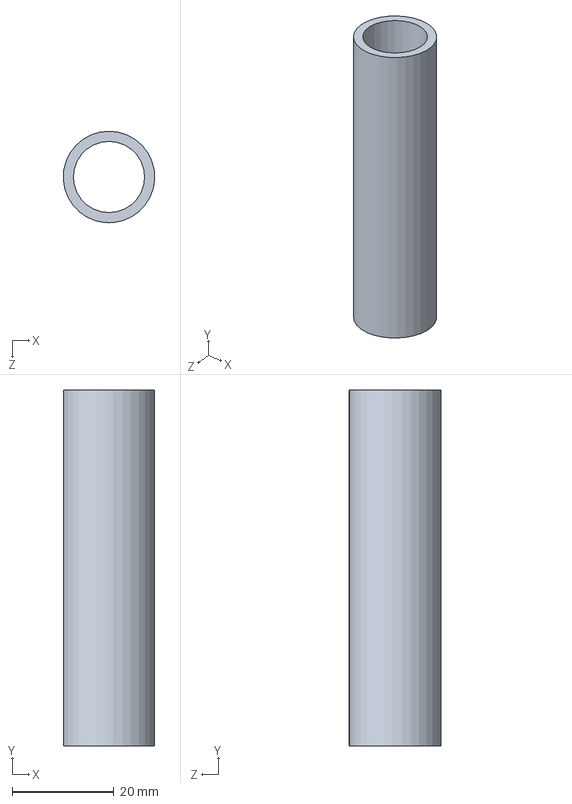
[picture p47: CAD file, 2026-05-25]
CAD/Base Spacer.SLDPRT
18.0 x 70.0 x 18.0 mm
