harshwardhangiri/CV-Based-Robotic-Arm-TA212-/CAD/Wrist 1.SLDPRT

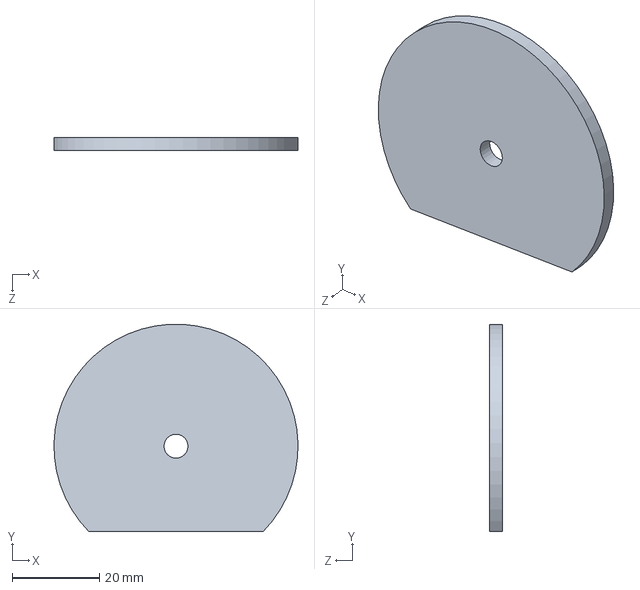
[picture p48: CAD file, 2026-05-25]
CAD/Wrist 1.SLDPRT
56.0 x 47.6 x 3.00 mm
