harshwardhangiri/CV-Based-Robotic-Arm-TA212-/CAD/grip2.SLDPRT

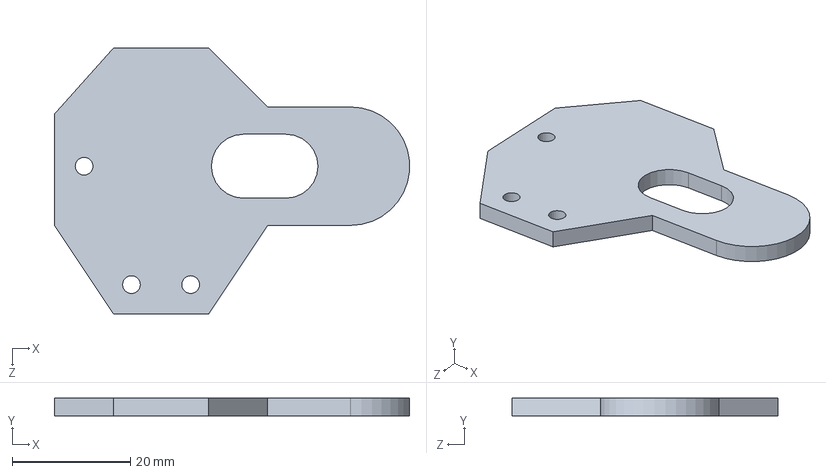
[picture p49: CAD file, 2026-05-25]
CAD/grip2.SLDPRT
60.0 x 3.00 x 45.0 mm
