harshwardhangiri/CV-Based-Robotic-Arm-TA212-/CAD/Base Plate 3.SLDPRT

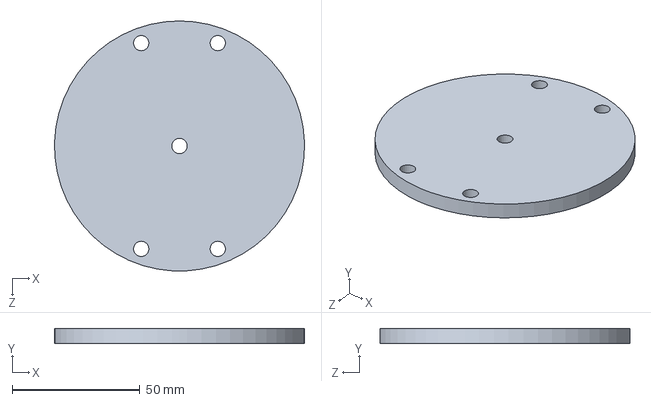
[picture p50: CAD file, 2026-05-25]
CAD/Base Plate 3.SLDPRT
98.0 x 6.00 x 98.0 mm
