harshwardhangiri/CV-Based-Robotic-Arm-TA212-/CAD/Mounting 2.SLDPRT

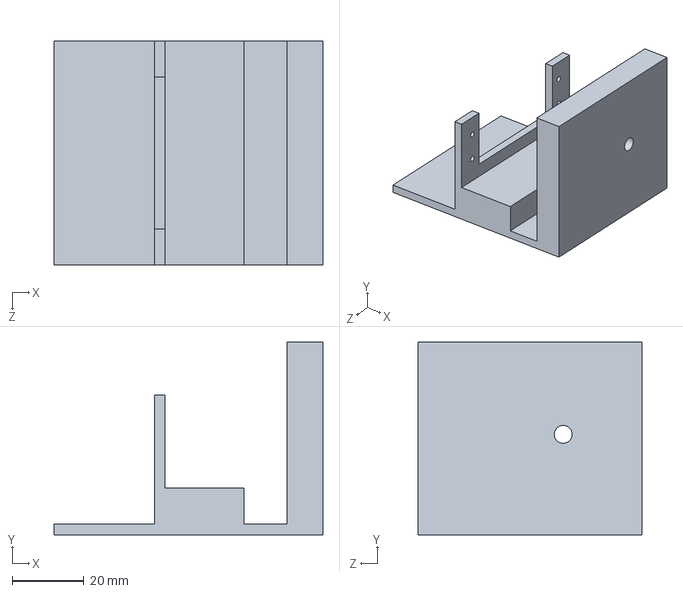
[picture p51: CAD file, 2026-05-25]
CAD/Mounting 2.SLDPRT
75.0 x 53.7 x 62.5 mm
