harshwardhangiri/CV-Based-Robotic-Arm-TA212-/CAD/Spacer Plate 4-5.SLDPRT

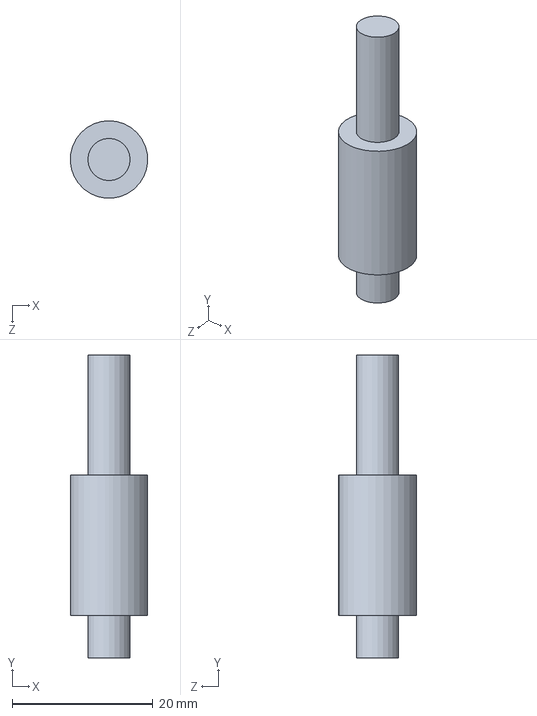
[picture p52: CAD file, 2026-05-25]
CAD/Spacer Plate 4-5.SLDPRT
11.0 x 43.0 x 11.0 mm
