harshwardhangiri/CV-Based-Robotic-Arm-TA212-/CAD/pin.SLDPRT

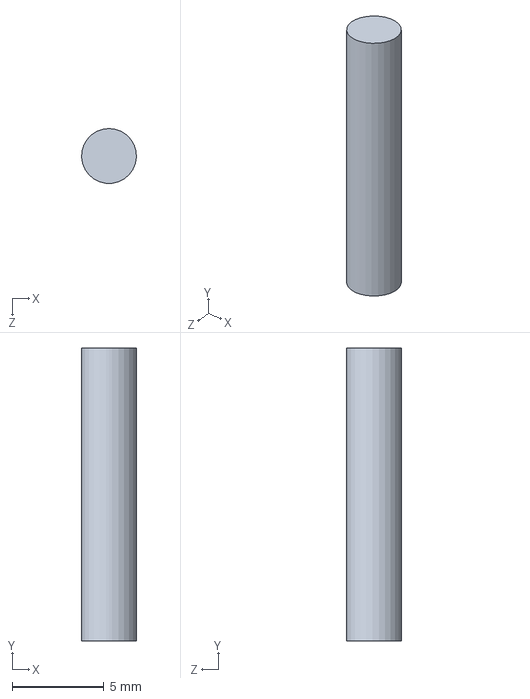
[picture p53: CAD file, 2026-05-25]
CAD/pin.SLDPRT
2.99 x 16.0 x 3.00 mm
