harshwardhangiri/CV-Based-Robotic-Arm-TA212-/CAD/Shaft.SLDPRT

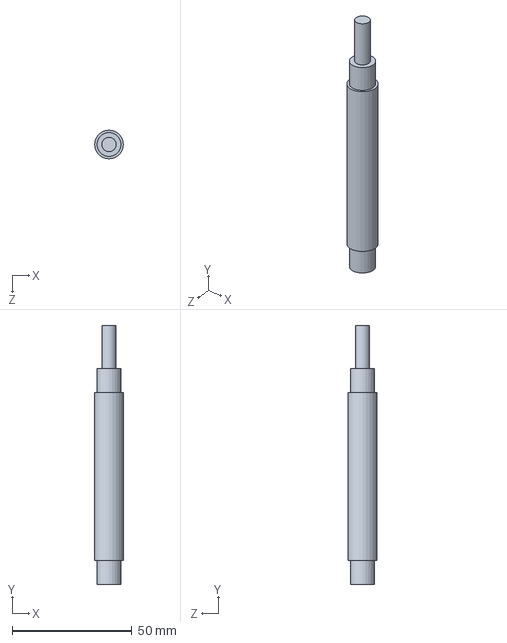
[picture p54: CAD file, 2026-05-25]
CAD/Shaft.SLDPRT
12.0 x 108.0 x 12.0 mm
