harshwardhangiri/CV-Based-Robotic-Arm-TA212-/CAD/Arm 2.SLDPRT

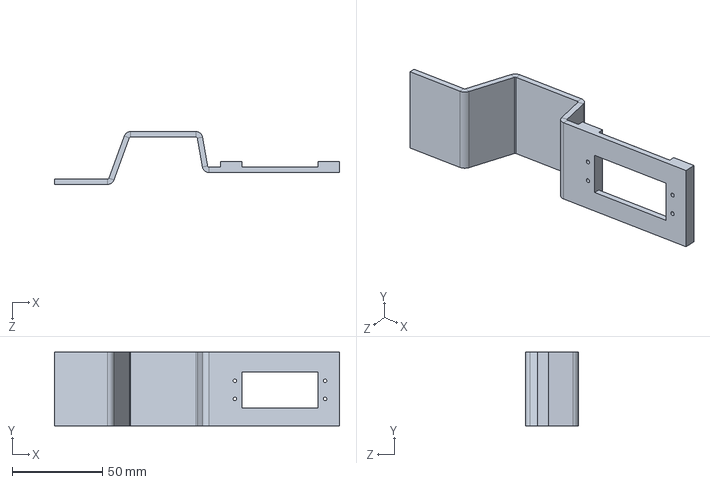
[picture p55: CAD file, 2026-05-25]
CAD/Arm 2.SLDPRT
158.0 x 41.0 x 29.3 mm
