harshwardhangiri/CV-Based-Robotic-Arm-TA212-/CAD/Upper Arm Spacer.SLDPRT

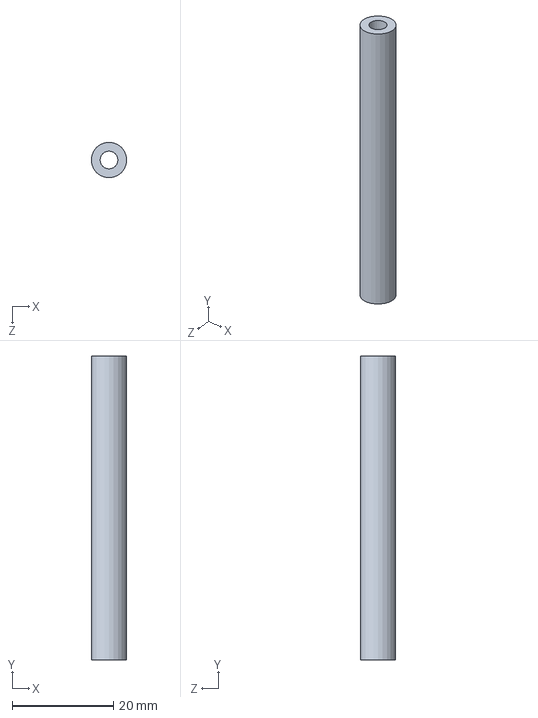
[picture p56: CAD file, 2026-05-25]
CAD/Upper Arm Spacer.SLDPRT
7.00 x 60.0 x 7.00 mm
