harshwardhangiri/CV-Based-Robotic-Arm-TA212-/CAD/Servo Motor 16.SLDPRT

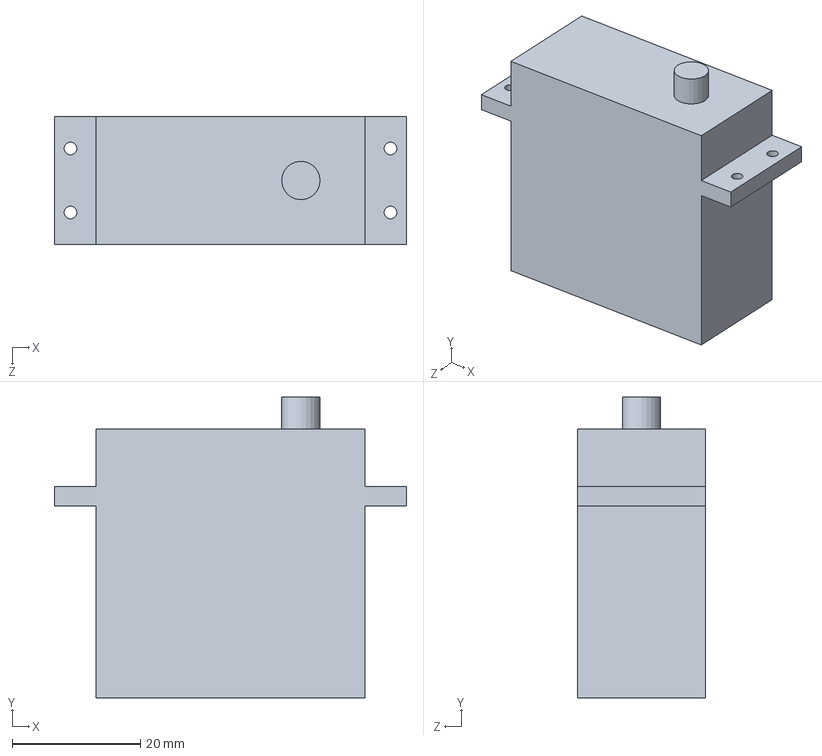
[picture p57: CAD file, 2026-05-25]
CAD/Servo Motor 16.SLDPRT
55.0 x 47.0 x 20.0 mm
