harshwardhangiri/CV-Based-Robotic-Arm-TA212-/CAD/Gear 2.SLDPRT

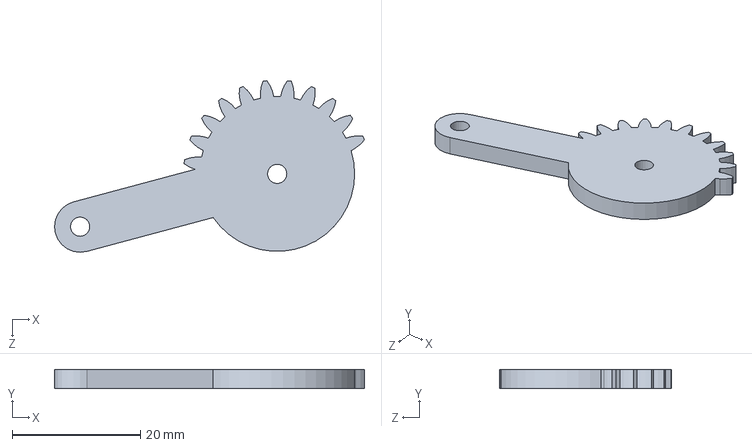
[picture p58: CAD file, 2026-05-25]
CAD/Gear 2.SLDPRT
48.4 x 3.00 x 26.8 mm
