harshwardhangiri/CV-Based-Robotic-Arm-TA212-/CAD/grip1.SLDPRT

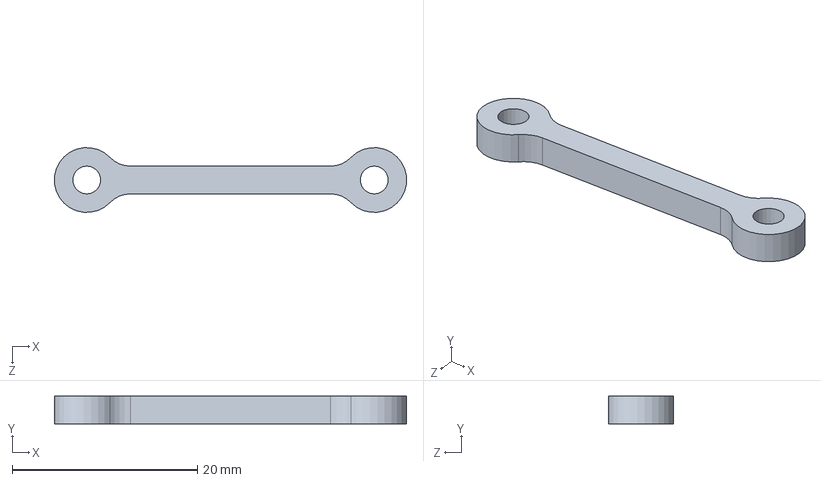
[picture p59: CAD file, 2026-05-25]
CAD/grip1.SLDPRT
38.0 x 3.00 x 6.97 mm
