harshwardhangiri/CV-Based-Robotic-Arm-TA212-/CAD/Motor Head.SLDPRT

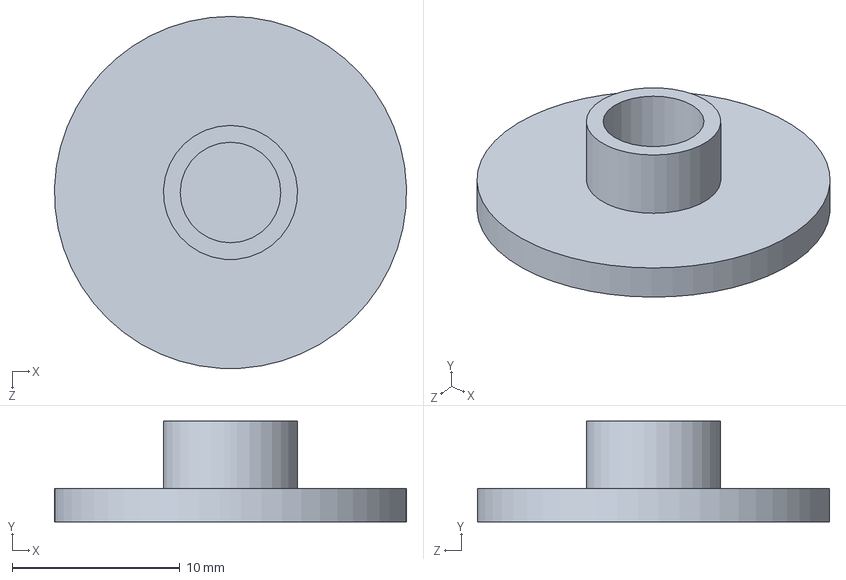
[picture p60: CAD file, 2026-05-25]
CAD/Motor Head.SLDPRT
21.0 x 6.00 x 21.0 mm
