harshwardhangiri/CV-Based-Robotic-Arm-TA212-/CAD/Servo Motor 6.SLDPRT

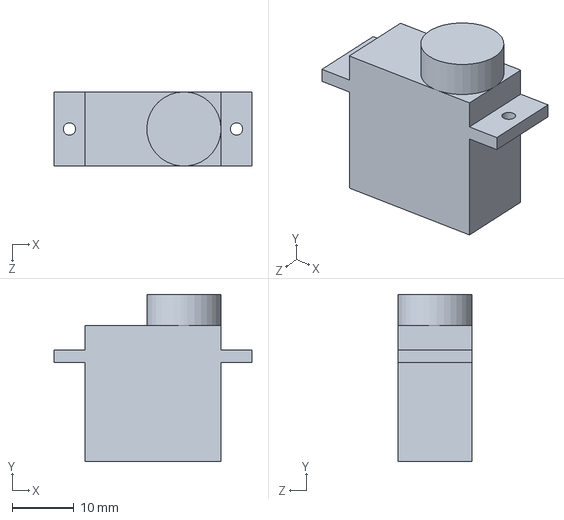
[picture p61: CAD file, 2026-05-25]
CAD/Servo Motor 6.SLDPRT
32.0 x 27.0 x 12.0 mm
