harshwardhangiri/CV-Based-Robotic-Arm-TA212-/CAD/Base Gear.SLDPRT

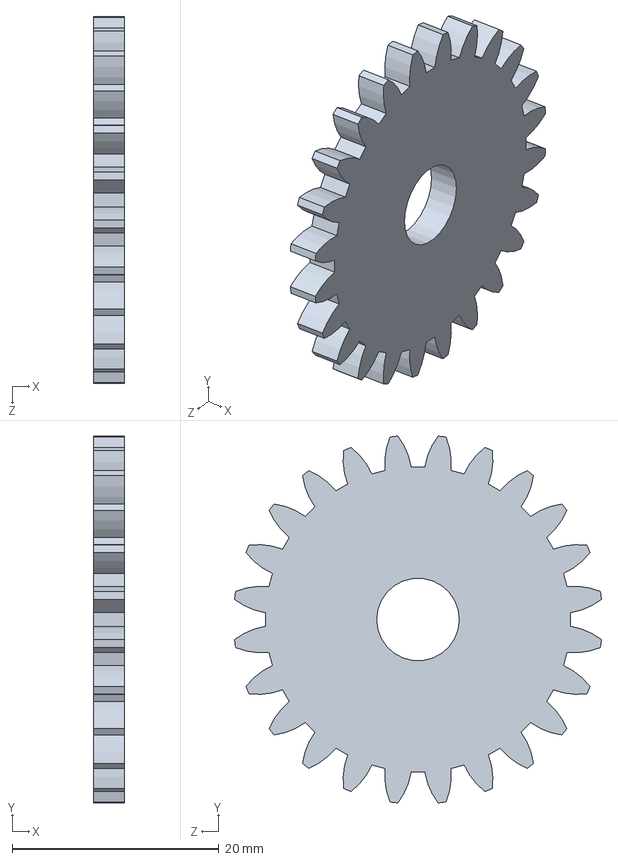
[picture p62: CAD file, 2026-05-25]
CAD/Base Gear.SLDPRT
3.00 x 35.5 x 35.5 mm
