harshwardhangiri/CV-Based-Robotic-Arm-TA212-/CAD/Front Arm 1.SLDPRT

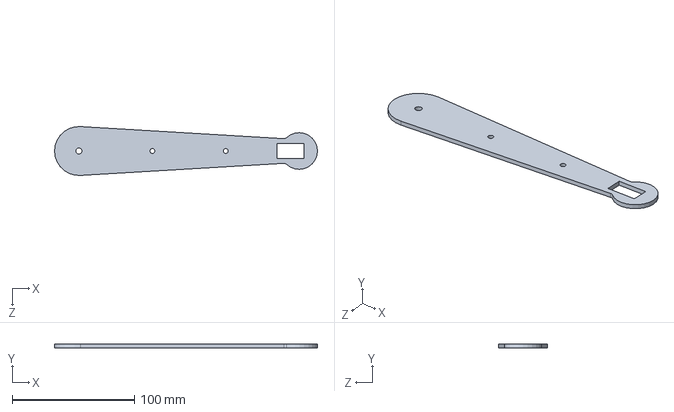
[picture p63: CAD file, 2026-05-25]
CAD/Front Arm 1.SLDPRT
215.0 x 3.00 x 39.9 mm
