harshwardhangiri/CV-Based-Robotic-Arm-TA212-/CAD/grip4.SLDPRT

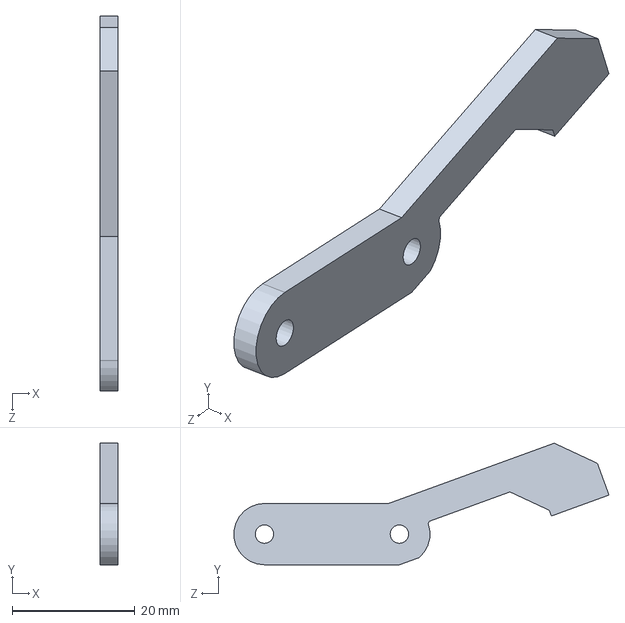
[picture p64: CAD file, 2026-05-25]
CAD/grip4.SLDPRT
3.00 x 19.8 x 61.1 mm
