harshwardhangiri/CV-Based-Robotic-Arm-TA212-/CAD/Shaft Gear.SLDPRT

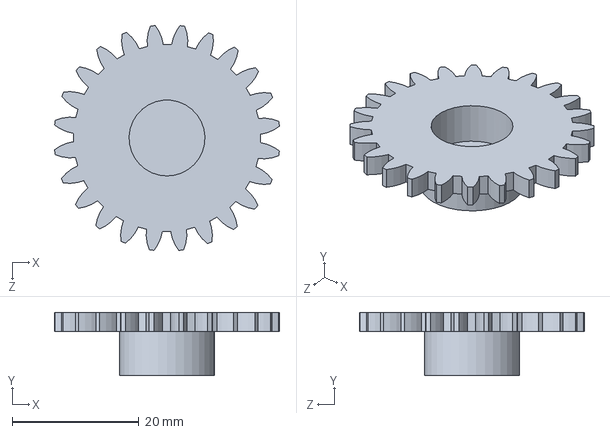
[picture p65: CAD file, 2026-05-25]
CAD/Shaft Gear.SLDPRT
35.6 x 10.0 x 35.6 mm
