harshwardhangiri/CV-Based-Robotic-Arm-TA212-/CAD/Mounting 1.SLDPRT

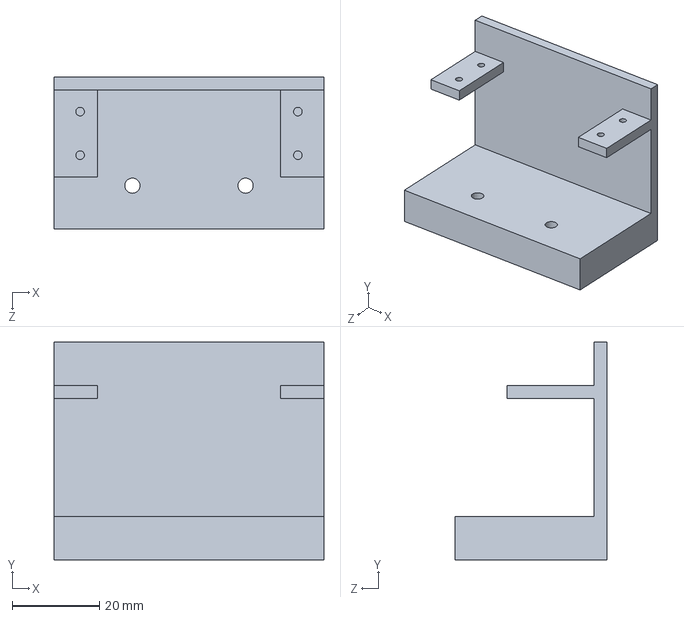
[picture p66: CAD file, 2026-05-25]
CAD/Mounting 1.SLDPRT
62.0 x 50.0 x 35.0 mm
