harshwardhangiri/CV-Based-Robotic-Arm-TA212-/CAD/Bearing.SLDPRT

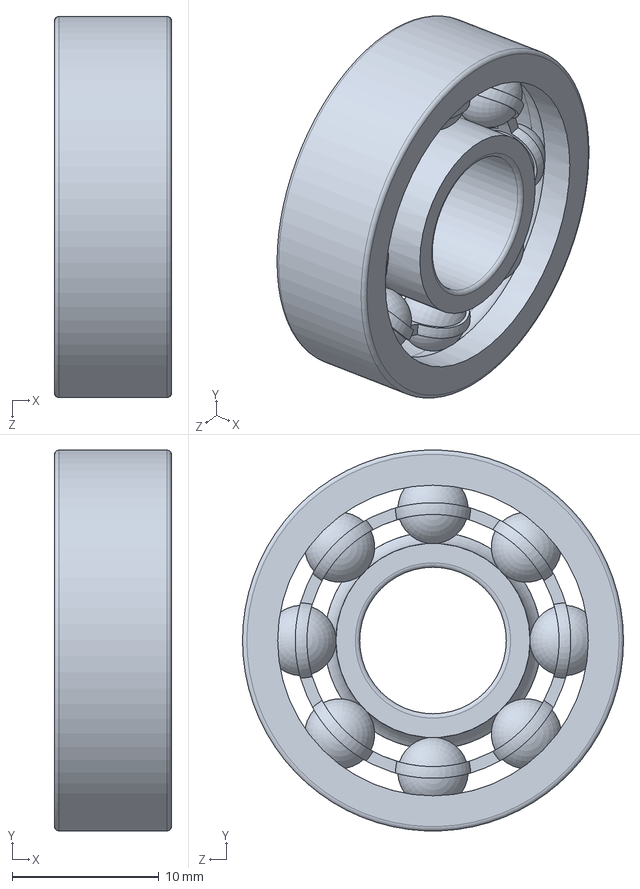
[picture p67: CAD file, 2026-05-25]
CAD/Bearing.SLDPRT
8.00 x 26.0 x 26.0 mm
