harshwardhangiri/CV-Based-Robotic-Arm-TA212-/CAD/Wrist Support.SLDPRT

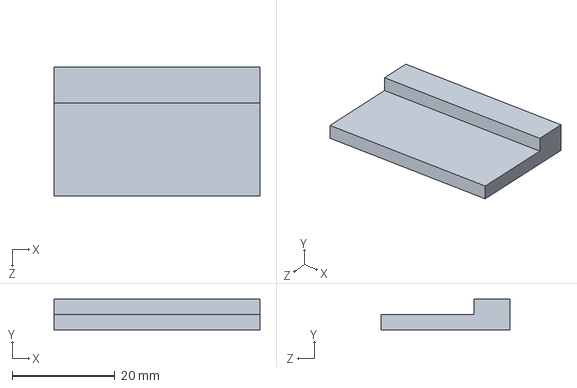
[picture p68: CAD file, 2026-05-25]
CAD/Wrist Support.SLDPRT
40.0 x 6.00 x 25.0 mm
