harshwardhangiri/CV-Based-Robotic-Arm-TA212-/CAD/grip5.SLDPRT

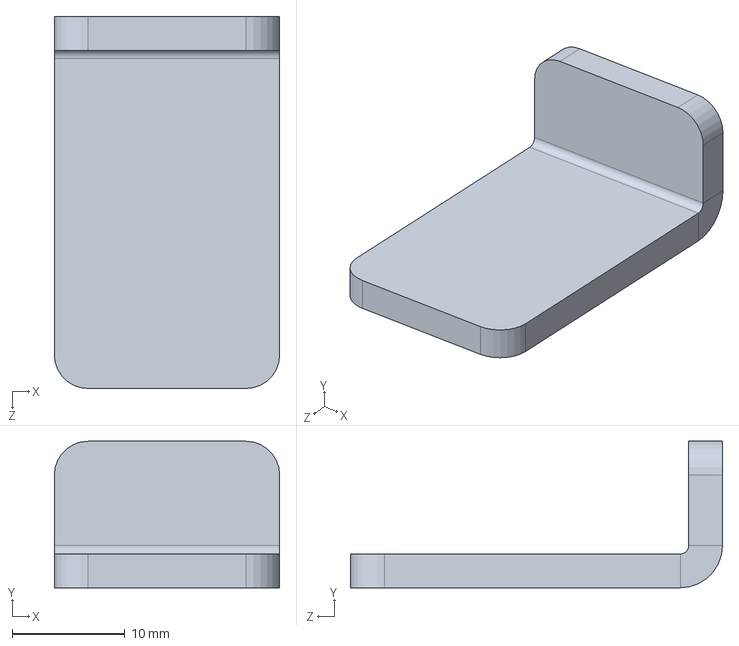
[picture p69: CAD file, 2026-05-25]
CAD/grip5.SLDPRT
20.0 x 13.0 x 33.0 mm
