harshwardhangiri/CV-Based-Robotic-Arm-TA212-/CAD/Base Plate 2.SLDPRT

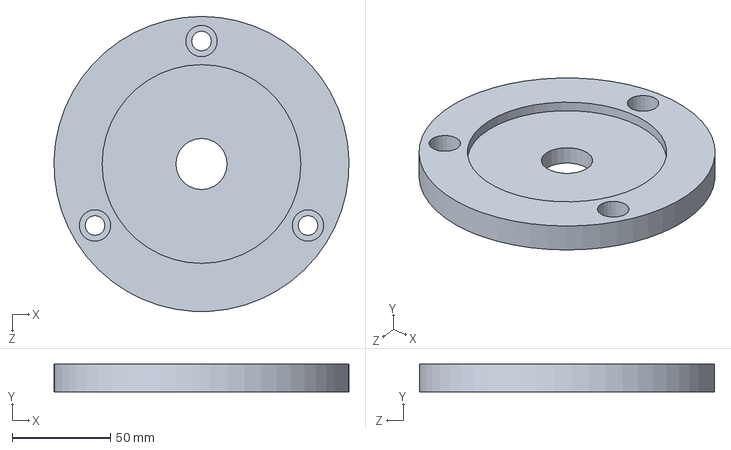
[picture p71: CAD file, 2026-05-25]
CAD/Base Plate 2.SLDPRT
149.9 x 14.0 x 150.0 mm
