harshwardhangiri/CV-Based-Robotic-Arm-TA212-/(list of files, cad)

Other CAD files:
CAD/Front Arm 2.SLDPRT
CAD/Base Plate 4.SLDPRT
CAD/Base Bolt.SLDPRT
CAD/hex nut style 1 gradeab_iso.sldprt
