harshwardhangiri/CV-Based-Robotic-Arm-TA212-/servo_control.ino

#include <Wire.h>
#include <Adafruit_PWMServoDriver.h>

Adafruit_PWMServoDriver pca = Adafruit_PWMServoDriver();

// ===== SERVO LIMITS =====
#define SERVOMIN  150   // pulse for 0°
#define SERVOMAX  600   // pulse for 180°

int angles[6] = {90, 90, 90, 90, 90, 60};   // current
int target[6] = {90, 90, 90, 90, 90, 60};   // incoming

String input = "";

// ===== MAP ANGLE → PWM =====
int angleToPulse(int angle) {
  return map(angle, 0, 180, SERVOMIN, SERVOMAX);
}

void setup() {
  Serial.begin(115200);

  pca.begin();
  pca.setPWMFreq(50);  // standard servo frequency

  delay(500);

  // Initialize servos to default position
  for (int i = 0; i < 6; i++) {
    pca.setPWM(i, 0, angleToPulse(angles[i]));
  }
}

void loop() {

  // ===== READ SERIAL =====
  if (Serial.available()) {
    input = Serial.readStringUntil('\n');

    int i = 0;
    char *token = strtok((char*)input.c_str(), ",");

    while (token != NULL && i < 6) {
      target[i++] = atoi(token);
      token = strtok(NULL, ",");
    }
  }

  // ===== SMOOTH MOVEMENT =====
  for (int i = 0; i < 6; i++) {
    angles[i] = 0.7 * angles[i] + 0.3 * target[i];
  }

  // ===== APPLY TO PCA9685 =====
  for (int ch = 0; ch < 6; ch++) {
    int pulse = angleToPulse(angles[ch]);
    pca.setPWM(ch, 0, pulse);
  }

  delay(20);  // smooth update rate
}
